timvideos/HDMI2USB-TOFE-VGA/README.md

# VGA TOFE Expansion Board

This repository contains a TOFE board for VGA capture based on 
[Rohit's vmodvga board](https://github.com/timvideos/HDMI2USB-vmodvga).

For [more information on the TOFE interface, see the HDMI2USB website](http://hdmi2usb.tv/tofe).
For the [KiCad website](http://kicad.org/) for more information on using it.

## Parts

The RCA Jack is a little hard to find, but it can be found at the following
locations (it is also totally optional);

 * [Element14](http://au.element14.com/pro-signal/mr-100h/socket-phono-pcb/dp/1267381) - Order Code: 1267381

## License

The contents of this repository excluding "third_party" folder is released
under your choice of the following two licences:

 * the "Creative Commons Attribution-ShareAlike 4.0 International License" (CC
   BY-SA 4.0) full text of this license is included in the LICENSE file and a
   copy can also be found at http://creativecommons.org/licenses/by-sa/4.0/

 * the "TAPR Open Hardware License" full text of this license is included in
   the LICENSE file and a copy can also be found at http://www.tapr.org/OHL

Both these licenses are "share and share alike" licenses and require **any**
derivative work to also be released. Please read the license fully to make sure
you comply with all your obligations.  

## Authors

This board has been a joint effort from many people, some of the major
contributors are;

 * Phyllis McKeever <mccircuit@yahoo.com>
 * Tim 'mithro' Ansell <mithro@mithis.com>
 * Kenny Duffus <kenny@duffus.org>
 * Rohit Kumar Singh <rohit@gmx.it>
 * Jahanzeb Ahmad <jahanzeb1982@gmail.com>

----

Original documentation from vmodvga board.

## Documentation

 * [Project blog](https://dreamsxtrinsic.blogspot.com/) for weekly and daily updates
 * [vMod-VGA Code Block Diagram](https://docs.google.com/drawings/d/1-_QcqhuEnqGTb0JCZim7DaP1v0BfKb7fcv-28n1iaC0/edit?usp=sharing)
 * [Code structure explained in this document](https://docs.google.com/document/d/11dfCeLtNUrjcst97REtgqLIln-_pKwHgGT3xKjOamxs/edit?usp=sharing)
 * [vMod-VGA VHDCI Pin Usage](https://docs.google.com/spreadsheets/d/1f-rBfR98f_ZZNIB7GFV79CGSHQNpj47uOU0JDwOJnV8/edit?usp=sharing)
 * [AD9984A Register Settings](https://docs.google.com/spreadsheets/d/1GH8NDtB8ceGhJEVZQujcXdxDPSw_wLqhg_3s436kkSs/edit?usp=sharing) for easier register settings
 * [Code Test points](https://docs.google.com/spreadsheets/d/12sMpliuKs6eSY12Fc8JHHKd0Y-Cz1OmEMRZJ5Vne3Vg/edit?usp=sharing) I compiled during whole project during
 * [Autodetection guidelines](https://docs.google.com/document/d/1ZhDz50rve5UmnmyKynxySLHqfFuOwBPM7pYFoHo9uvs/edit?usp=sharing)
 * [I2C Tools & Debugging](https://docs.google.com/document/d/1rNem5J1_V4QUOei_MHRzZVJfjsTon8fnE3eTlhzsrj8/edit?usp=sharing)
 * [PCB v02 Requirements Doc](https://docs.google.com/document/d/1EVi7m_RxV2RLTFDjguj92tawxPkJdG1kjHW0T4Z_cDw/edit?usp=sharing)
