timvideos/HDMI2USB-TOFE-VGA/eeprom/README.md

Tools for generating the EEPROM contents will be in this folder.

FIXME: Actually put something here.

We can probably reuse the work done by these two groups;

 * [Raspberry Pi Hat specification](https://github.com/raspberrypi/hats/tree/master/eepromutils)
 * [Beagleboard Cape specification](http://elinux.org/Beagleboard:Cape_Expansion_Headers#Cape_EEPROM_Contents)
