timvideos/HDMI2USB-TOFE-VGA/examples/hdmi-output-implementation/README.md

#vMod-VGA Development Test Codes

###Folder Structure

* hdl       : All HDL codes
  - hdmi    : HDMI (DVI) codes
  - misc    : Miscellaneous codes such Pattern generatir and Rising edge detector
  - uart    : UART Debugging code by Ajit
  - vga     : VGA Capture codes
* ipcore_dir: For IP Cores
* ise       : For all ise project files
* ucf       : User constraints
* i2c       : I2C Test codes for BeagleboneBlack
