timvideos/HDMI2USB-TOFE-VGA/examples/hdmi-output-implementation/ipcore_dir/UART_clk_flist.txt

# Output products list for <UART_clk>
UART_clk.asy
UART_clk.gise
UART_clk.sym
UART_clk.ucf
UART_clk.vhd
UART_clk.vho
UART_clk.xco
UART_clk.xdc
UART_clk.xise
UART_clk\clk_wiz_v3_6_readme.txt
UART_clk\doc\clk_wiz_v3_6_readme.txt
UART_clk\doc\clk_wiz_v3_6_vinfo.html
UART_clk\doc\pg065_clk_wiz.pdf
UART_clk\example_design\UART_clk_exdes.ucf
UART_clk\example_design\UART_clk_exdes.vhd
UART_clk\example_design\UART_clk_exdes.xdc
UART_clk\implement\implement.bat
UART_clk\implement\implement.sh
UART_clk\implement\planAhead_ise.bat
UART_clk\implement\planAhead_ise.sh
UART_clk\implement\planAhead_ise.tcl
UART_clk\implement\planAhead_rdn.bat
UART_clk\implement\planAhead_rdn.sh
UART_clk\implement\planAhead_rdn.tcl
UART_clk\implement\xst.prj
UART_clk\implement\xst.scr
UART_clk\simulation\UART_clk_tb.vhd
UART_clk\simulation\functional\simcmds.tcl
UART_clk\simulation\functional\simulate_isim.bat
UART_clk\simulation\functional\simulate_isim.sh
UART_clk\simulation\functional\simulate_mti.bat
UART_clk\simulation\functional\simulate_mti.do
UART_clk\simulation\functional\simulate_mti.sh
UART_clk\simulation\functional\simulate_ncsim.sh
UART_clk\simulation\functional\simulate_vcs.sh
UART_clk\simulation\functional\wave.do
UART_clk\simulation\functional\wave.sv
UART_clk\simulation\timing\UART_clk_tb.vhd
UART_clk\simulation\timing\sdf_cmd_file
UART_clk\simulation\timing\simcmds.tcl
UART_clk\simulation\timing\simulate_isim.sh
UART_clk\simulation\timing\simulate_mti.bat
UART_clk\simulation\timing\simulate_mti.do
UART_clk\simulation\timing\simulate_mti.sh
UART_clk\simulation\timing\simulate_ncsim.sh
UART_clk\simulation\timing\simulate_vcs.sh
UART_clk\simulation\timing\ucli_commands.key
UART_clk\simulation\timing\vcs_session.tcl
UART_clk\simulation\timing\wave.do
UART_clk_flist.txt
UART_clk_xmdf.tcl
