timvideos/HDMI2USB-TOFE-VGA/img/tofe-full-height.png

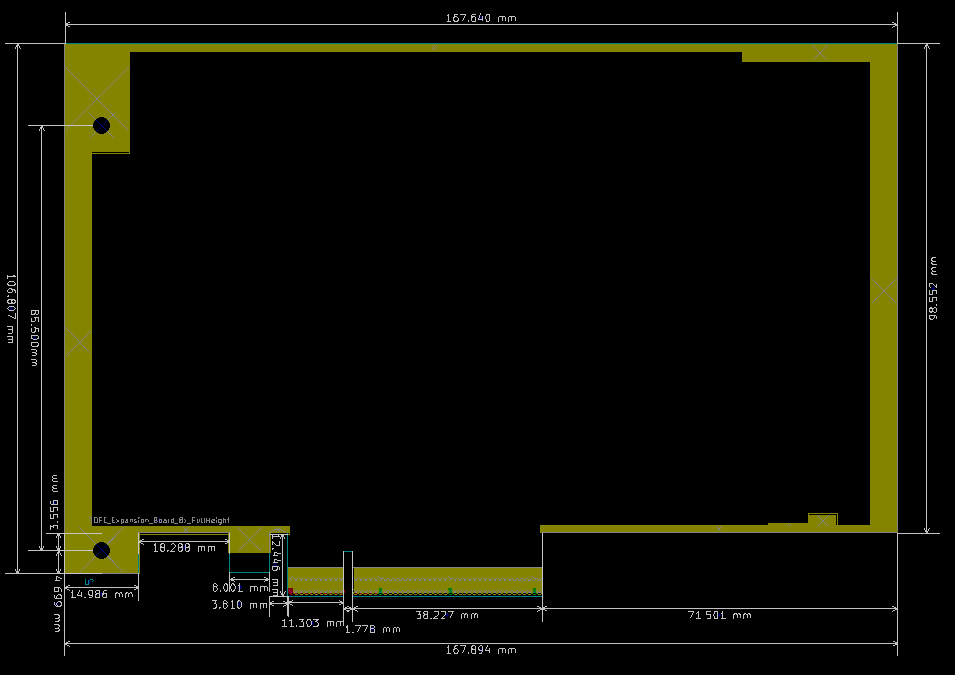
img/tofe-full-height.png
