timvideos/HDMI2USB-TOFE-VGA/img/tofe-half-height.png

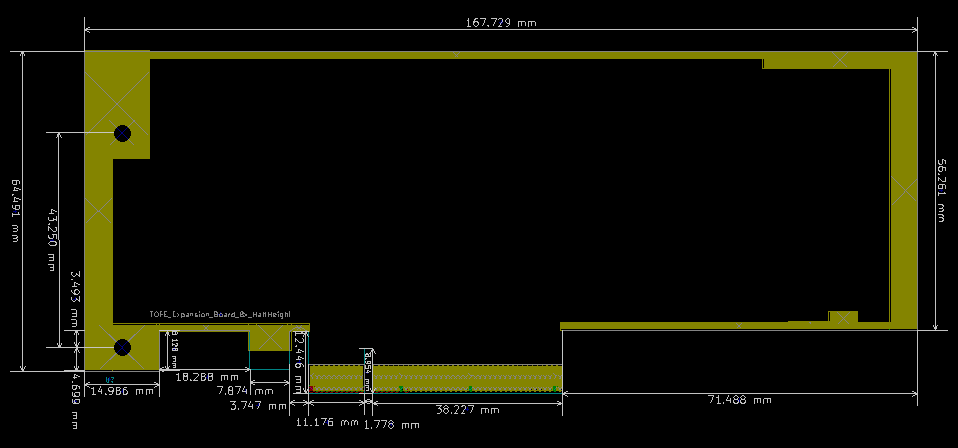
img/tofe-half-height.png
