timvideos/HDMI2USB-TOFE-VGA/(list of files, cad)

Other CAD files:
examples/hdmi-output-implementation/hdl/i2c/picoblaze/ad9984a_init.psm
examples/hdmi-output-implementation/hdl/i2c/picoblaze/ad9984a_init_bak.psm
examples/hdmi-output-implementation/hdl/i2c/picoblaze/ad9984a_init_pcf9574a_test.psm
examples/hdmi-output-implementation/hdl/i2c/picoblaze/i2c_routines.psm
examples/hdmi-output-implementation/hdl/i2c/picoblaze/soft_delays_100mhz.psm
