timvideos/HDMI2USB-TOFE-VGA/board/TOFE-VGA.pdf

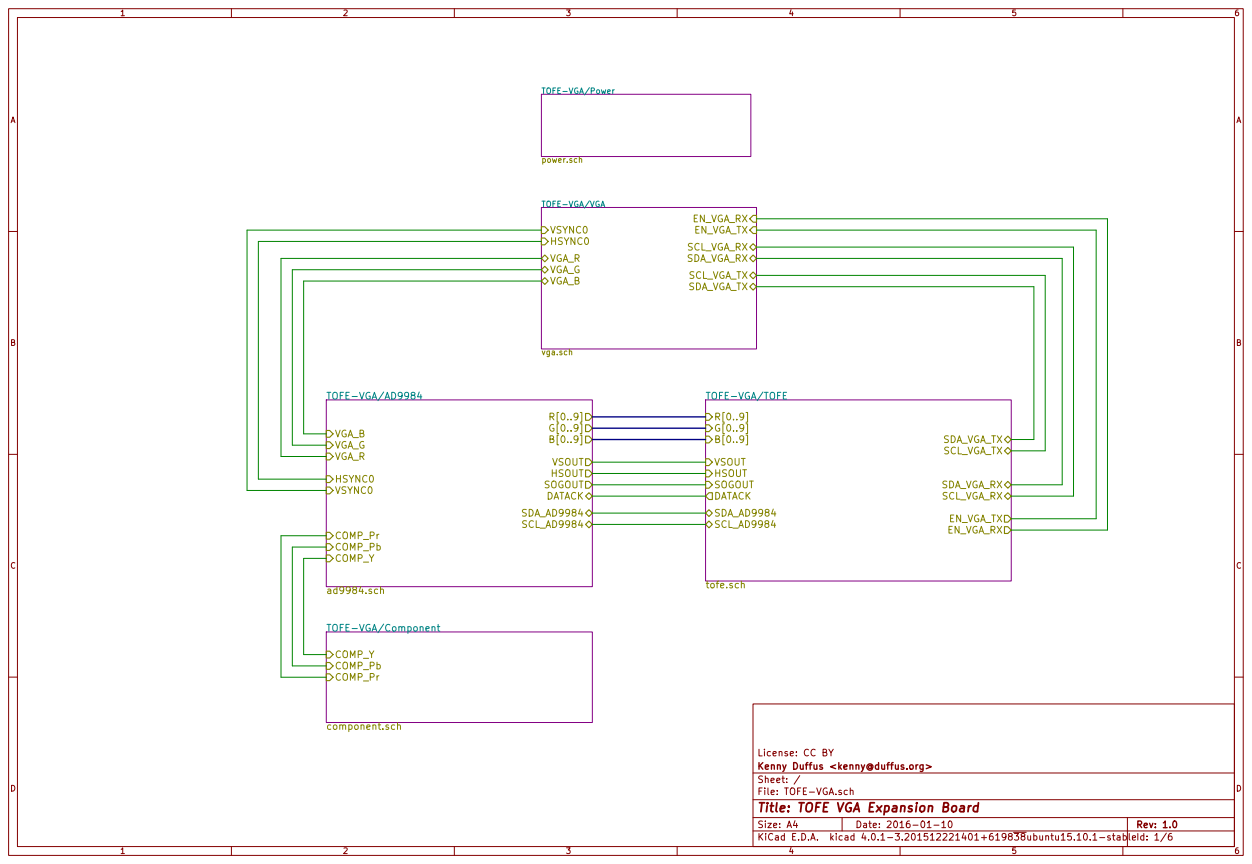
[picture p3: page 1]

TOFE-VGA/Power power.sch

License: CC BY
File: TOFE-VGA.sch Sheet: / Kenny Duffus <kenny@duffus.org>

Id: 1/6 Title: TOFE VGA Expansion Board

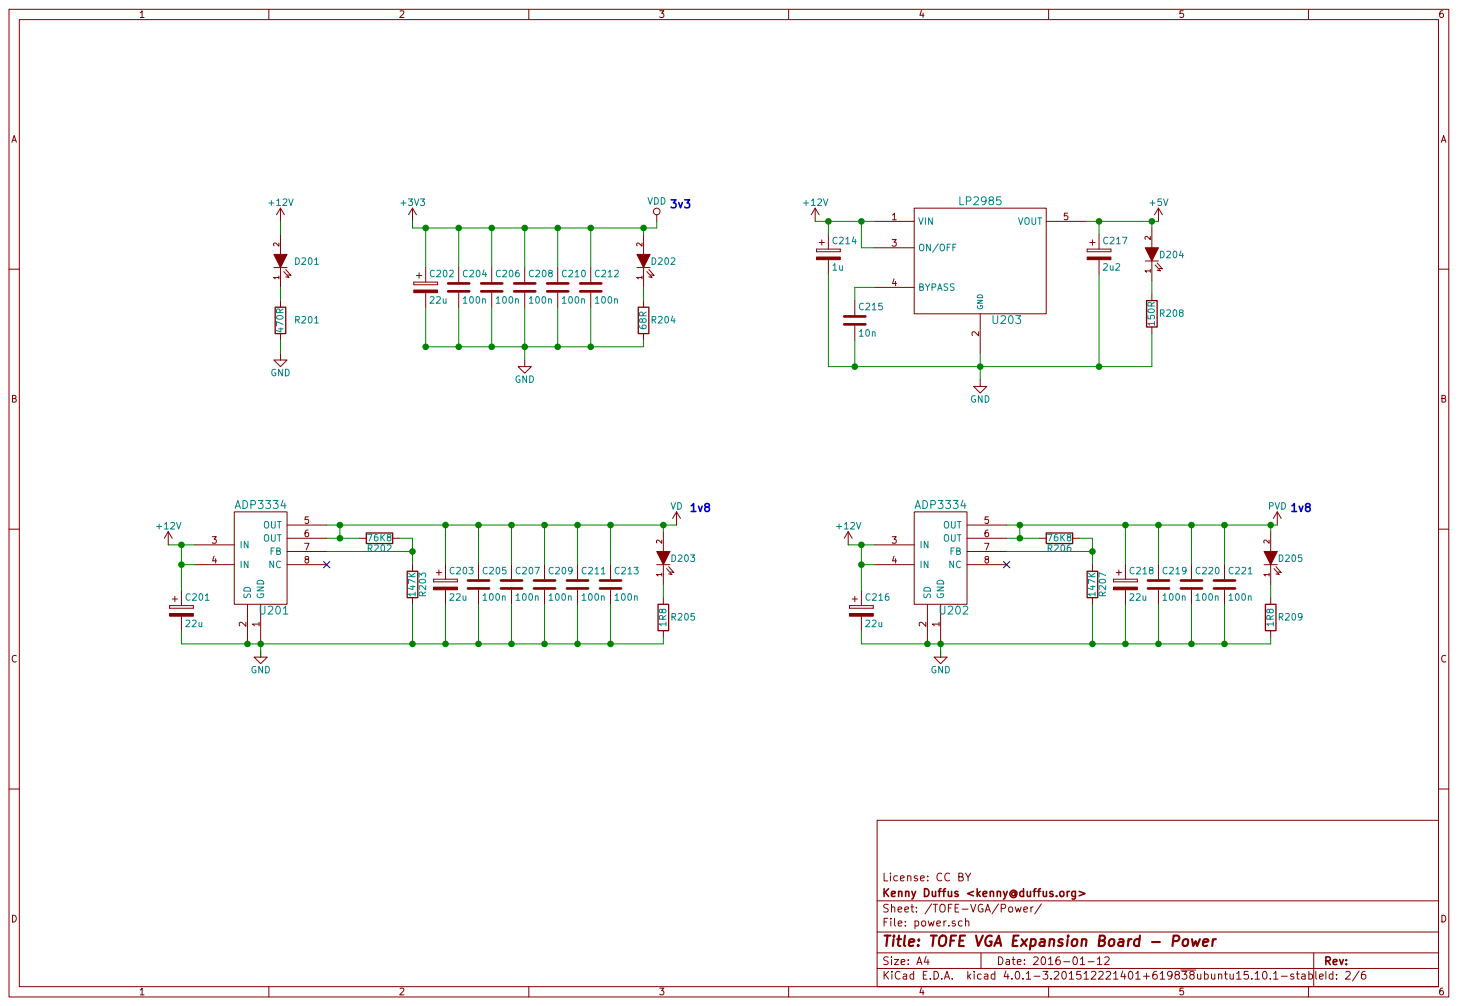
[picture p4: page 2]

2 ON/OFF 3 BYPASS 4 VOUT 5 U203

License: CC BY
File: power.sch Sheet: /TOFE-VGA/Power/ Kenny Duffus <kenny@duffus.org>

Id: 2/6 Title: TOFE VGA Expansion Board - Power

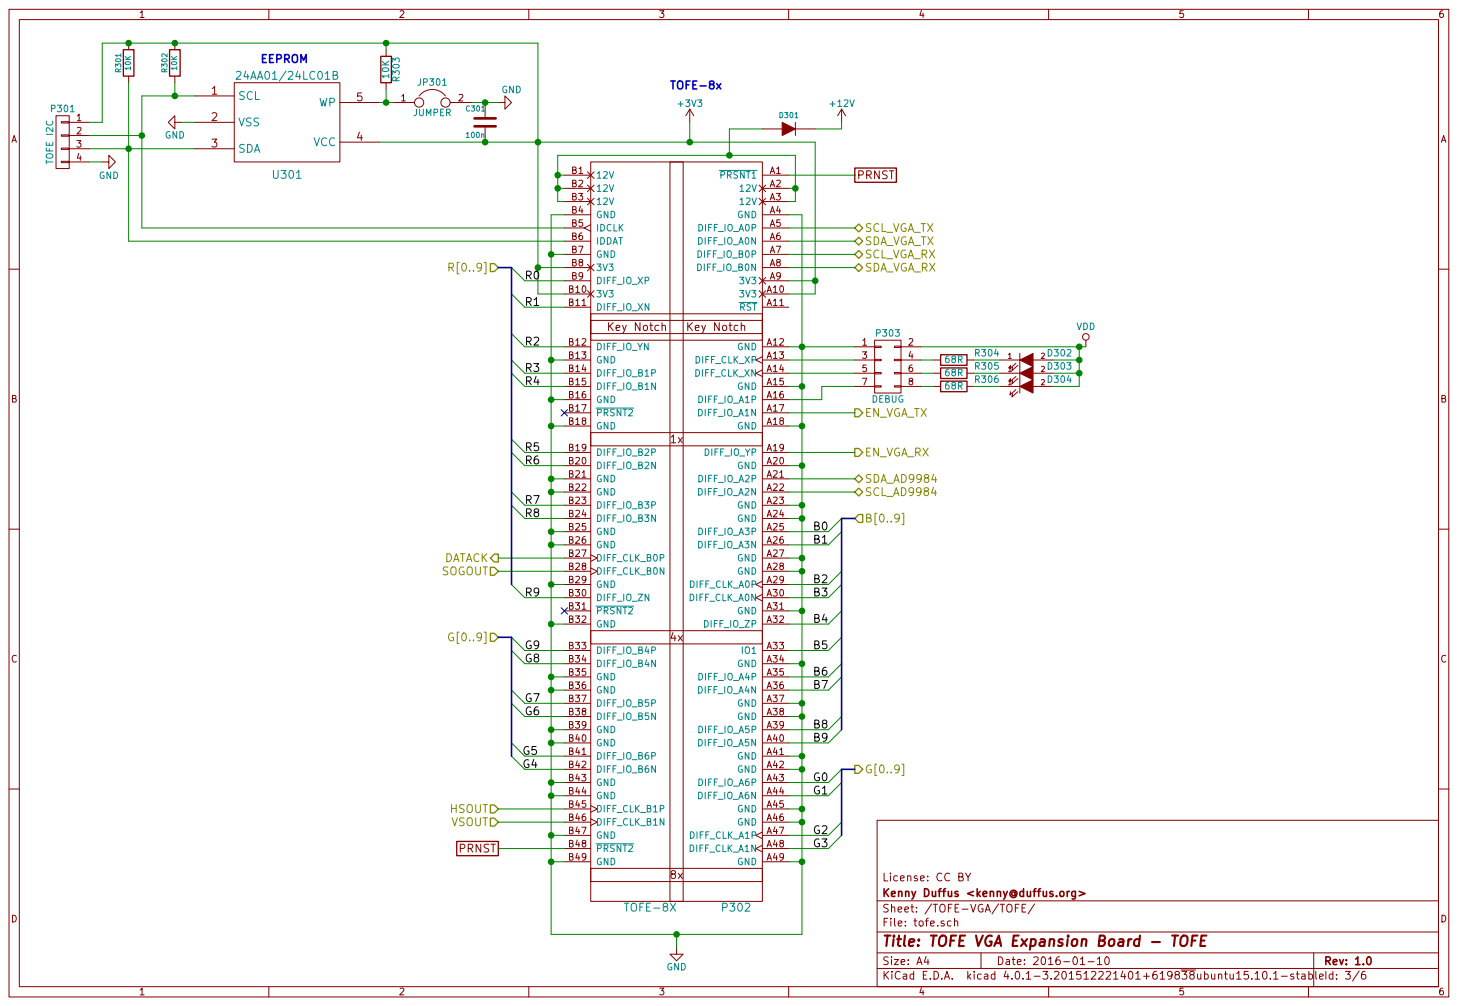
[picture p5: page 3]

License: CC BY
File: tofe.sch Sheet: /TOFE-VGA/TOFE/ Kenny Duffus <kenny@duffus.org>

Id: 3/6 Title: TOFE VGA Expansion Board - TOFE

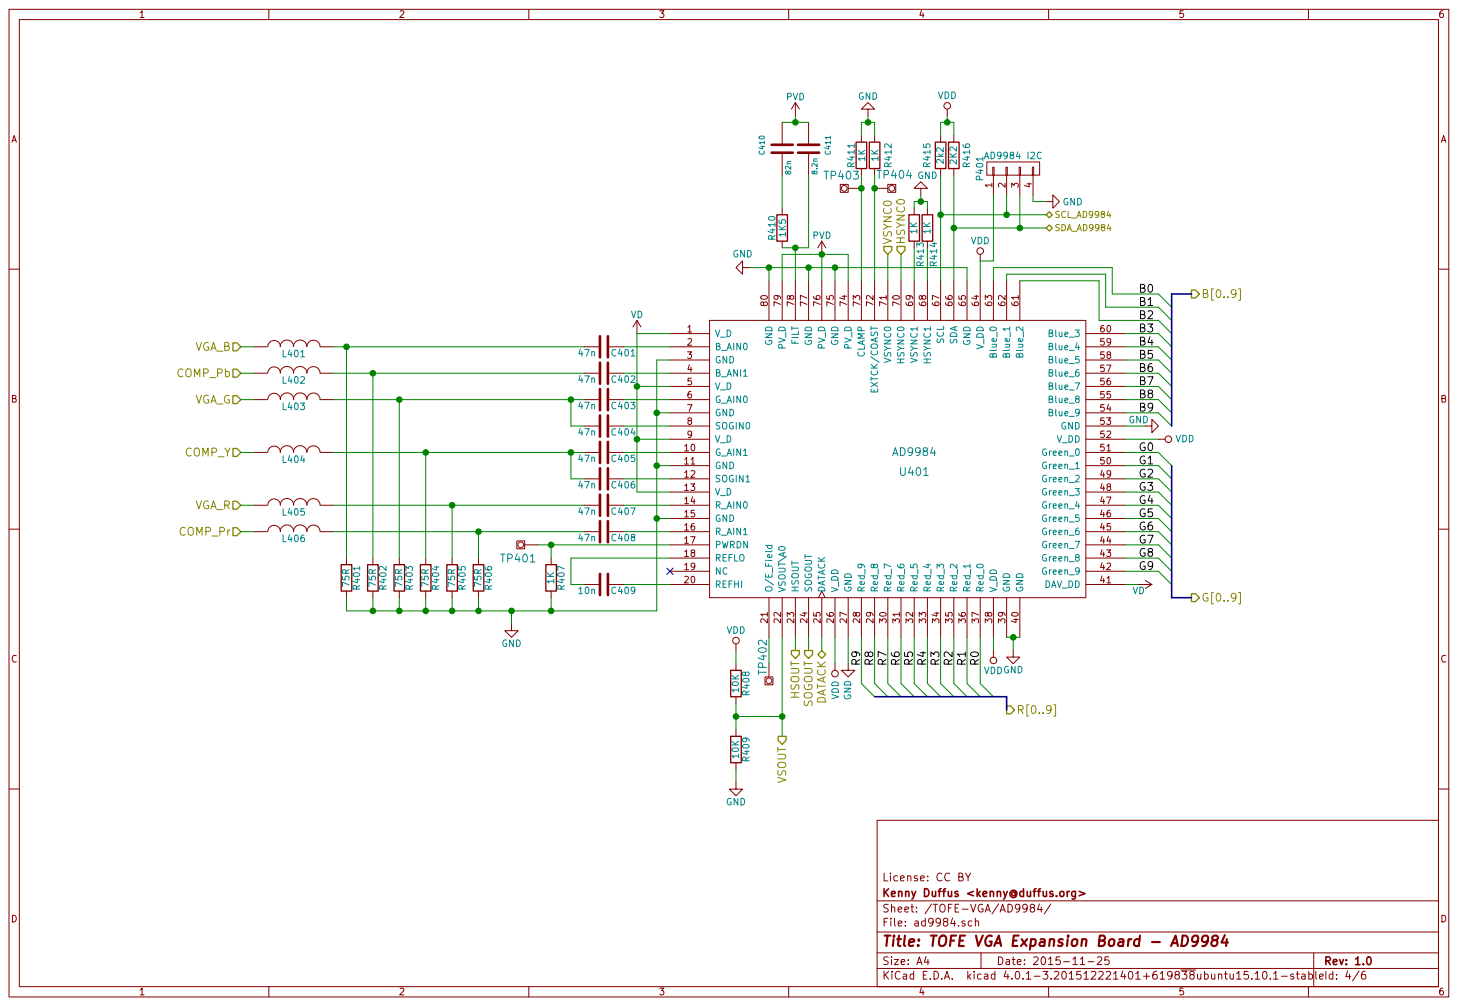
[picture p6: page 4]

License: CC BY
File: ad9984.sch Sheet: /TOFE-VGA/AD9984/ Kenny Duffus <kenny@duffus.org>

Id: 4/6 Title: TOFE VGA Expansion Board - AD9984

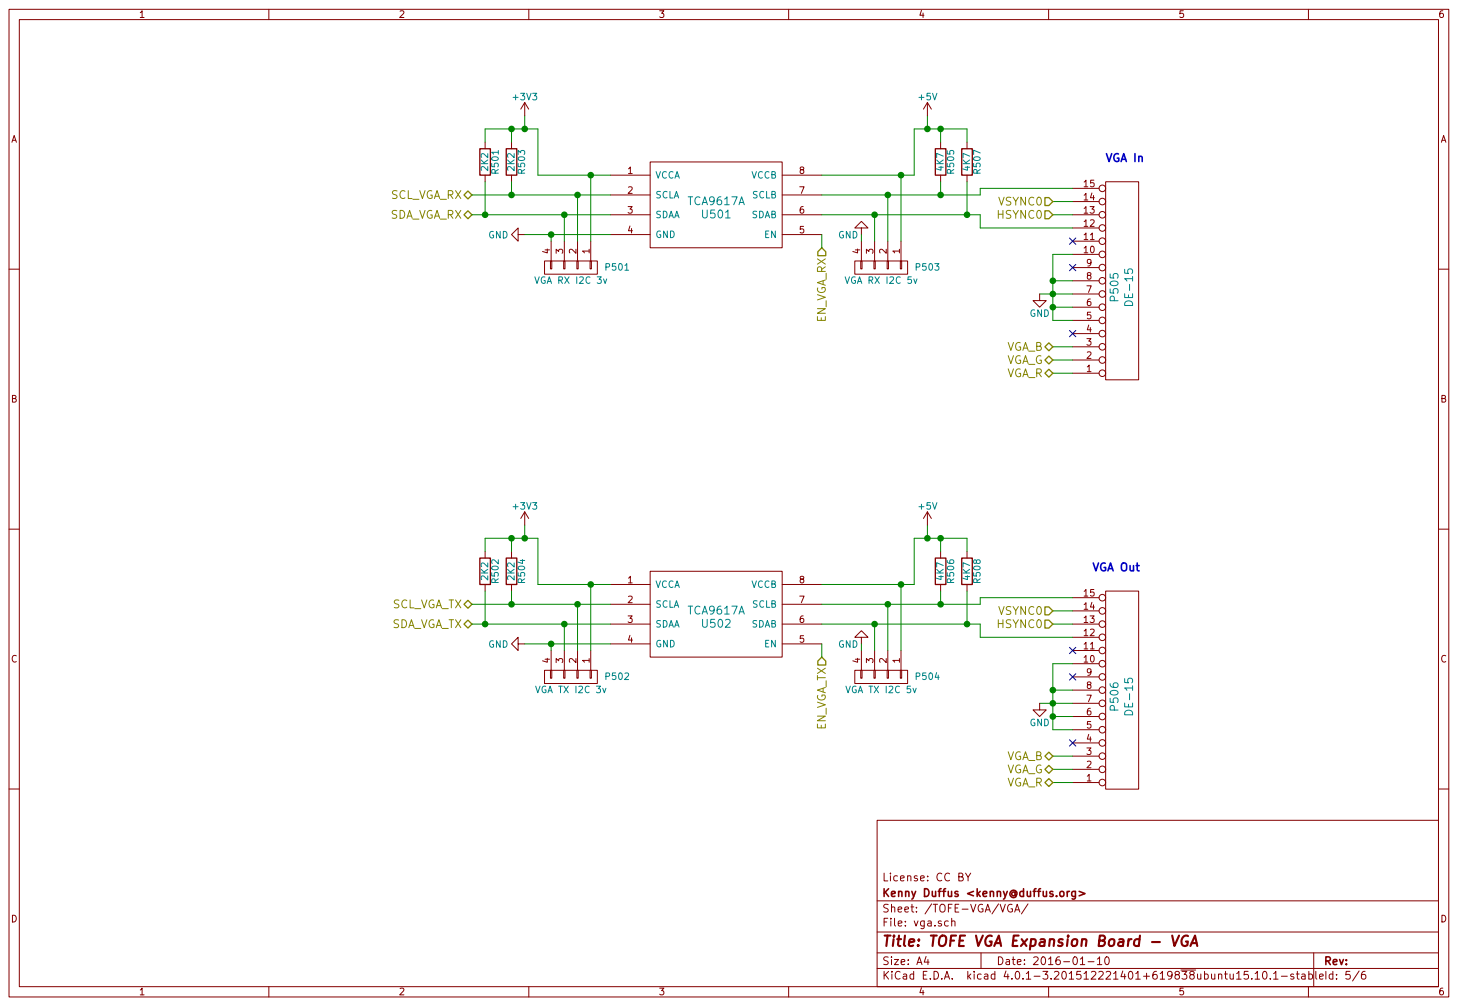
[picture p7: page 5]

File: vga.sch Sheet: /TOFE-VGA/VGA/ Kenny Duffus <kenny@duffus.org>

Id: 5/6 Title: TOFE VGA Expansion Board - VGA

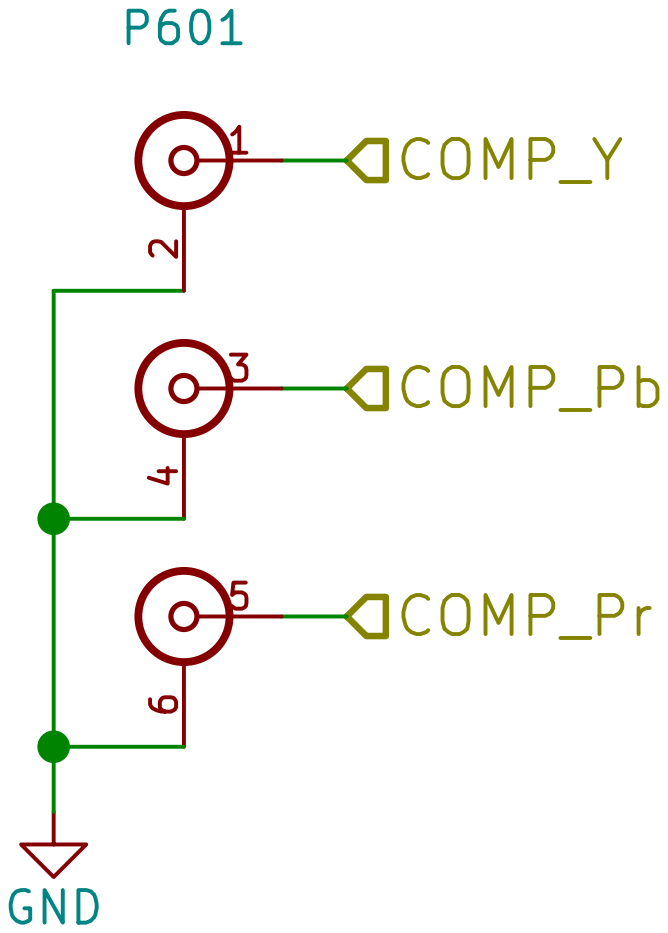
[picture p8: page 6]

Kenny Duffus <kenny@duffus.org>
Sheet: /TOFE-VGA/Component/
File: component.sch
Id: 6/6 Title: TOFE VGA - Component
