timvideos/HDMI2USB-TOFE-VGA/docs/R-HI-008068-2_plug.pdf

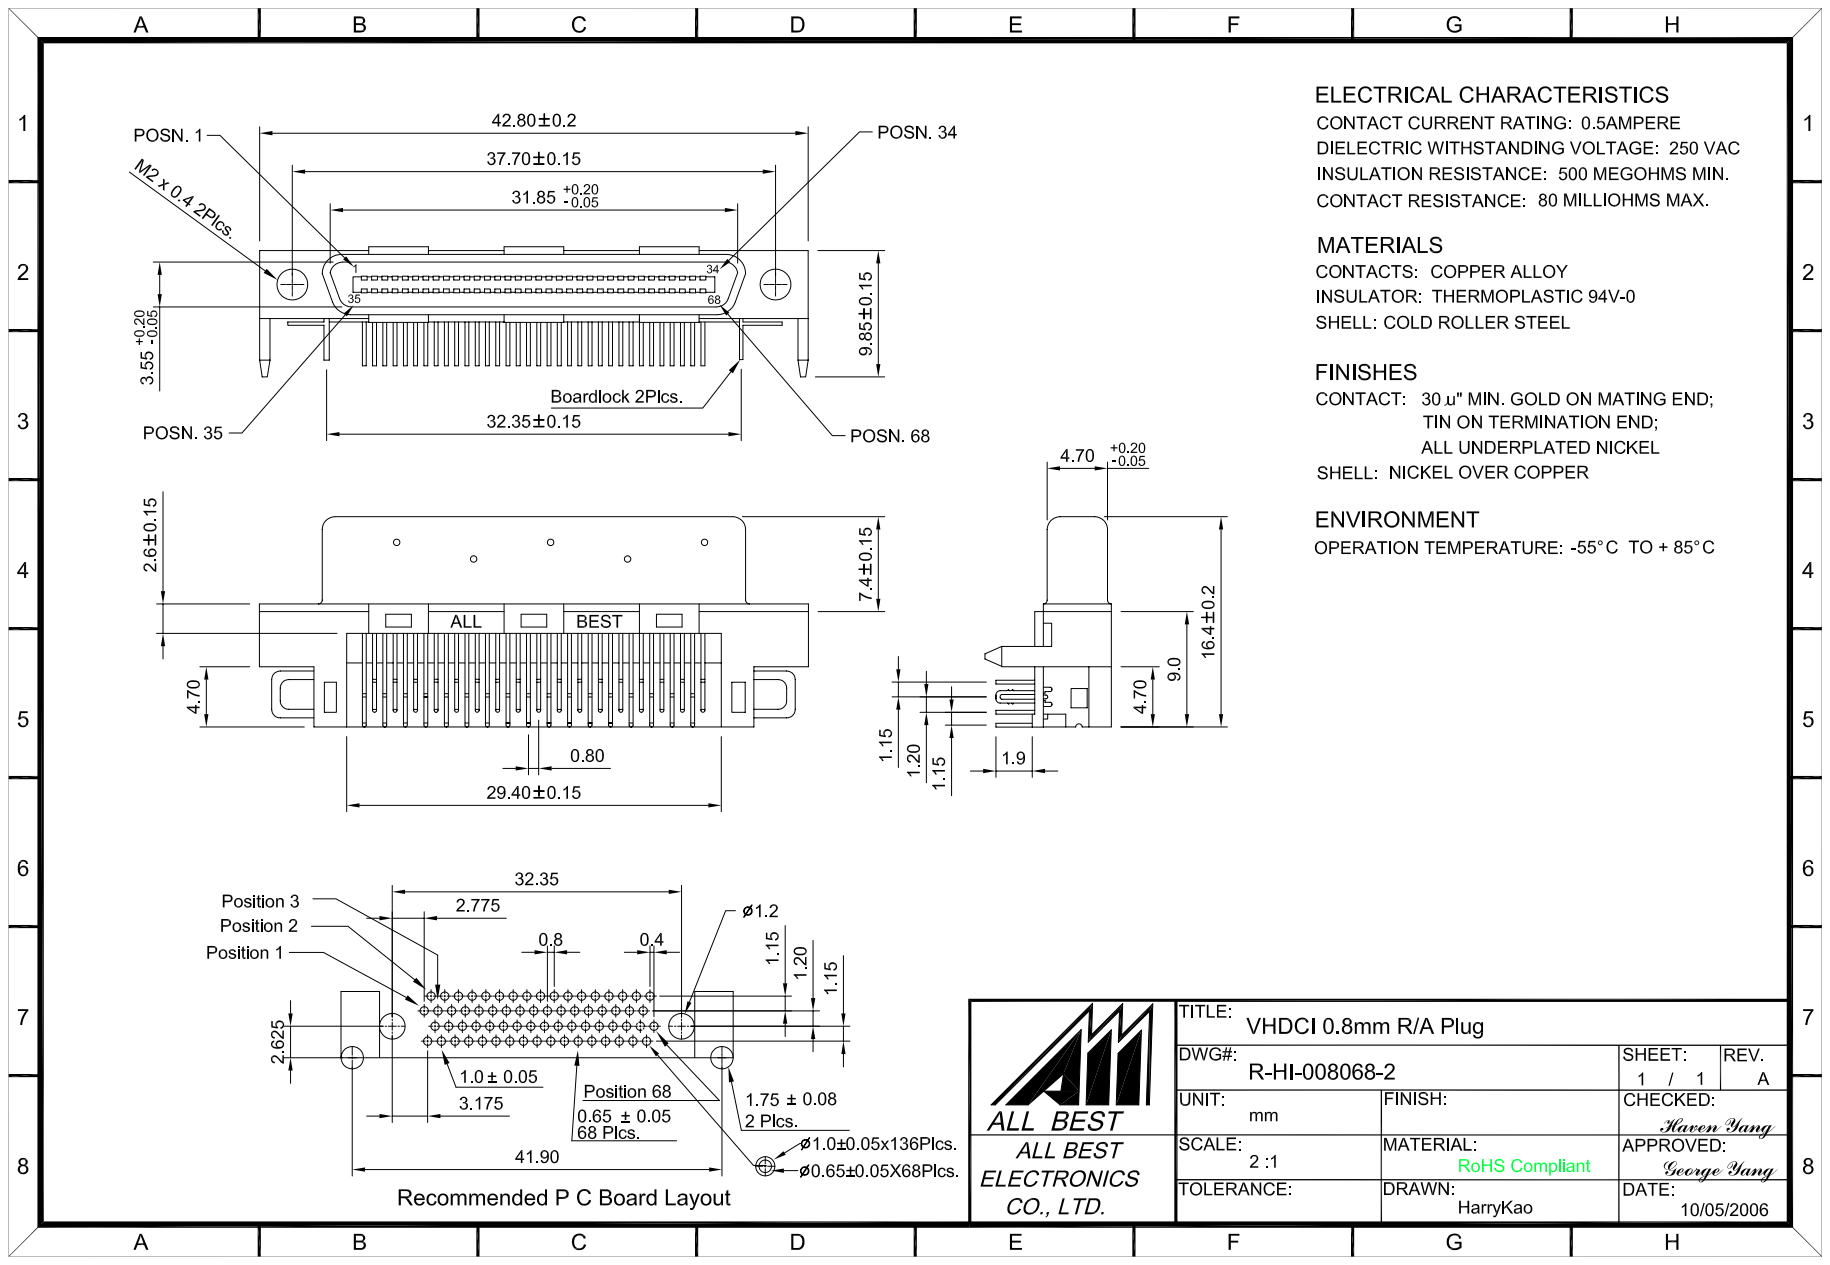
[picture p9: page 1]
