timvideos/HDMI2USB-TOFE-VGA/board/TOFE-VGA.kicad_pcb

## KiCad design board/TOFE-VGA.kicad_pcb (2016-10-03)

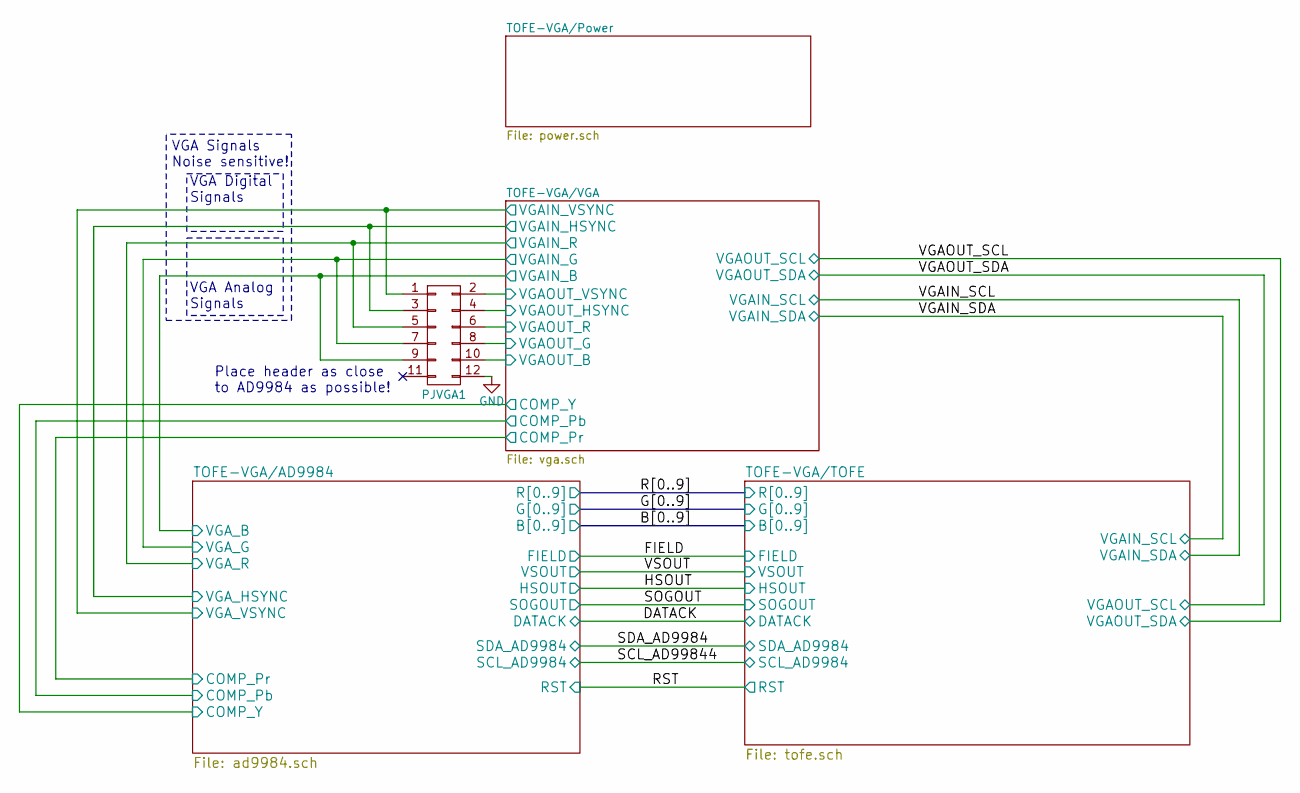
[picture p10: schematic TOFE-VGA.sch, TOFE VGA Expansion Board]

Parts:
PJVGA1: CONN_02X06; Pin_Header_Straight_2x06

Connections:
/TOFE-VGA/VGA/VGAIN_B: PJVGA1.9; also elsewhere on the board
/TOFE-VGA/VGA/VGAIN_G: PJVGA1.7; also elsewhere on the board
/TOFE-VGA/VGA/VGAIN_HSYNC: PJVGA1.3; also elsewhere on the board
/TOFE-VGA/VGA/VGAIN_R: PJVGA1.5; also elsewhere on the board
/TOFE-VGA/VGA/VGAIN_VSYNC: PJVGA1.1; also elsewhere on the board
/TOFE-VGA/VGA/VGAOUT_B: PJVGA1.10; also elsewhere on the board
/TOFE-VGA/VGA/VGAOUT_G: PJVGA1.8; also elsewhere on the board
/TOFE-VGA/VGA/VGAOUT_HSYNC: PJVGA1.4; also elsewhere on the board
/TOFE-VGA/VGA/VGAOUT_R: PJVGA1.6; also elsewhere on the board
/TOFE-VGA/VGA/VGAOUT_VSYNC: PJVGA1.2; also elsewhere on the board
GND: PJVGA1.12; also elsewhere on the board

Notes on the sheet:
VGA Signals Noise sensitive!
VGA Analog Signals
Place header as close to AD9984 as possible!
VGA Digital Signals

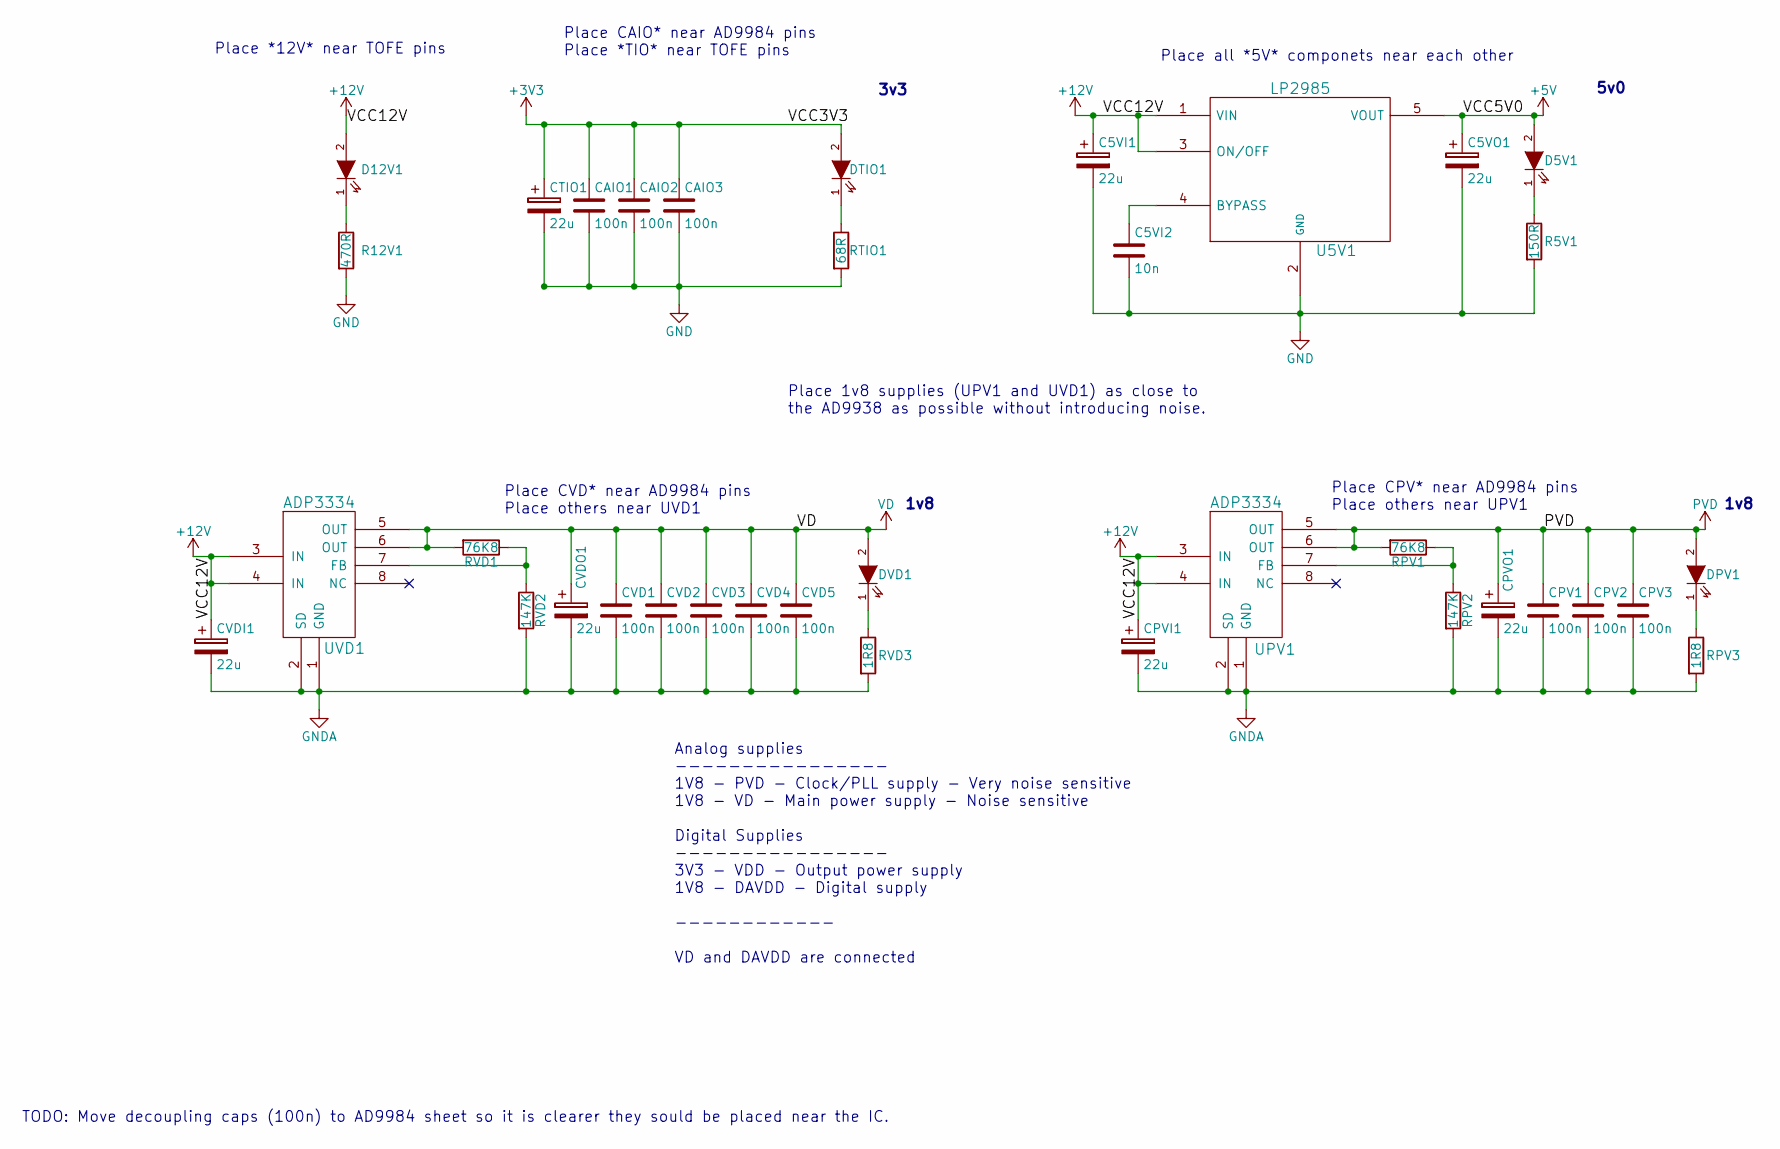
[picture p11: schematic power.sch, TOFE VGA Expansion Board - Power]

Parts:
C5VI1, C5VO1: 22u; c_elec_4x5.8
C5VI2: 10n; C_0805_HandSoldering
CAIO1, CAIO2, CAIO3: 100n; C_0805_HandSoldering
CPV1, CPV2, CPV3: 100n; C_0805_HandSoldering
CPVI1: 22u; c_elec_4x5.8
CPVO1: 22u; c_elec_4x5.8
CTIO1: 22u; c_elec_4x5.8
CVD1, CVD2, CVD3, CVD4, CVD5: 100n; C_0805_HandSoldering
CVDI1: 22u; c_elec_4x5.8
CVDO1: 22u; c_elec_4x5.8
D5V1, D12V1: LED; LED_0805
DPV1: LED; LED_0805
DTIO1: LED; LED_0805
DVD1: LED; LED_0805
R5V1: 150R; R_0603_HandSoldering
R12V1: 470R; R_0603_HandSoldering
RPV1: 76K8; R_0603_HandSoldering
RPV2: 147K; R_0603_HandSoldering
RPV3: 1R8; R_0603_HandSoldering
RTIO1: 68R; R_0603_HandSoldering
RVD1: 76K8; R_0603_HandSoldering
RVD2: 147K; R_0603_HandSoldering
RVD3: 1R8; R_0603_HandSoldering
U5V1: LP2985; SOT-23-5
UPV1: ADP3334; MSOP-8_3x3mm_Pitch0.65mm
UVD1: ADP3334; MSOP-8_3x3mm_Pitch0.65mm

Connections:
+3V3: CAIO1.1, CAIO2.1, CAIO3.1, CTIO1.1, DTIO1.2 (A); also elsewhere on the board
+5V: C5VO1.1, D5V1.2 (A), U5V1.5 (VOUT); also elsewhere on the board
+12V: C5VI1.1, CPVI1.1, CVDI1.1, D12V1.2 (A), U5V1.1 (VIN), U5V1.3 (ON/OFF), UPV1.3 (IN), UPV1.4 (IN), UVD1.3 (IN), UVD1.4 (IN); also elsewhere on the board
GND: C5VI1.2, C5VI2.2, C5VO1.2, CAIO1.2, CAIO2.2, CAIO3.2, CTIO1.2, R5V1.2, R12V1.2, RTIO1.2, U5V1.2 (GND); also elsewhere on the board
GNDA: CPV1.2, CPV2.2, CPV3.2, CPVI1.2, CPVO1.2, CVD1.2, CVD2.2, CVD3.2, CVD4.2, CVD5.2, CVDI1.2, CVDO1.2, RPV2.2, RPV3.2, RVD2.2, RVD3.2, UPV1.1 (GND), UPV1.2 (SD), UVD1.1 (GND), UVD1.2 (SD); also elsewhere on the board
unnamed: C5VI2.1, U5V1.4 (BYPASS)
unnamed: D5V1.1 (K), R5V1.1
unnamed: D12V1.1 (K), R12V1.1
unnamed: DPV1.1 (K), RPV3.1
unnamed: DTIO1.1 (K), RTIO1.1
unnamed: DVD1.1 (K), RVD3.1
unnamed: RPV1.1, RPV2.1, UPV1.7 (FB)
unnamed: RVD1.1, RVD2.1, UVD1.7 (FB)
PVD: CPV1.1, CPV2.1, CPV3.1, CPVO1.1, DPV1.2 (A), RPV1.2, UPV1.5 (OUT), UPV1.6 (OUT); also elsewhere on the board
VD: CVD1.1, CVD2.1, CVD3.1, CVD4.1, CVD5.1, CVDO1.1, DVD1.2 (A), RVD1.2, UVD1.5 (OUT), UVD1.6 (OUT); also elsewhere on the board

Notes on the sheet:
3v3
1v8
5v0
Analog supplies ---------------- 1V8 - PVD - Clock/PLL supply - Very noise sensitive 1V8 - VD - Main power supply - Noise sensitive Digital Supplies ---------------- 3V3 - VDD - Output power supply 1V8 - DAVDD - Digital supply ------------ VD and DAVDD are connected
Place CPV* near AD9984 pins Place others near UPV1
Place CVD* near AD9984 pins Place others near UVD1
Place CAIO* near AD9984 pins Place *TIO* near TOFE pins
Place all *5V* componets near each other
Place *12V* near TOFE pins
TODO: Move decoupling caps (100n) to AD9984 sheet so it is clearer they sould be placed near the IC.
Place 1v8 supplies (UPV1 and UVD1) as close to the AD9938 as possible without introducing noise.

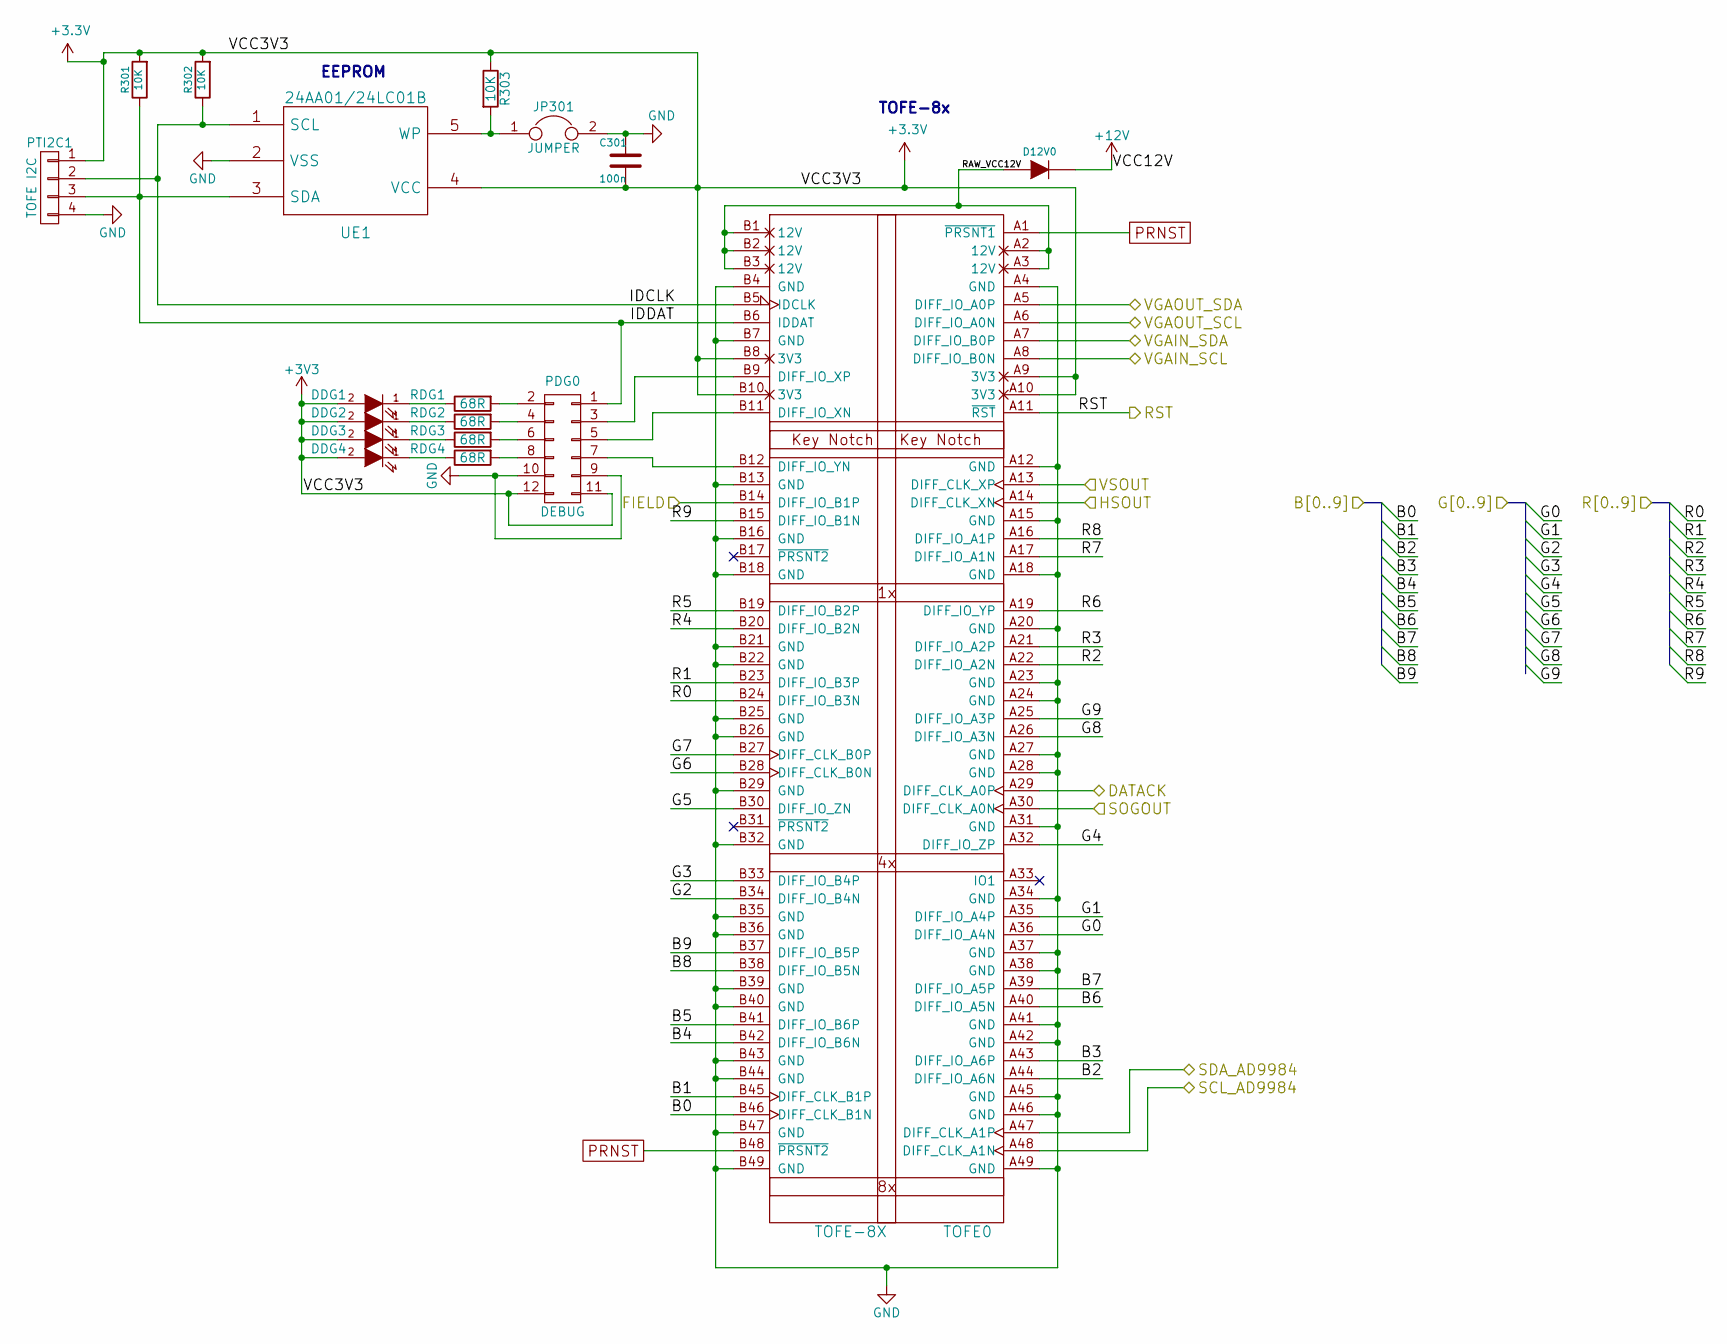
[picture p12: schematic tofe.sch, TOFE VGA Expansion Board - TOFE]

Parts:
C301: 100n; C_0805_HandSoldering
D12V0: DIODE; SMB_Handsoldering
DDG1, DDG2, DDG3, DDG4: LED; LED_0805
JP301: JUMPER; HARWIN-M20-87-2x1
PDG0: DEBUG; Pin_Header_Straight_2x06
PTI2C1: TOFE I2C; HARWIN-M20-87-4x1
R301, R302, R303: 10K; R_0603_HandSoldering
RDG1, RDG2, RDG3, RDG4: 68R; R_0603_HandSoldering
TOFE0: TOFE-8X; TOFE_8X_HalfHeight
UE1: 24AA01/24LC01B; SOT-23-5

Connections:
+3V3: C301.2, DDG1.2 (A), DDG2.2 (A), DDG3.2 (A), DDG4.2 (A), PDG0.11, PDG0.12, PTI2C1.1, R301.2, R302.2, R303.1, TOFE0.A9 (3V3), TOFE0.A10 (3V3), TOFE0.B8 (3V3), TOFE0.B10 (3V3), UE1.4 (VCC); also elsewhere on the board
+12V: D12V0.2 (K); also elsewhere on the board
/DATACK: TOFE0.A29 (DIFF_CLK_A0P); also elsewhere on the board
/FIELD: TOFE0.B14 (DIFF_IO_B1P); also elsewhere on the board
/HSOUT: TOFE0.A14 (DIFF_CLK_XN); also elsewhere on the board
/RST: TOFE0.A11 (~RST); also elsewhere on the board
/SCL_AD99844: TOFE0.A48 (DIFF_CLK_A1N); also elsewhere on the board
/SDA_AD9984: TOFE0.A47 (DIFF_CLK_A1P); also elsewhere on the board
/SOGOUT: TOFE0.A30 (DIFF_CLK_A0N); also elsewhere on the board
/TOFE-VGA/AD9984/B0: TOFE0.B46 (DIFF_CLK_B1N); also elsewhere on the board
/TOFE-VGA/AD9984/B1: TOFE0.B45 (DIFF_CLK_B1P); also elsewhere on the board
/TOFE-VGA/AD9984/B2: TOFE0.A44 (DIFF_IO_A6N); also elsewhere on the board
/TOFE-VGA/AD9984/B3: TOFE0.A43 (DIFF_IO_A6P); also elsewhere on the board
/TOFE-VGA/AD9984/B4: TOFE0.B42 (DIFF_IO_B6N); also elsewhere on the board
/TOFE-VGA/AD9984/B5: TOFE0.B41 (DIFF_IO_B6P); also elsewhere on the board
/TOFE-VGA/AD9984/B6: TOFE0.A40 (DIFF_IO_A5N); also elsewhere on the board
/TOFE-VGA/AD9984/B7: TOFE0.A39 (DIFF_IO_A5P); also elsewhere on the board
/TOFE-VGA/AD9984/B8: TOFE0.B38 (DIFF_IO_B5N); also elsewhere on the board
/TOFE-VGA/AD9984/B9: TOFE0.B37 (DIFF_IO_B5P); also elsewhere on the board
/TOFE-VGA/AD9984/G0: TOFE0.A36 (DIFF_IO_A4N); also elsewhere on the board
/TOFE-VGA/AD9984/G1: TOFE0.A35 (DIFF_IO_A4P); also elsewhere on the board
/TOFE-VGA/AD9984/G2: TOFE0.B34 (DIFF_IO_B4N); also elsewhere on the board
/TOFE-VGA/AD9984/G3: TOFE0.B33 (DIFF_IO_B4P); also elsewhere on the board
/TOFE-VGA/AD9984/G4: TOFE0.A32 (DIFF_IO_ZP); also elsewhere on the board
/TOFE-VGA/AD9984/G5: TOFE0.B30 (DIFF_IO_ZN); also elsewhere on the board
/TOFE-VGA/AD9984/G6: TOFE0.B28 (DIFF_CLK_B0N); also elsewhere on the board
/TOFE-VGA/AD9984/G7: TOFE0.B27 (DIFF_CLK_B0P); also elsewhere on the board
/TOFE-VGA/AD9984/G8: TOFE0.A26 (DIFF_IO_A3N); also elsewhere on the board
/TOFE-VGA/AD9984/G9: TOFE0.A25 (DIFF_IO_A3P); also elsewhere on the board
/TOFE-VGA/AD9984/R0: TOFE0.B24 (DIFF_IO_B3N); also elsewhere on the board
/TOFE-VGA/AD9984/R1: TOFE0.B23 (DIFF_IO_B3P); also elsewhere on the board
/TOFE-VGA/AD9984/R2: TOFE0.A22 (DIFF_IO_A2N); also elsewhere on the board
/TOFE-VGA/AD9984/R3: TOFE0.A21 (DIFF_IO_A2P); also elsewhere on the board
/TOFE-VGA/AD9984/R4: TOFE0.B20 (DIFF_IO_B2N); also elsewhere on the board
/TOFE-VGA/AD9984/R5: TOFE0.B19 (DIFF_IO_B2P); also elsewhere on the board
/TOFE-VGA/AD9984/R6: TOFE0.A19 (DIFF_IO_YP); also elsewhere on the board
/TOFE-VGA/AD9984/R7: TOFE0.A17 (DIFF_IO_A1N); also elsewhere on the board
/TOFE-VGA/AD9984/R8: TOFE0.A16 (DIFF_IO_A1P); also elsewhere on the board
/TOFE-VGA/AD9984/R9: TOFE0.B15 (DIFF_IO_B1N); also elsewhere on the board
/TOFE-VGA/TOFE/IDCLK: PTI2C1.2, R302.1, TOFE0.B5 (IDCLK), UE1.1 (SCL); also elsewhere on the board
/TOFE-VGA/TOFE/IDDAT: PDG0.1, PTI2C1.3, R301.1, TOFE0.B6 (IDDAT), UE1.3 (SDA); also elsewhere on the board
/TOFE-VGA/TOFE/RAW_VCC12V: D12V0.1 (A), TOFE0.A2 (12V), TOFE0.A3 (12V), TOFE0.B1 (12V), TOFE0.B2 (12V), TOFE0.B3 (12V); also elsewhere on the board
/VGAIN_SCL: TOFE0.A7 (DIFF_IO_B0P); also elsewhere on the board
/VGAIN_SDA: TOFE0.A8 (DIFF_IO_B0N); also elsewhere on the board
/VGAOUT_SCL: TOFE0.A5 (DIFF_IO_A0P); also elsewhere on the board
/VGAOUT_SDA: TOFE0.A6 (DIFF_IO_A0N); also elsewhere on the board
/VSOUT: TOFE0.A13 (DIFF_CLK_XP); also elsewhere on the board
GND: C301.1, JP301.2, PDG0.9, PDG0.10, PTI2C1.4, TOFE0.A4 (GND), TOFE0.A12 (GND), TOFE0.A15 (GND), TOFE0.A18 (GND), TOFE0.A20 (GND), TOFE0.A23 (GND), TOFE0.A24 (GND), TOFE0.A27 (GND), TOFE0.A28 (GND), TOFE0.A31 (GND), TOFE0.A34 (GND), TOFE0.A37 (GND), TOFE0.A38 (GND), TOFE0.A41 (GND), TOFE0.A42 (GND), TOFE0.A45 (GND), TOFE0.A46 (GND), TOFE0.A49 (GND), TOFE0.B4 (GND), TOFE0.B7 (GND), TOFE0.B13 (GND), TOFE0.B16 (GND), TOFE0.B18 (GND), TOFE0.B21 (GND), TOFE0.B22 (GND), TOFE0.B25 (GND), TOFE0.B26 (GND), TOFE0.B29 (GND), TOFE0.B32 (GND), TOFE0.B35 (GND), TOFE0.B36 (GND), TOFE0.B39 (GND), TOFE0.B40 (GND), TOFE0.B43 (GND), TOFE0.B44 (GND), TOFE0.B47 (GND), TOFE0.B49 (GND), UE1.2 (VSS); also elsewhere on the board
unnamed: DDG1.1 (K), RDG1.1
unnamed: DDG2.1 (K), RDG2.1
unnamed: DDG3.1 (K), RDG3.1
unnamed: DDG4.1 (K), RDG4.1
unnamed: JP301.1, R303.2, UE1.5 (WP)
unnamed: PDG0.2, RDG1.2
unnamed: PDG0.3, TOFE0.B9 (DIFF_IO_XP)
unnamed: PDG0.4, RDG2.2
unnamed: PDG0.5, TOFE0.B11 (DIFF_IO_XN)
unnamed: PDG0.6, RDG3.2
unnamed 124: PDG0.7, TOFE0.B12 (DIFF_IO_YN); also elsewhere on the board
unnamed: PDG0.8, RDG4.2
unnamed 139: TOFE0.A33 (IO1); also elsewhere on the board
unnamed 140: TOFE0.B17 (~PRSNT2); also elsewhere on the board
unnamed 141: TOFE0.B31 (~PRSNT2); also elsewhere on the board
PRNST: TOFE0.A1 (~PRSNT1), TOFE0.B48 (~PRSNT2); also elsewhere on the board

Notes on the sheet:
TOFE-8x
EEPROM

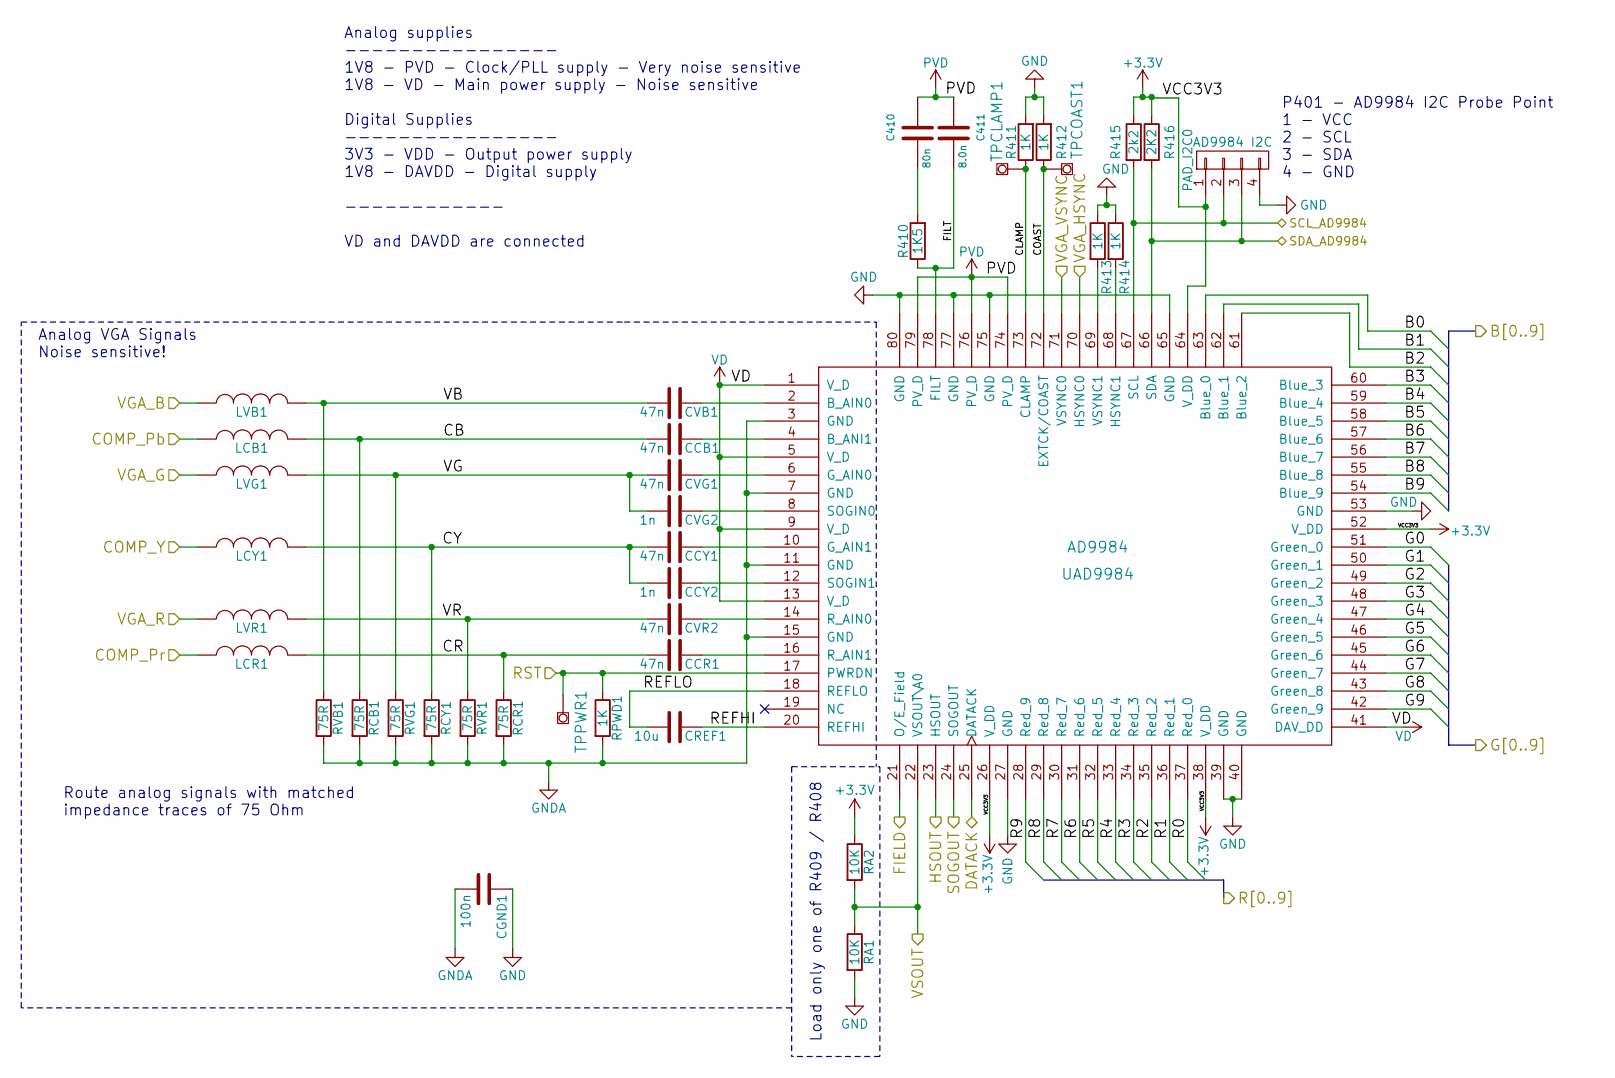
[picture p13: schematic ad9984.sch, TOFE VGA Expansion Board - AD9984]

Parts:
C410: 80n; C_0805_HandSoldering
C411: 8.0n; C_0805_HandSoldering
CCB1: 47n; C_0805_HandSoldering
CCR1: 47n; C_0805_HandSoldering
CCY1: 47n; C_0805_HandSoldering
CCY2: 1n; C_0805_HandSoldering
CGND1: 100n; C_0805_HandSoldering
CREF1: 10u; C_0805_HandSoldering
CVB1: 47n; C_0805_HandSoldering
CVG1: 47n; C_0805_HandSoldering
CVG2: 1n; C_0805_HandSoldering
CVR2: 47n; C_0805_HandSoldering
LCB1: FERRITE; R_0805_HandSoldering
LCR1: FERRITE; R_0805_HandSoldering
LCY1: FERRITE; R_0805_HandSoldering
LVB1: FERRITE; R_0805_HandSoldering
LVG1: FERRITE; R_0805_HandSoldering
LVR1: FERRITE; R_0805_HandSoldering
PAD_I2C0: AD9984 I2C; HARWIN-M20-87-4x1
R410: 1K5; R_0603_HandSoldering
R411, R412, R413, R414: 1K; R_0603_HandSoldering
R415: 2k2; R_0603_HandSoldering
R416: 2K2; R_0603_HandSoldering
RA1, RA2: 10K; R_0603_HandSoldering
RCB1: 75R; R_0603_HandSoldering
RCR1: 75R; R_0603_HandSoldering
RCY1: 75R; R_0603_HandSoldering
RPWD1: 1K; R_0603_HandSoldering
RVB1: 75R; R_0603_HandSoldering
RVG1: 75R; R_0603_HandSoldering
RVR1: 75R; R_0603_HandSoldering
TPCLAMP1: TESTPOINT; 2MM-TESTPOINT
TPCOAST1: TESTPOINT; 2MM-TESTPOINT
TPPWR1: TESTPOINT; 2MM-TESTPOINT
UAD9984: AD9984; analog-devices2-LQFP80

Connections:
+3V3: PAD_I2C0.1, R415.1, R416.1, RA2.1, UAD9984.26 (V_DD), UAD9984.38 (V_DD), UAD9984.52 (V_DD), UAD9984.64 (V_DD); also elsewhere on the board
/DATACK: UAD9984.25 (DATACK); also elsewhere on the board
/FIELD: UAD9984.21 (O/E_Field); also elsewhere on the board
/HSOUT: UAD9984.23 (HSOUT); also elsewhere on the board
/RST: RPWD1.1, TPPWR1.1, UAD9984.17 (PWRDN); also elsewhere on the board
/SCL_AD99844: PAD_I2C0.2, R415.2, UAD9984.67 (SCL); also elsewhere on the board
/SDA_AD9984: PAD_I2C0.3, R416.2, UAD9984.66 (SDA); also elsewhere on the board
/SOGOUT: UAD9984.24 (SOGOUT); also elsewhere on the board
/TOFE-VGA/AD9984/B0: UAD9984.63 (Blue_0); also elsewhere on the board
/TOFE-VGA/AD9984/B1: UAD9984.62 (Blue_1); also elsewhere on the board
/TOFE-VGA/AD9984/B2: UAD9984.61 (Blue_2); also elsewhere on the board
/TOFE-VGA/AD9984/B3: UAD9984.60 (Blue_3); also elsewhere on the board
/TOFE-VGA/AD9984/B4: UAD9984.59 (Blue_4); also elsewhere on the board
/TOFE-VGA/AD9984/B5: UAD9984.58 (Blue_5); also elsewhere on the board
/TOFE-VGA/AD9984/B6: UAD9984.57 (Blue_6); also elsewhere on the board
/TOFE-VGA/AD9984/B7: UAD9984.56 (Blue_7); also elsewhere on the board
/TOFE-VGA/AD9984/B8: UAD9984.55 (Blue_8); also elsewhere on the board
/TOFE-VGA/AD9984/B9: UAD9984.54 (Blue_9); also elsewhere on the board
/TOFE-VGA/AD9984/CB: CCB1.2, LCB1.2, RCB1.1
/TOFE-VGA/AD9984/CLAMP: R411.1, TPCLAMP1.1, UAD9984.73 (CLAMP)
/TOFE-VGA/AD9984/COAST: R412.1, TPCOAST1.1, UAD9984.72 (EXTCK/COAST)
/TOFE-VGA/AD9984/COMP_Pb: LCB1.1; also elsewhere on the board
/TOFE-VGA/AD9984/COMP_Pr: LCR1.1; also elsewhere on the board
/TOFE-VGA/AD9984/COMP_Y: LCY1.1; also elsewhere on the board
/TOFE-VGA/AD9984/CR: CCR1.2, LCR1.2, RCR1.1
/TOFE-VGA/AD9984/CY: CCY1.2, CCY2.2, LCY1.2, RCY1.1
/TOFE-VGA/AD9984/FILT: C411.2, R410.1, UAD9984.78 (FILT)
/TOFE-VGA/AD9984/G0: UAD9984.51 (Green_0); also elsewhere on the board
/TOFE-VGA/AD9984/G1: UAD9984.50 (Green_1); also elsewhere on the board
/TOFE-VGA/AD9984/G2: UAD9984.49 (Green_2); also elsewhere on the board
/TOFE-VGA/AD9984/G3: UAD9984.48 (Green_3); also elsewhere on the board
/TOFE-VGA/AD9984/G4: UAD9984.47 (Green_4); also elsewhere on the board
/TOFE-VGA/AD9984/G5: UAD9984.46 (Green_5); also elsewhere on the board
/TOFE-VGA/AD9984/G6: UAD9984.45 (Green_6); also elsewhere on the board
/TOFE-VGA/AD9984/G7: UAD9984.44 (Green_7); also elsewhere on the board
/TOFE-VGA/AD9984/G8: UAD9984.43 (Green_8); also elsewhere on the board
/TOFE-VGA/AD9984/G9: UAD9984.42 (Green_9); also elsewhere on the board
/TOFE-VGA/AD9984/R0: UAD9984.37 (Red_0); also elsewhere on the board
/TOFE-VGA/AD9984/R1: UAD9984.36 (Red_1); also elsewhere on the board
/TOFE-VGA/AD9984/R2: UAD9984.35 (Red_2); also elsewhere on the board
/TOFE-VGA/AD9984/R3: UAD9984.34 (Red_3); also elsewhere on the board
/TOFE-VGA/AD9984/R4: UAD9984.33 (Red_4); also elsewhere on the board
/TOFE-VGA/AD9984/R5: UAD9984.32 (Red_5); also elsewhere on the board
/TOFE-VGA/AD9984/R6: UAD9984.31 (Red_6); also elsewhere on the board
/TOFE-VGA/AD9984/R7: UAD9984.30 (Red_7); also elsewhere on the board
/TOFE-VGA/AD9984/R8: UAD9984.29 (Red_8); also elsewhere on the board
/TOFE-VGA/AD9984/R9: UAD9984.28 (Red_9); also elsewhere on the board
/TOFE-VGA/AD9984/REFHI: CREF1.1, UAD9984.20 (REFHI)
/TOFE-VGA/AD9984/REFLO: CREF1.2, UAD9984.18 (REFLO)
/TOFE-VGA/AD9984/VB: CVB1.2, LVB1.2, RVB1.1
/TOFE-VGA/AD9984/VG: CVG1.2, CVG2.2, LVG1.2, RVG1.1
/TOFE-VGA/AD9984/VR: CVR2.2, LVR1.2, RVR1.1
/TOFE-VGA/VGA/VGAIN_B: LVB1.1; also elsewhere on the board
/TOFE-VGA/VGA/VGAIN_G: LVG1.1; also elsewhere on the board
/TOFE-VGA/VGA/VGAIN_HSYNC: UAD9984.70 (HSYNC0); also elsewhere on the board
/TOFE-VGA/VGA/VGAIN_R: LVR1.1; also elsewhere on the board
/TOFE-VGA/VGA/VGAIN_VSYNC: UAD9984.71 (VSYNC0); also elsewhere on the board
/VSOUT: RA1.1, RA2.2, UAD9984.22 (VSOUT\A0); also elsewhere on the board
GND: CGND1.1, PAD_I2C0.4, R411.2, R412.2, R413.1, R414.1, RA1.2, UAD9984.27 (GND), UAD9984.39 (GND), UAD9984.40 (GND), UAD9984.53 (GND), UAD9984.65 (GND), UAD9984.75 (GND), UAD9984.77 (GND), UAD9984.80 (GND); also elsewhere on the board
GNDA: CGND1.2, RCB1.2, RCR1.2, RCY1.2, RPWD1.2, RVB1.2, RVG1.2, RVR1.2, UAD9984.3 (GND), UAD9984.7 (GND), UAD9984.11 (GND), UAD9984.15 (GND); also elsewhere on the board
unnamed: C410.2, R410.2
unnamed: CCB1.1, UAD9984.4 (B_ANI1)
unnamed: CCR1.1, UAD9984.16 (R_AIN1)
unnamed: CCY1.1, UAD9984.10 (G_AIN1)
unnamed: CCY2.1, UAD9984.12 (SOGIN1)
unnamed: CVB1.1, UAD9984.2 (B_AIN0)
unnamed: CVG1.1, UAD9984.6 (G_AIN0)
unnamed: CVG2.1, UAD9984.8 (SOGIN0)
unnamed: CVR2.1, UAD9984.14 (R_AIN0)
unnamed: R413.2, UAD9984.69 (VSYNC1)
unnamed: R414.2, UAD9984.68 (HSYNC1)
PVD: C410.1, C411.1, UAD9984.74 (PV_D), UAD9984.76 (PV_D), UAD9984.79 (PV_D); also elsewhere on the board
VD: UAD9984.1 (V_D), UAD9984.5 (V_D), UAD9984.9 (V_D), UAD9984.13 (V_D), UAD9984.41 (DAV_DD); also elsewhere on the board

Notes on the sheet:
Analog supplies ---------------- 1V8 - PVD - Clock/PLL supply - Very noise sensitive 1V8 - VD - Main power supply - Noise sensitive Digital Supplies ---------------- 3V3 - VDD - Output power supply 1V8 - DAVDD - Digital supply ------------ VD and DAVDD are connected
Analog VGA Signals Noise sensitive!
P401 - AD9984 I2C Probe Point 1 - VCC 2 - SCL 3 - SDA 4 - GND
Load only one of R409 / R408
Route analog signals with matched impedance traces of 75 Ohm

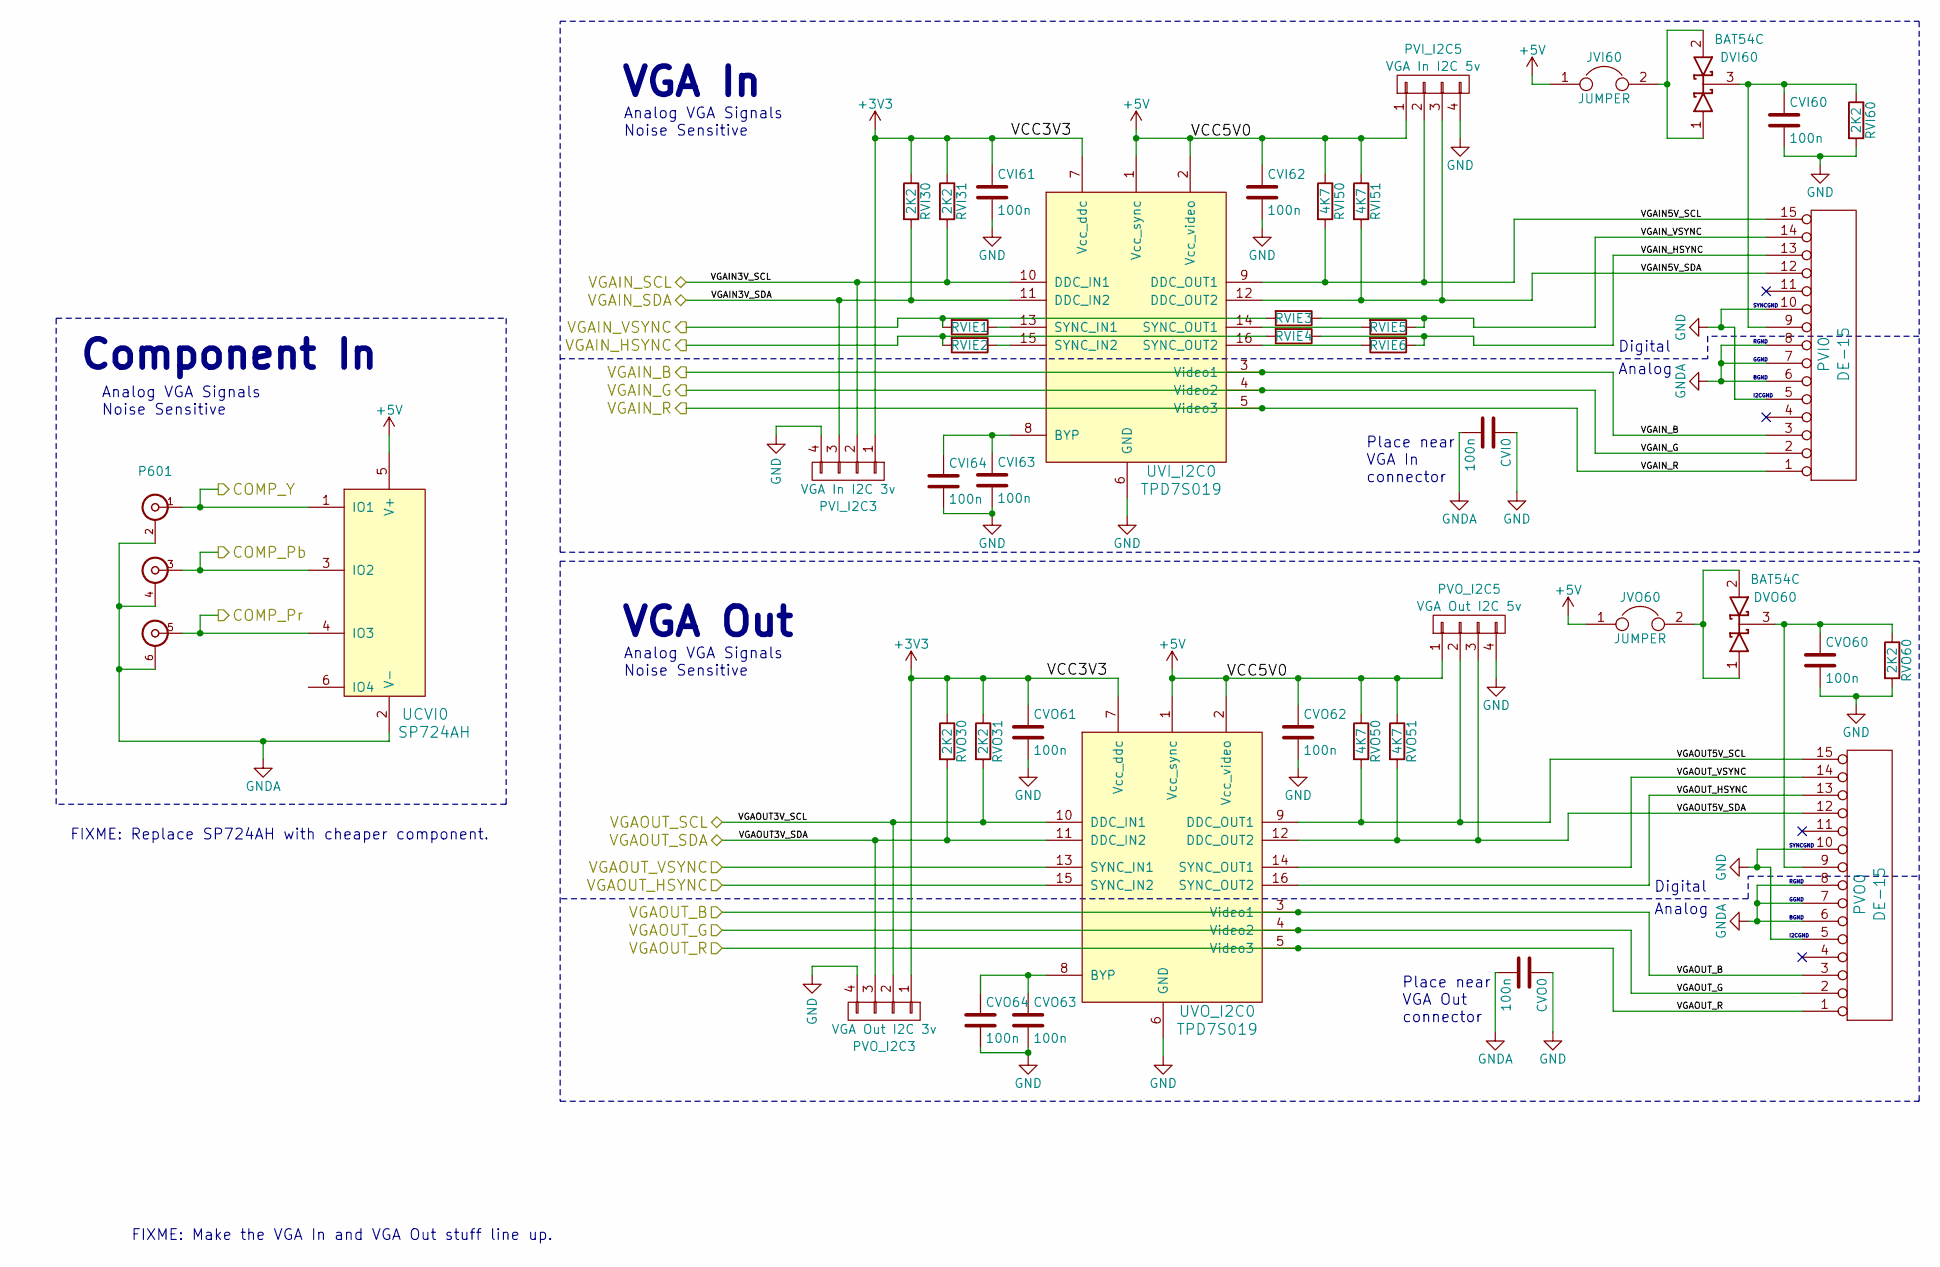
[picture p14: schematic vga.sch, TOFE VGA Expansion Board - VGA]

Parts:
CVI0, CVI60, CVI61, CVI62, CVI63, CVI64: 100n; C_0805_HandSoldering
CVO0, CVO60, CVO61, CVO62, CVO63, CVO64: 100n; C_0805_HandSoldering
DVI60: BAT54C; SOT-23
DVO60: BAT54C; SOT-23
JVI60: JUMPER; HARWIN-M20-87-2x1
JVO60: JUMPER; HARWIN-M20-87-2x1
P601: 3-RCA; MR-100H
PVI0: DE-15; TE-1-1734530-1
PVI_I2C3: VGA In I2C 3v; HARWIN-M20-87-4x1
PVI_I2C5: VGA In I2C 5v; HARWIN-M20-87-4x1
PVO0: DE-15; TE-1-1734530-1
PVO_I2C3: VGA Out I2C 3v; HARWIN-M20-87-4x1
PVO_I2C5: VGA Out I2C 5v; HARWIN-M20-87-4x1
RVI30, RVI31, RVI60: 2K2; R_0603_HandSoldering
RVI50, RVI51: 4K7; R_0603_HandSoldering
RVIE1, RVIE2, RVIE3, RVIE4, RVIE5, RVIE6: 0; R_0603_HandSoldering
RVO30, RVO31, RVO60: 2K2; R_0603_HandSoldering
RVO50, RVO51: 4K7; R_0603_HandSoldering
UCVI0: SP724AH; SOT-23-6
UVI_I2C0: TPD7S019; SSOP-16_3.9x4.9mm_Pitch0.635mm
UVO_I2C0: TPD7S019; SSOP-16_3.9x4.9mm_Pitch0.635mm

Connections:
+3V3: CVI61.1, CVO61.1, PVI_I2C3.1, PVO_I2C3.1, RVI30.1, RVI31.1, RVO30.1, RVO31.1, UVI_I2C0.7 (Vcc_ddc), UVO_I2C0.7 (Vcc_ddc); also elsewhere on the board
+5V: CVI62.1, CVO62.1, JVI60.1, JVO60.1, PVI_I2C5.1, PVO_I2C5.1, RVI50.1, RVI51.1, RVO50.1, RVO51.1, UCVI0.5 (V+), UVI_I2C0.1 (Vcc_sync), UVI_I2C0.2 (Vcc_video), UVO_I2C0.1 (Vcc_sync), UVO_I2C0.2 (Vcc_video); also elsewhere on the board
/TOFE-VGA/AD9984/COMP_Pb: P601.3 (In), UCVI0.3 (IO2); also elsewhere on the board
/TOFE-VGA/AD9984/COMP_Pr: P601.5 (In), UCVI0.4 (IO3); also elsewhere on the board
/TOFE-VGA/AD9984/COMP_Y: P601.1 (In), UCVI0.1 (IO1); also elsewhere on the board
/TOFE-VGA/VGA/VGAIN5V_SCL: PVI0.15, PVI_I2C5.2, RVI50.2, UVI_I2C0.9 (DDC_OUT1)
/TOFE-VGA/VGA/VGAIN5V_SDA: PVI0.12, PVI_I2C5.3, RVI51.2, UVI_I2C0.12 (DDC_OUT2)
/TOFE-VGA/VGA/VGAIN_B: PVI0.3, UVI_I2C0.3 (Video1); also elsewhere on the board
/TOFE-VGA/VGA/VGAIN_G: PVI0.2, UVI_I2C0.4 (Video2); also elsewhere on the board
/TOFE-VGA/VGA/VGAIN_HSYNC: PVI0.13, RVIE2.2, RVIE4.1, RVIE4.2, RVIE6.1; also elsewhere on the board
/TOFE-VGA/VGA/VGAIN_R: PVI0.1, UVI_I2C0.5 (Video3); also elsewhere on the board
/TOFE-VGA/VGA/VGAIN_VSYNC: PVI0.14, RVIE1.2, RVIE3.1, RVIE3.2, RVIE5.1; also elsewhere on the board
/TOFE-VGA/VGA/VGAOUT5V_SCL: PVO0.15, PVO_I2C5.2, RVO50.2, UVO_I2C0.9 (DDC_OUT1)
/TOFE-VGA/VGA/VGAOUT5V_SDA: PVO0.12, PVO_I2C5.3, RVO51.2, UVO_I2C0.12 (DDC_OUT2)
/TOFE-VGA/VGA/VGAOUT_B: PVO0.3, UVO_I2C0.3 (Video1); also elsewhere on the board
/TOFE-VGA/VGA/VGAOUT_G: PVO0.2, UVO_I2C0.4 (Video2); also elsewhere on the board
/TOFE-VGA/VGA/VGAOUT_HSYNC: PVO0.13, UVO_I2C0.15 (SYNC_IN2), UVO_I2C0.16 (SYNC_OUT2); also elsewhere on the board
/TOFE-VGA/VGA/VGAOUT_R: PVO0.1, UVO_I2C0.5 (Video3); also elsewhere on the board
/TOFE-VGA/VGA/VGAOUT_VSYNC: PVO0.14, UVO_I2C0.13 (SYNC_IN1), UVO_I2C0.14 (SYNC_OUT1); also elsewhere on the board
/VGAIN_SCL: PVI_I2C3.2, RVI31.2, UVI_I2C0.10 (DDC_IN1); also elsewhere on the board
/VGAIN_SDA: PVI_I2C3.3, RVI30.2, UVI_I2C0.11 (DDC_IN2); also elsewhere on the board
/VGAOUT_SCL: PVO_I2C3.2, RVO31.2, UVO_I2C0.10 (DDC_IN1); also elsewhere on the board
/VGAOUT_SDA: PVO_I2C3.3, RVO30.2, UVO_I2C0.11 (DDC_IN2); also elsewhere on the board
GND: CVI0.1, CVI60.2, CVI61.2, CVI62.2, CVI63.2, CVI64.2, CVO0.1, CVO60.2, CVO61.2, CVO62.2, CVO63.2, CVO64.2, PVI0.5, PVI0.10, PVI_I2C3.4, PVI_I2C5.4, PVO0.5, PVO0.10, PVO_I2C3.4, PVO_I2C5.4, RVI60.2, RVO60.2, UVI_I2C0.6 (GND), UVO_I2C0.6 (GND); also elsewhere on the board
GNDA: CVI0.2, CVO0.2, P601.2 (Ext), P601.4 (Ext), P601.6 (Ext), PVI0.6, PVI0.7, PVI0.8, PVO0.6, PVO0.7, PVO0.8, UCVI0.2 (V-); also elsewhere on the board
unnamed: CVI60.1, DVI60.3 (K), PVI0.9, RVI60.1
unnamed: CVI63.1, CVI64.1, UVI_I2C0.8 (BYP)
unnamed: CVO60.1, DVO60.3 (K), PVO0.9, RVO60.1
unnamed: CVO63.1, CVO64.1, UVO_I2C0.8 (BYP)
unnamed: DVI60.1 (A), DVI60.2 (A), JVI60.2
unnamed: DVO60.1 (A), DVO60.2 (A), JVO60.2
unnamed: RVIE1.1, UVI_I2C0.13 (SYNC_IN1)
unnamed: RVIE2.1, UVI_I2C0.15 (SYNC_IN2)
unnamed: RVIE5.2, UVI_I2C0.14 (SYNC_OUT1)
unnamed: RVIE6.2, UVI_I2C0.16 (SYNC_OUT2)

Notes on the sheet:
VGA Out
Analog VGA Signals Noise Sensitive
Place near VGA Out connector
Component In
VGA In
Place near VGA In connector
FIXME: Make the VGA In and VGA Out stuff line up.
FIXME: Replace SP724AH with cheaper component.
Digital
Analog
RGND
GGND
BGND
SYNCGND
I2CGND
