timvideos/HDMI2USB-TOFE-VGA/board/TOFE-VGA.kicad_pcb

## KiCad design board/TOFE-VGA.kicad_pcb (continued)

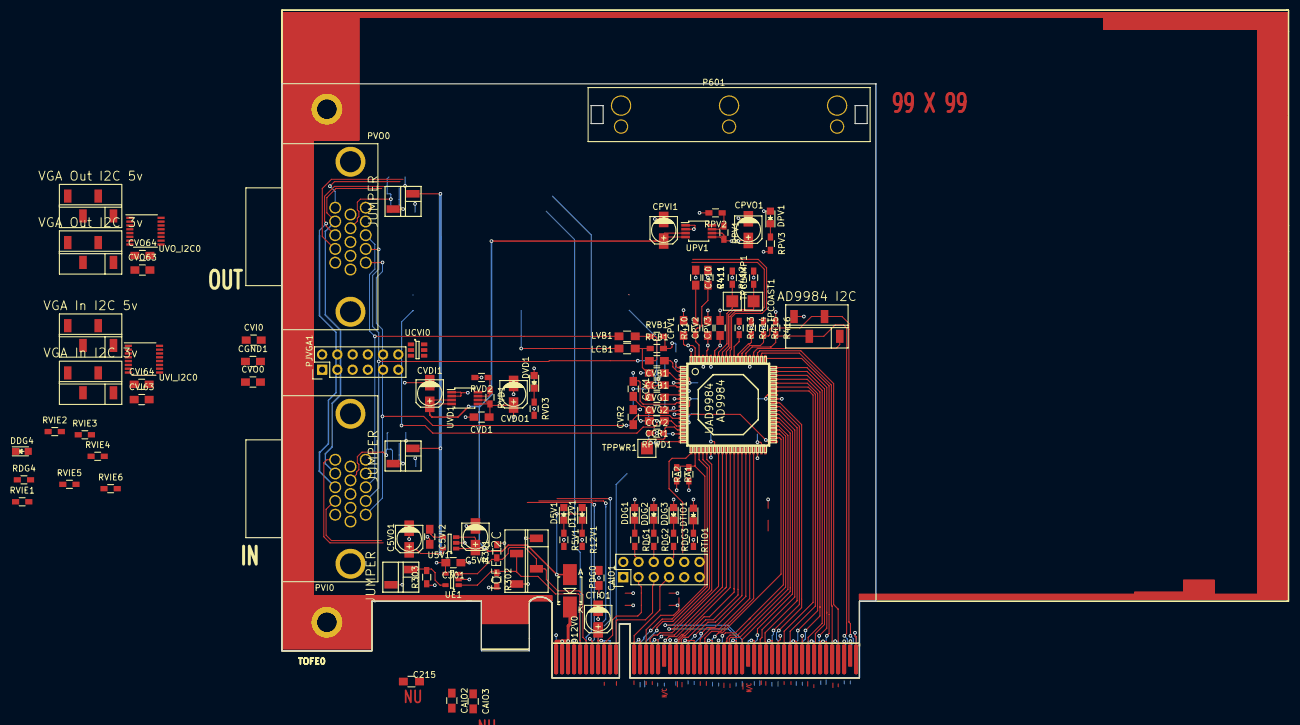
[picture p15: board TOFE-VGA.kicad_pcb from above]

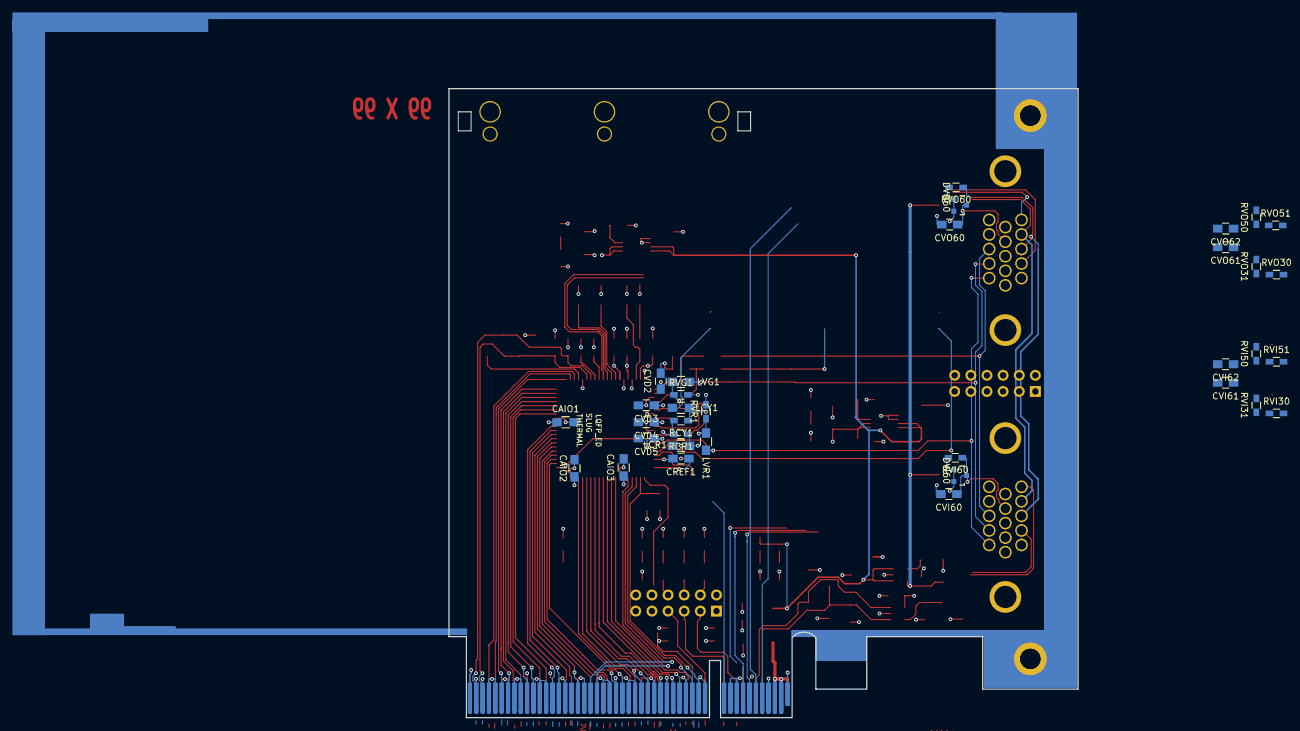
[picture p16: board TOFE-VGA.kicad_pcb from below]

Board: 4 copper layers, 141 parts (34 on the bottom side), 125 nets.

Other parts of the board:
C215: C5VI2; R_0805_HandSoldering
CAIO1#2, CAIO2#2, CAIO3#2: 100n; C_0805_HandSoldering
TOFE0#2: TOFE-8X; TOFE_8X_HalfHeight

Their connections:
+3V3: CAIO1#2.1, CAIO2#2.1, CAIO3#2.1, TOFE0#2.A9, TOFE0#2.A10, TOFE0#2.B8, TOFE0#2.B10; also elsewhere on the board
/TOFE-VGA/AD9984/B0: TOFE0#2.B46; also elsewhere on the board
/TOFE-VGA/AD9984/B1: TOFE0#2.B45; also elsewhere on the board
/TOFE-VGA/AD9984/B2: TOFE0#2.A44; also elsewhere on the board
/TOFE-VGA/AD9984/B3: TOFE0#2.A43; also elsewhere on the board
/TOFE-VGA/AD9984/B4: TOFE0#2.B42; also elsewhere on the board
/TOFE-VGA/AD9984/B5: TOFE0#2.B41; also elsewhere on the board
/TOFE-VGA/AD9984/B6: TOFE0#2.A40; also elsewhere on the board
/TOFE-VGA/AD9984/B7: TOFE0#2.A39; also elsewhere on the board
/TOFE-VGA/AD9984/B8: TOFE0#2.B38; also elsewhere on the board
/TOFE-VGA/AD9984/B9: TOFE0#2.B37; also elsewhere on the board
/TOFE-VGA/AD9984/G0: TOFE0#2.A36; also elsewhere on the board
/TOFE-VGA/AD9984/G1: TOFE0#2.A35; also elsewhere on the board
/TOFE-VGA/AD9984/G2: TOFE0#2.B34; also elsewhere on the board
/TOFE-VGA/AD9984/G3: TOFE0#2.B33; also elsewhere on the board
/TOFE-VGA/AD9984/G4: TOFE0#2.A32; also elsewhere on the board
/TOFE-VGA/AD9984/G5: TOFE0#2.B30; also elsewhere on the board
/TOFE-VGA/AD9984/G6: TOFE0#2.B28; also elsewhere on the board
/TOFE-VGA/AD9984/G7: TOFE0#2.B27; also elsewhere on the board
/TOFE-VGA/AD9984/G8: TOFE0#2.A26; also elsewhere on the board
/TOFE-VGA/AD9984/G9: TOFE0#2.A25; also elsewhere on the board
/TOFE-VGA/AD9984/R0: TOFE0#2.B24; also elsewhere on the board
/TOFE-VGA/AD9984/R1: TOFE0#2.B23; also elsewhere on the board
/TOFE-VGA/AD9984/R2: TOFE0#2.A22; also elsewhere on the board
/TOFE-VGA/AD9984/R3: TOFE0#2.A21; also elsewhere on the board
/TOFE-VGA/AD9984/R4: TOFE0#2.B20; also elsewhere on the board
/TOFE-VGA/AD9984/R5: TOFE0#2.B19; also elsewhere on the board
/TOFE-VGA/AD9984/R6: TOFE0#2.A19; also elsewhere on the board
/TOFE-VGA/AD9984/R7: TOFE0#2.A17; also elsewhere on the board
/TOFE-VGA/AD9984/R8: TOFE0#2.A16; also elsewhere on the board
/TOFE-VGA/AD9984/R9: TOFE0#2.B15; also elsewhere on the board
/TOFE-VGA/TOFE/IDCLK: TOFE0#2.B5; also elsewhere on the board
/TOFE-VGA/TOFE/IDDAT: TOFE0#2.B6; also elsewhere on the board
/TOFE-VGA/TOFE/RAW_VCC12V: TOFE0#2.A2, TOFE0#2.A3, TOFE0#2.B1, TOFE0#2.B2, TOFE0#2.B3; also elsewhere on the board
GND: C215.2, CAIO1#2.2, CAIO2#2.2, CAIO3#2.2, TOFE0#2.A4, TOFE0#2.A12, TOFE0#2.A15, TOFE0#2.A18, TOFE0#2.A20, TOFE0#2.A23, TOFE0#2.A24, TOFE0#2.A27, TOFE0#2.A28, TOFE0#2.A31, TOFE0#2.A34, TOFE0#2.A37, TOFE0#2.A38, TOFE0#2.A41, TOFE0#2.A42, TOFE0#2.A45, TOFE0#2.A46, TOFE0#2.A49, TOFE0#2.B4, TOFE0#2.B7, TOFE0#2.B13, TOFE0#2.B16, TOFE0#2.B18, TOFE0#2.B21, TOFE0#2.B22, TOFE0#2.B25, TOFE0#2.B26, TOFE0#2.B29, TOFE0#2.B32, TOFE0#2.B35, TOFE0#2.B36, TOFE0#2.B39, TOFE0#2.B40, TOFE0#2.B43, TOFE0#2.B44, TOFE0#2.B47, TOFE0#2.B49; also elsewhere on the board
unnamed 124: TOFE0#2.B12; also elsewhere on the board
unnamed 139: TOFE0#2.A33; also elsewhere on the board
unnamed 140: TOFE0#2.B17; also elsewhere on the board
unnamed 141: TOFE0#2.B31; also elsewhere on the board
PRNST: TOFE0#2.A1, TOFE0#2.B48; also elsewhere on the board
