timvideos/HDMI2USB-TOFE-VGA/GSoC_Designs/vgaExp.kicad_pcb

## KiCad design GSoC_Designs/vgaExp.kicad_pcb (2014-06-02)

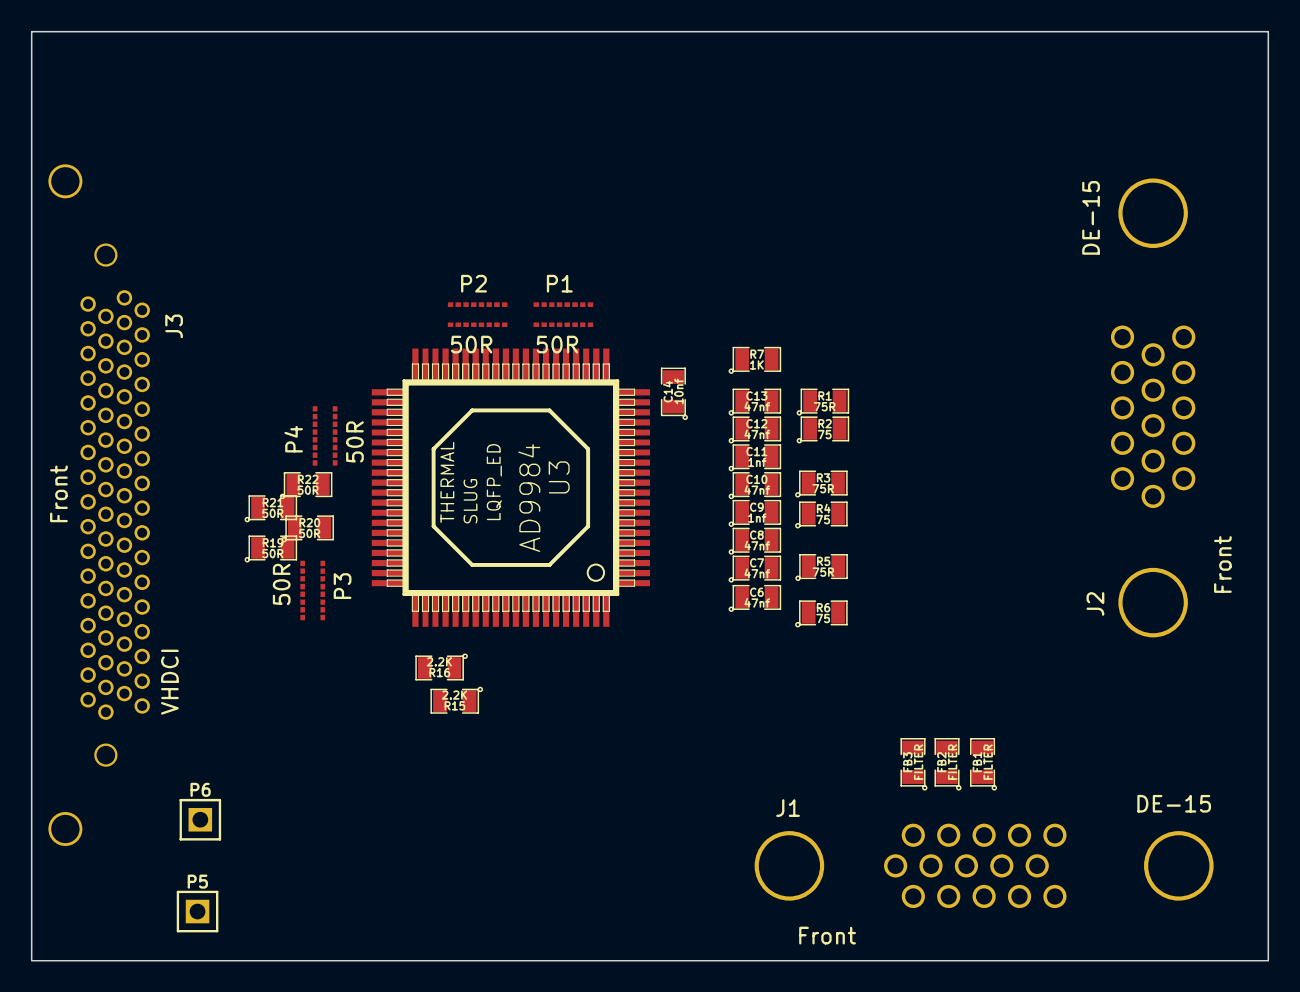
[picture p17: board vgaExp.kicad_pcb from above]

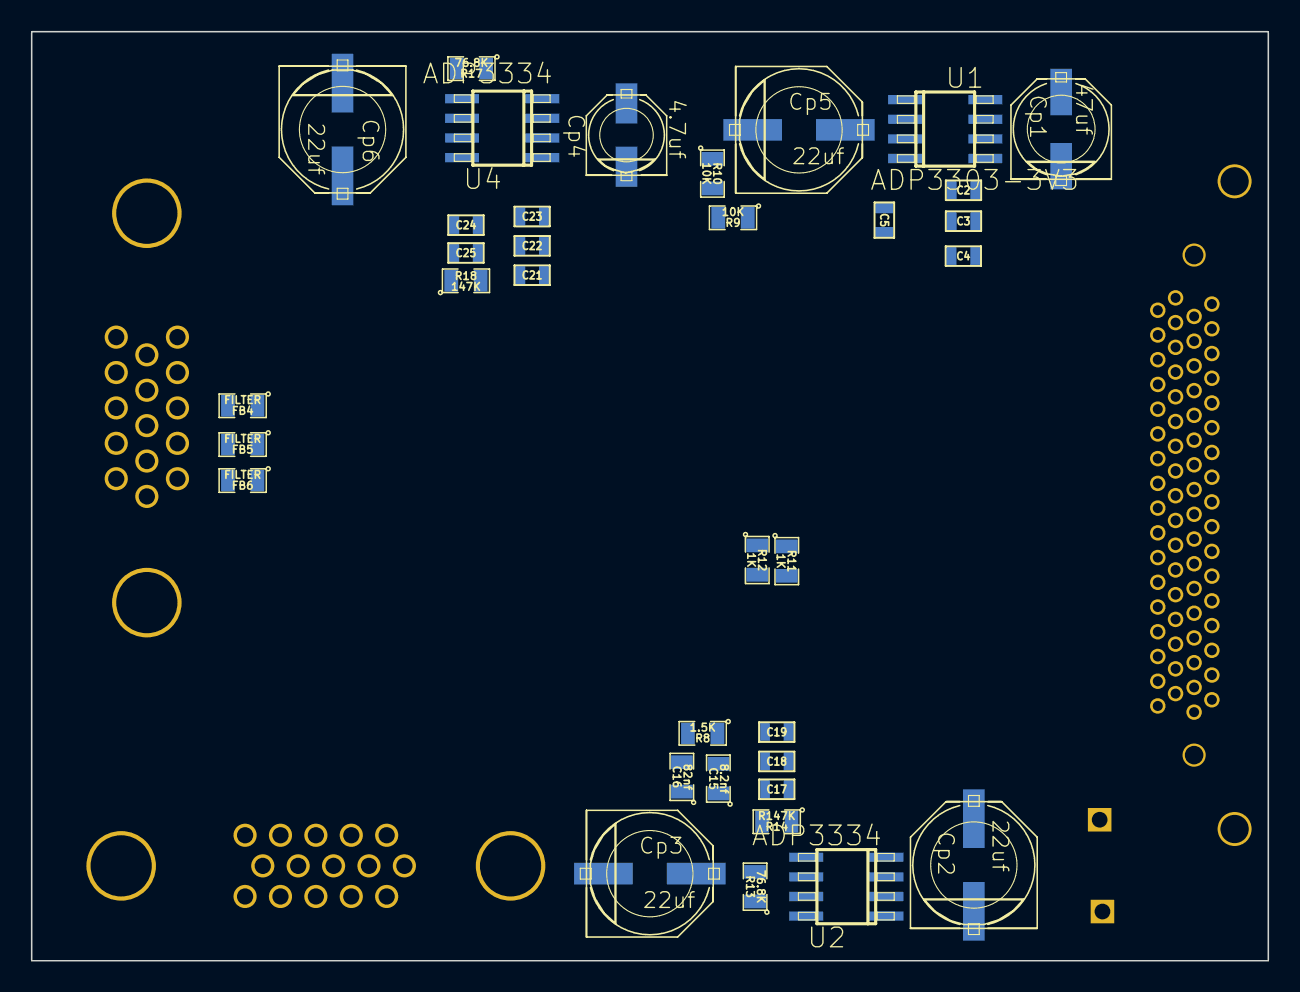
[picture p18: board vgaExp.kicad_pcb from below]

Board: 2 copper layers, 80.0 x 60.1 mm, 70 parts (35 on the bottom side), 115 nets, no tracks yet.

Parts:
C2, C3, C4, C5, C17, C18, C19, C21, C22, C23, C24, C25: 0.1uf; SM0603
C6, C7, C8, C10, C12, C13: 47nf; SM0805
C9, C11: 1nf; SM0805
C14: 10nf; SM0805
C15: 8.2nf; SM0805
C16: 82nf; SM0805
Cp1: 47uf; -PANASONIC_D
Cp2, Cp3, Cp5, Cp6: 22uf; -PANASONIC_E
Cp4: 4.7uf; -PANASONIC_C
FB1, FB2, FB3, FB4, FB5, FB6: FILTER; SM0805
J1, J2: DE-15
J3: VHDCI
P1, P2, P3, P4: 50R; R50x8
P5, P6: CONN_1; PIN_ARRAY_1
R1, R3, R5: 75R; SM0805
R2, R4, R6: 75; SM0805
R7, R11, R12: 1K; SM0805
R8: 1.5K; SM0805
R9, R10: 10K; SM0805
R13, R17: 76.8K; SM0805
R14: R147K; SM0805
R15, R16: 2.2K; SM0805
R18: 147K; SM0805
R19, R20, R21, R22: 50R; SM0805
U1: ADP3303-3V3; -SOIC8
U2, U4: ADP3334; -SOIC8
U3: AD9984; AD9984A_MediumPads

Connections:
/B0: J3.32, P3.8
/B1: J3.31, P3.7
/B2: J3.63, P3.6
/B3: J3.62, P3.5
/B4: J3.29, P3.4
/B5: J3.28, P3.3
/B6: J3.59, P3.2
/B7: J3.60, P3.1
/B8: J3.26, R19.2
/B9: J3.25, R20.2
/CLAMP: J3.65, R12.2, U3.73
/COST: J3.66, R11.2, U3.72
/DATACK: J3.49, P1.13
/G0: J3.57, R21.2
/G1: J3.56, R22.2
/G2: J3.23, P4.16
/G3: J3.22, P4.15
/G4: J3.54, P4.14
/G5: J3.47, P4.13
/G6: J3.46, P4.12
/G7: J3.43, P4.11
/G8: J3.41, P4.10
/G9: J3.40, P4.9
/GND: J1.4, J1.5, J1.6, J1.7, J1.8, J1.9, J2.4, J2.5, J2.6, J2.7, J2.8, J2.9, J3.2, J3.5, J3.8, J3.11, J3.14, J3.21, J3.24, J3.27, J3.30, J3.33, R11.1, R12.1, U3.3, U3.7, U3.11, U3.15, U3.75, U3.77, U3.80
/HSOUT: J3.3, P1.11
/OE_Field: J3.35, P1.9
/OVDD: R15.2, R16.2
/PVD: C15.1, C16.1, U3.74, U3.76, U3.79
/PWRDWN: J3.37, R7.2, U3.17
/PowerSupply/GND: C2.2, C3.2, C4.2, C5.2, C17.2, C18.2, C19.2, C21.2, C22.2, C23.2, C24.2, C25.2, R14.1, R18.1, U1.4, U2.1, U2.2, U4.1, U4.2
/PowerSupply/OVDD: C2.1, C3.1, C4.1, C5.1, U1.1, U1.2
/PowerSupply/PVD: C17.1, C18.1, C19.1, R13.1, U2.5, U2.6
/PowerSupply/VCC: U1.5, U1.7, U1.8, U2.3, U2.4, U4.3, U4.4
/PowerSupply/VD: C21.1, C22.1, C23.1, C24.1, C25.1, R17.1, U4.5, U4.6
/R0: J3.20, P2.15
/R1: J3.15, P2.14
/R2: J3.13, P2.13
/R3: J3.12, P2.12
/R4: J3.44, P2.11
/R5: J3.10, P2.10
/R6: J3.9, P2.9
/R7: J3.7, P1.16
/R8: J3.6, P1.15
/R9: J3.38, P1.14
/SOGOUT: J3.4, P1.12
/VCC: J3.17, J3.18, J3.51, J3.52
/VD: U3.1, U3.5, U3.9, U3.13, U3.41
/VSOUT: J3.1, P1.10, R9.2, R10.2
unnamed: C16.2, R8.2
unnamed: P3.10, U3.62
unnamed: P3.11, U3.61
unnamed: P3.9, U3.63
unnamed: R15.1, U3.67
unnamed: R16.1, U3.66
unnamed: P1.8, U3.21
unnamed: P1.5, U3.24
unnamed: P1.6, U3.23
unnamed: P1.7, U3.22
unnamed: P2.3, U3.36
unnamed: P2.2, U3.37
unnamed: P2.4, U3.35
unnamed: P2.5, U3.34
unnamed: P2.6, U3.33
unnamed: P2.7, U3.32
unnamed: P2.8, U3.31
unnamed: P1.1, U3.30
unnamed: P1.2, U3.29
unnamed: P1.3, U3.28
unnamed: P1.4, U3.25
unnamed: FB4.1, J2.3
unnamed: C13.1, FB1.2, R1.2
unnamed: C7.1, FB3.2, R5.2
unnamed: C10.1, C11.1, FB2.2, R3.2
unnamed: C14.2, U3.20
unnamed: C14.1, U3.18
unnamed: C6.1, FB6.2, R6.1
unnamed: C8.1, C9.1, FB5.2, R4.1
unnamed: C12.1, FB4.2, R2.1
unnamed: J3.36, J3.39, J3.42, J3.45, J3.48, J3.55, J3.58, J3.61, J3.64, J3.67
unnamed: FB5.1, J2.2
unnamed: FB1.1, J1.3
unnamed: FB2.1, J1.2
unnamed: FB3.1, J1.1
unnamed: FB6.1, J2.1
unnamed: C6.2, U3.2
unnamed: U3.39, U3.40
unnamed: R2.2, R4.2, R6.2
unnamed: R1.1, R3.1, R5.1
unnamed: C7.2, U3.4
unnamed: C8.2, U3.6
unnamed: C9.2, U3.8
unnamed: C10.2, U3.10
unnamed: C11.2, U3.12
unnamed: C12.2, U3.14
unnamed: C13.2, U3.16
unnamed: P4.8, U3.42
unnamed: P4.7, U3.43
unnamed: P4.6, U3.44
unnamed: R20.1, U3.54
unnamed: R22.1, U3.50
unnamed: P3.12, U3.60
unnamed: R21.1, U3.51
unnamed: P3.13, U3.59
unnamed: P4.2, U3.48
unnamed: P3.14, U3.58
unnamed: P4.1, U3.49
unnamed: P4.4, U3.46
unnamed: P4.5, U3.45
unnamed: R19.1, U3.55
unnamed: P3.16, U3.56
unnamed: P4.3, U3.47
unnamed: P3.15, U3.57
unnamed: C15.2, R8.1, U3.78
unnamed: R17.2, R18.2, U4.7
unnamed: R13.2, R14.2, U2.7
