timvideos/HDMI2USB-TOFE-VGA/examples/hdmi-output-implementation/hdl/i2c/picoblaze/ad9984a_init.vhd

--
-------------------------------------------------------------------------------------------
-- Copyright © 2010-2013, Xilinx, Inc.
-- This file contains confidential and proprietary information of Xilinx, Inc. and is
-- protected under U.S. and international copyright and other intellectual property laws.
-------------------------------------------------------------------------------------------
--
-- Disclaimer:
-- This disclaimer is not a license and does not grant any rights to the materials
-- distributed herewith. Except as otherwise provided in a valid license issued to
-- you by Xilinx, and to the maximum extent permitted by applicable law: (1) THESE
-- MATERIALS ARE MADE AVAILABLE "AS IS" AND WITH ALL FAULTS, AND XILINX HEREBY
-- DISCLAIMS ALL WARRANTIES AND CONDITIONS, EXPRESS, IMPLIED, OR STATUTORY,
-- INCLUDING BUT NOT LIMITED TO WARRANTIES OF MERCHANTABILITY, NON-INFRINGEMENT,
-- OR FITNESS FOR ANY PARTICULAR PURPOSE; and (2) Xilinx shall not be liable
-- (whether in contract or tort, including negligence, or under any other theory
-- of liability) for any loss or damage of any kind or nature related to, arising
-- under or in connection with these materials, including for any direct, or any
-- indirect, special, incidental, or consequential loss or damage (including loss
-- of data, profits, goodwill, or any type of loss or damage suffered as a result
-- of any action brought by a third party) even if such damage or loss was
-- reasonably foreseeable or Xilinx had been advised of the possibility of the same.
--
-- CRITICAL APPLICATIONS
-- Xilinx products are not designed or intended to be fail-safe, or for use in any
-- application requiring fail-safe performance, such as life-support or safety
-- devices or systems, Class III medical devices, nuclear facilities, applications
-- related to the deployment of airbags, or any other applications that could lead
-- to death, personal injury, or severe property or environmental damage
-- (individually and collectively, "Critical Applications"). Customer assumes the
-- sole risk and liability of any use of Xilinx products in Critical Applications,
-- subject only to applicable laws and regulations governing limitations on product
-- liability.
--
-- THIS COPYRIGHT NOTICE AND DISCLAIMER MUST BE RETAINED AS PART OF THIS FILE AT ALL TIMES.
--
-------------------------------------------------------------------------------------------
--
--
-- Definition of a program memory for KCPSM6 including generic parameters for the 
-- convenient selection of device family, program memory size and the ability to include 
-- the JTAG Loader hardware for rapid software development.
--
-- This file is primarily for use during code development and it is recommended that the 
-- appropriate simplified program memory definition be used in a final production design. 
--
--    Generic                  Values             Comments
--    Parameter                Supported
--  
--    C_FAMILY                 "S6"               Spartan-6 device
--                             "V6"               Virtex-6 device
--                             "7S"               7-Series device 
--                                                  (Artix-7, Kintex-7, Virtex-7 or Zynq)
--
--    C_RAM_SIZE_KWORDS        1, 2 or 4          Size of program memory in K-instructions
--
--    C_JTAG_LOADER_ENABLE     0 or 1             Set to '1' to include JTAG Loader
--
-- Notes
--
-- If your design contains MULTIPLE KCPSM6 instances then only one should have the 
-- JTAG Loader enabled at a time (i.e. make sure that C_JTAG_LOADER_ENABLE is only set to 
-- '1' on one instance of the program memory). Advanced users may be interested to know 
-- that it is possible to connect JTAG Loader to multiple memories and then to use the 
-- JTAG Loader utility to specify which memory contents are to be modified. However, 
-- this scheme does require some effort to set up and the additional connectivity of the 
-- multiple BRAMs can impact the placement, routing and performance of the complete 
-- design. Please contact the author at Xilinx for more detailed information. 
--
-- Regardless of the size of program memory specified by C_RAM_SIZE_KWORDS, the complete 
-- 12-bit address bus is connected to KCPSM6. This enables the generic to be modified 
-- without requiring changes to the fundamental hardware definition. However, when the 
-- program memory is 1K then only the lower 10-bits of the address are actually used and 
-- the valid address range is 000 to 3FF hex. Likewise, for a 2K program only the lower 
-- 11-bits of the address are actually used and the valid address range is 000 to 7FF hex.
--
-- Programs are stored in Block Memory (BRAM) and the number of BRAM used depends on the 
-- size of the program and the device family. 
--
-- In a Spartan-6 device a BRAM is capable of holding 1K instructions. Hence a 2K program 
-- will require 2 BRAMs to be used and a 4K program will require 4 BRAMs to be used. It 
-- should be noted that a 4K program is not such a natural fit in a Spartan-6 device and 
-- the implementation also requires a small amount of logic resulting in slightly lower 
-- performance. A Spartan-6 BRAM can also be split into two 9k-bit memories suggesting 
-- that a program containing up to 512 instructions could be implemented. However, there 
-- is a silicon errata which makes this unsuitable and therefore it is not supported by 
-- this file.
--
-- In a Virtex-6 or any 7-Series device a BRAM is capable of holding 2K instructions so 
-- obviously a 2K program requires only a single BRAM. Each BRAM can also be divided into 
-- 2 smaller memories supporting programs of 1K in half of a 36k-bit BRAM (generally 
-- reported as being an 18k-bit BRAM). For a program of 4K instructions, 2 BRAMs are used.
--
--
-- Program defined by 'E:\HDMI_FIFO_Testv03\hdl\i2c\picoblaze\ad9984a_init.psm'.
--
-- Generated by KCPSM6 Assembler: 05 Aug 2014 - 18:50:23. 
--
-- Assembler used ROM_form template: ROM_form_JTAGLoader_14March13.vhd
--
-- Standard IEEE libraries
--
--
package jtag_loader_pkg is
 function addr_width_calc (size_in_k: integer) return integer;
end jtag_loader_pkg;
--
package body jtag_loader_pkg is
  function addr_width_calc (size_in_k: integer) return integer is
   begin
    if (size_in_k = 1) then return 10;
      elsif (size_in_k = 2) then return 11;
      elsif (size_in_k = 4) then return 12;
      else report "Invalid BlockRAM size. Please set to 1, 2 or 4 K words." severity FAILURE;
    end if;
    return 0;
  end function addr_width_calc;
end package body;
--
library IEEE;
use IEEE.STD_LOGIC_1164.ALL;
use IEEE.STD_LOGIC_UNSIGNED.ALL;
use work.jtag_loader_pkg.ALL;
--
-- The Unisim Library is used to define Xilinx primitives. It is also used during
-- simulation. The source can be viewed at %XILINX%\vhdl\src\unisims\unisim_VCOMP.vhd
--  
library unisim;
use unisim.vcomponents.all;
--
--
entity ad9984a_init is
  generic(             C_FAMILY : string := "S6"; 
              C_RAM_SIZE_KWORDS : integer := 1;
           C_JTAG_LOADER_ENABLE : integer := 0);
  Port (      address : in std_logic_vector(11 downto 0);
          instruction : out std_logic_vector(17 downto 0);
               enable : in std_logic;
                  rdl : out std_logic;                    
                  clk : in std_logic);
  end ad9984a_init;
--
architecture low_level_definition of ad9984a_init is
--
signal       address_a : std_logic_vector(15 downto 0);
signal        pipe_a11 : std_logic;
signal       data_in_a : std_logic_vector(35 downto 0);
signal      data_out_a : std_logic_vector(35 downto 0);
signal    data_out_a_l : std_logic_vector(35 downto 0);
signal    data_out_a_h : std_logic_vector(35 downto 0);
signal   data_out_a_ll : std_logic_vector(35 downto 0);
signal   data_out_a_lh : std_logic_vector(35 downto 0);
signal   data_out_a_hl : std_logic_vector(35 downto 0);
signal   data_out_a_hh : std_logic_vector(35 downto 0);
signal       address_b : std_logic_vector(15 downto 0);
signal       data_in_b : std_logic_vector(35 downto 0);
signal     data_in_b_l : std_logic_vector(35 downto 0);
signal    data_in_b_ll : std_logic_vector(35 downto 0);
signal    data_in_b_hl : std_logic_vector(35 downto 0);
signal      data_out_b : std_logic_vector(35 downto 0);
signal    data_out_b_l : std_logic_vector(35 downto 0);
signal   data_out_b_ll : std_logic_vector(35 downto 0);
signal   data_out_b_hl : std_logic_vector(35 downto 0);
signal     data_in_b_h : std_logic_vector(35 downto 0);
signal    data_in_b_lh : std_logic_vector(35 downto 0);
signal    data_in_b_hh : std_logic_vector(35 downto 0);
signal    data_out_b_h : std_logic_vector(35 downto 0);
signal   data_out_b_lh : std_logic_vector(35 downto 0);
signal   data_out_b_hh : std_logic_vector(35 downto 0);
signal        enable_b : std_logic;
signal           clk_b : std_logic;
signal            we_b : std_logic_vector(7 downto 0);
signal          we_b_l : std_logic_vector(3 downto 0);
signal          we_b_h : std_logic_vector(3 downto 0);
-- 
signal       jtag_addr : std_logic_vector(11 downto 0);
signal         jtag_we : std_logic;
signal       jtag_we_l : std_logic;
signal       jtag_we_h : std_logic;
signal        jtag_clk : std_logic;
signal        jtag_din : std_logic_vector(17 downto 0);
signal       jtag_dout : std_logic_vector(17 downto 0);
signal     jtag_dout_1 : std_logic_vector(17 downto 0);
signal         jtag_en : std_logic_vector(0 downto 0);
-- 
signal picoblaze_reset : std_logic_vector(0 downto 0);
signal         rdl_bus : std_logic_vector(0 downto 0);
--
constant BRAM_ADDRESS_WIDTH  : integer := addr_width_calc(C_RAM_SIZE_KWORDS);
--
--
component jtag_loader_6
generic(                C_JTAG_LOADER_ENABLE : integer := 1;
                                    C_FAMILY : string  := "V6";
                             C_NUM_PICOBLAZE : integer := 1;
                       C_BRAM_MAX_ADDR_WIDTH : integer := 10;
          C_PICOBLAZE_INSTRUCTION_DATA_WIDTH : integer := 18;
                                C_JTAG_CHAIN : integer := 2;
                              C_ADDR_WIDTH_0 : integer := 10;
                              C_ADDR_WIDTH_1 : integer := 10;
                              C_ADDR_WIDTH_2 : integer := 10;
                              C_ADDR_WIDTH_3 : integer := 10;
                              C_ADDR_WIDTH_4 : integer := 10;
                              C_ADDR_WIDTH_5 : integer := 10;
                              C_ADDR_WIDTH_6 : integer := 10;
                              C_ADDR_WIDTH_7 : integer := 10);
port(              picoblaze_reset : out std_logic_vector(C_NUM_PICOBLAZE-1 downto 0);
                           jtag_en : out std_logic_vector(C_NUM_PICOBLAZE-1 downto 0);
                          jtag_din : out STD_LOGIC_VECTOR(C_PICOBLAZE_INSTRUCTION_DATA_WIDTH-1 downto 0);
                         jtag_addr : out STD_LOGIC_VECTOR(C_BRAM_MAX_ADDR_WIDTH-1 downto 0);
                          jtag_clk : out std_logic;
                           jtag_we : out std_logic;
                       jtag_dout_0 : in STD_LOGIC_VECTOR(C_PICOBLAZE_INSTRUCTION_DATA_WIDTH-1 downto 0);
                       jtag_dout_1 : in STD_LOGIC_VECTOR(C_PICOBLAZE_INSTRUCTION_DATA_WIDTH-1 downto 0);
                       jtag_dout_2 : in STD_LOGIC_VECTOR(C_PICOBLAZE_INSTRUCTION_DATA_WIDTH-1 downto 0);
                       jtag_dout_3 : in STD_LOGIC_VECTOR(C_PICOBLAZE_INSTRUCTION_DATA_WIDTH-1 downto 0);
                       jtag_dout_4 : in STD_LOGIC_VECTOR(C_PICOBLAZE_INSTRUCTION_DATA_WIDTH-1 downto 0);
                       jtag_dout_5 : in STD_LOGIC_VECTOR(C_PICOBLAZE_INSTRUCTION_DATA_WIDTH-1 downto 0);
                       jtag_dout_6 : in STD_LOGIC_VECTOR(C_PICOBLAZE_INSTRUCTION_DATA_WIDTH-1 downto 0);
                       jtag_dout_7 : in STD_LOGIC_VECTOR(C_PICOBLAZE_INSTRUCTION_DATA_WIDTH-1 downto 0));
end component;
--
begin
  --
  --  
  ram_1k_generate : if (C_RAM_SIZE_KWORDS = 1) generate
 
    s6: if (C_FAMILY = "S6") generate 
      --
      address_a(13 downto 0) <= address(9 downto 0) & "0000";
      instruction <= data_out_a(33 downto 32) & data_out_a(15 downto 0);
      data_in_a <= "0000000000000000000000000000000000" & address(11 downto 10);
      jtag_dout <= data_out_b(33 downto 32) & data_out_b(15 downto 0);
      --
      no_loader : if (C_JTAG_LOADER_ENABLE = 0) generate
        data_in_b <= "00" & data_out_b(33 downto 32) & "0000000000000000" & data_out_b(15 downto 0);
        address_b(13 downto 0) <= "00000000000000";
        we_b(3 downto 0) <= "0000";
        enable_b <= '0';
        rdl <= '0';
        clk_b <= '0';
      end generate no_loader;
      --
      loader : if (C_JTAG_LOADER_ENABLE = 1) generate
        data_in_b <= "00" & jtag_din(17 downto 16) & "0000000000000000" & jtag_din(15 downto 0);
        address_b(13 downto 0) <= jtag_addr(9 downto 0) & "0000";
        we_b(3 downto 0) <= jtag_we & jtag_we & jtag_we & jtag_we;
        enable_b <= jtag_en(0);
        rdl <= rdl_bus(0);
        clk_b <= jtag_clk;
      end generate loader;
      --
      kcpsm6_rom: RAMB16BWER
      generic map ( DATA_WIDTH_A => 18,
                    DOA_REG => 0,
                    EN_RSTRAM_A => FALSE,
                    INIT_A => X"000000000",
                    RST_PRIORITY_A => "CE",
                    SRVAL_A => X"000000000",
                    WRITE_MODE_A => "WRITE_FIRST",
                    DATA_WIDTH_B => 18,
                    DOB_REG => 0,
                    EN_RSTRAM_B => FALSE,
                    INIT_B => X"000000000",
                    RST_PRIORITY_B => "CE",
                    SRVAL_B => X"000000000",
                    WRITE_MODE_B => "WRITE_FIRST",
                    RSTTYPE => "SYNC",
                    INIT_FILE => "NONE",
                    SIM_COLLISION_CHECK => "ALL",
                    SIM_DEVICE => "SPARTAN6",
                    INIT_00 => X"1605006A17071620006A1794161F006A17B4161E20050006184C009E00900090",
                    INIT_01 => X"1700160A006A17401609006A17001608006A17401607006A17001606006A1740",
                    INIT_02 => X"006A17FF160F006A17FF160E006A17FF160D006A17FF160C006A17FF160B006A",
                    INIT_03 => X"1628006A17E0162E006A17E8162D006A170E163C006A171B161B006A17FF1610",
                    INIT_04 => X"17801604006A17A01603006A17001602006A17541601006A17021629006A17BF",
                    INIT_05 => X"006A17061615006A171C1614006A178C161A006A17011619006A17881613006A",
                    INIT_06 => X"056000C600AF4506058000A25000006A177D161D006A17061617006A17031616",
                    INIT_07 => X"0090006A175516001839006A17AA16001838500000A900C600AF057000C600AF",
                    INIT_08 => X"2098101011271200500000900090006A17AA16001839006A1755160018380090",
                    INIT_09 => X"5F021F0150006098B200B10090010000209810801196129820981040110D1203",
                    INIT_0A => X"1180500000D600E400CD00E300D3500000C900E400D300E300CD00D65000DF08",
                    INIT_0B => X"00E300D3500060BA910100D9110820B09000410E00BF00D620B500D360B4C510",
                    INIT_0C => X"9002DF085F01500000E3DF083FFE5000D50100D920BF00D6500000C900E400CD",
                    INIT_0D => X"4500D002900200E600CD00E300D65000DF085F025000DF083FFD500020CFD001",
                    INIT_0E => X"000000000000500060EA90011018500000E900E900E900E900E9500000C900E6",
                    INIT_0F => X"0000000000000000000000000000000000000000000000000000000000000000",
                    INIT_10 => X"0000000000000000000000000000000000000000000000000000000000000000",
                    INIT_11 => X"0000000000000000000000000000000000000000000000000000000000000000",
                    INIT_12 => X"0000000000000000000000000000000000000000000000000000000000000000",
                    INIT_13 => X"0000000000000000000000000000000000000000000000000000000000000000",
                    INIT_14 => X"0000000000000000000000000000000000000000000000000000000000000000",
                    INIT_15 => X"0000000000000000000000000000000000000000000000000000000000000000",
                    INIT_16 => X"0000000000000000000000000000000000000000000000000000000000000000",
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
                   INITP_02 => X"0000000000000000000000000000000000000000000000000000000000000000",
                   INITP_03 => X"0000000000000000000000000000000000000000000000000000000000000000",
                   INITP_04 => X"0000000000000000000000000000000000000000000000000000000000000000",
                   INITP_05 => X"0000000000000000000000000000000000000000000000000000000000000000",
                   INITP_06 => X"0000000000000000000000000000000000000000000000000000000000000000",
                   INITP_07 => X"0000000000000000000000000000000000000000000000000000000000000000")
      port map(  ADDRA => address_a(13 downto 0),
                   ENA => enable,
                  CLKA => clk,
                   DOA => data_out_a(31 downto 0),
                  DOPA => data_out_a(35 downto 32), 
                   DIA => data_in_a(31 downto 0),
                  DIPA => data_in_a(35 downto 32), 
                   WEA => "0000",
                REGCEA => '0',
                  RSTA => '0',
                 ADDRB => address_b(13 downto 0),
                   ENB => enable_b,
                  CLKB => clk_b,
                   DOB => data_out_b(31 downto 0),
                  DOPB => data_out_b(35 downto 32), 
                   DIB => data_in_b(31 downto 0),
                  DIPB => data_in_b(35 downto 32), 
                   WEB => we_b(3 downto 0),
                REGCEB => '0',
                  RSTB => '0');
    --               
    end generate s6;
    --
    --
    v6 : if (C_FAMILY = "V6") generate
      --
      address_a(13 downto 0) <= address(9 downto 0) & "1111";
      instruction <= data_out_a(17 downto 0);
      data_in_a(17 downto 0) <= "0000000000000000" & address(11 downto 10);
      jtag_dout <= data_out_b(17 downto 0);
      --
      no_loader : if (C_JTAG_LOADER_ENABLE = 0) generate
        data_in_b(17 downto 0) <= data_out_b(17 downto 0);
        address_b(13 downto 0) <= "11111111111111";
        we_b(3 downto 0) <= "0000";
        enable_b <= '0';
        rdl <= '0';
        clk_b <= '0';
      end generate no_loader;
      --
      loader : if (C_JTAG_LOADER_ENABLE = 1) generate
        data_in_b(17 downto 0) <= jtag_din(17 downto 0);
        address_b(13 downto 0) <= jtag_addr(9 downto 0) & "1111";
        we_b(3 downto 0) <= jtag_we & jtag_we & jtag_we & jtag_we;
        enable_b <= jtag_en(0);
        rdl <= rdl_bus(0);
        clk_b <= jtag_clk;
      end generate loader;
      -- 
      kcpsm6_rom: RAMB18E1
      generic map ( READ_WIDTH_A => 18,
                    WRITE_WIDTH_A => 18,
                    DOA_REG => 0,
                    INIT_A => "000000000000000000",
                    RSTREG_PRIORITY_A => "REGCE",
                    SRVAL_A => X"000000000000000000",
                    WRITE_MODE_A => "WRITE_FIRST",
                    READ_WIDTH_B => 18,
                    WRITE_WIDTH_B => 18,
                    DOB_REG => 0,
                    INIT_B => X"000000000000000000",
                    RSTREG_PRIORITY_B => "REGCE",
                    SRVAL_B => X"000000000000000000",
                    WRITE_MODE_B => "WRITE_FIRST",
                    INIT_FILE => "NONE",
                    SIM_COLLISION_CHECK => "ALL",
                    RAM_MODE => "TDP",
                    RDADDR_COLLISION_HWCONFIG => "DELAYED_WRITE",
                    SIM_DEVICE => "VIRTEX6",
                    INIT_00 => X"1605006A17071620006A1794161F006A17B4161E20050006184C009E00900090",
                    INIT_01 => X"1700160A006A17401609006A17001608006A17401607006A17001606006A1740",
                    INIT_02 => X"006A17FF160F006A17FF160E006A17FF160D006A17FF160C006A17FF160B006A",
                    INIT_03 => X"1628006A17E0162E006A17E8162D006A170E163C006A171B161B006A17FF1610",
                    INIT_04 => X"17801604006A17A01603006A17001602006A17541601006A17021629006A17BF",
                    INIT_05 => X"006A17061615006A171C1614006A178C161A006A17011619006A17881613006A",
                    INIT_06 => X"056000C600AF4506058000A25000006A177D161D006A17061617006A17031616",
                    INIT_07 => X"0090006A175516001839006A17AA16001838500000A900C600AF057000C600AF",
                    INIT_08 => X"2098101011271200500000900090006A17AA16001839006A1755160018380090",
                    INIT_09 => X"5F021F0150006098B200B10090010000209810801196129820981040110D1203",
                    INIT_0A => X"1180500000D600E400CD00E300D3500000C900E400D300E300CD00D65000DF08",
                    INIT_0B => X"00E300D3500060BA910100D9110820B09000410E00BF00D620B500D360B4C510",
                    INIT_0C => X"9002DF085F01500000E3DF083FFE5000D50100D920BF00D6500000C900E400CD",
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
                    CLKARDCLK => clk,
                        DOADO => data_out_a(15 downto 0),
                      DOPADOP => data_out_a(17 downto 16), 
                        DIADI => data_in_a(15 downto 0),
                      DIPADIP => data_in_a(17 downto 16), 
                          WEA => "00",
                  REGCEAREGCE => '0',
                RSTRAMARSTRAM => '0',
                RSTREGARSTREG => '0',
                  ADDRBWRADDR => address_b(13 downto 0),
                      ENBWREN => enable_b,
                    CLKBWRCLK => clk_b,
                        DOBDO => data_out_b(15 downto 0),
                      DOPBDOP => data_out_b(17 downto 16), 
                        DIBDI => data_in_b(15 downto 0),
                      DIPBDIP => data_in_b(17 downto 16), 
                        WEBWE => we_b(3 downto 0),
                       REGCEB => '0',
                      RSTRAMB => '0',
                      RSTREGB => '0');
      --
    end generate akv7;
    --
  end generate ram_1k_generate;
  --
  --
  --
  ram_2k_generate : if (C_RAM_SIZE_KWORDS = 2) generate
    --
    --
    s6: if (C_FAMILY = "S6") generate
      --
      address_a(13 downto 0) <= address(10 downto 0) & "000";
      instruction <= data_out_a_h(32) & data_out_a_h(7 downto 0) & data_out_a_l(32) & data_out_a_l(7 downto 0);
      data_in_a <= "00000000000000000000000000000000000" & address(11);
      jtag_dout <= data_out_b_h(32) & data_out_b_h(7 downto 0) & data_out_b_l(32) & data_out_b_l(7 downto 0);
      --
      no_loader : if (C_JTAG_LOADER_ENABLE = 0) generate
        data_in_b_l <= "000" & data_out_b_l(32) & "000000000000000000000000" & data_out_b_l(7 downto 0);
        data_in_b_h <= "000" & data_out_b_h(32) & "000000000000000000000000" & data_out_b_h(7 downto 0);
        address_b(13 downto 0) <= "00000000000000";
        we_b(3 downto 0) <= "0000";
        enable_b <= '0';
        rdl <= '0';
        clk_b <= '0';
      end generate no_loader;
      --
      loader : if (C_JTAG_LOADER_ENABLE = 1) generate
        data_in_b_h <= "000" & jtag_din(17) & "000000000000000000000000" & jtag_din(16 downto 9);
        data_in_b_l <= "000" & jtag_din(8) & "000000000000000000000000" & jtag_din(7 downto 0);
        address_b(13 downto 0) <= jtag_addr(10 downto 0) & "000";
        we_b(3 downto 0) <= jtag_we & jtag_we & jtag_we & jtag_we;
        enable_b <= jtag_en(0);
        rdl <= rdl_bus(0);
        clk_b <= jtag_clk;
      end generate loader;
      --
      kcpsm6_rom_l: RAMB16BWER
      generic map ( DATA_WIDTH_A => 9,
                    DOA_REG => 0,
                    EN_RSTRAM_A => FALSE,
                    INIT_A => X"000000000",
                    RST_PRIORITY_A => "CE",
                    SRVAL_A => X"000000000",
                    WRITE_MODE_A => "WRITE_FIRST",
                    DATA_WIDTH_B => 9,
                    DOB_REG => 0,
                    EN_RSTRAM_B => FALSE,
                    INIT_B => X"000000000",
                    RST_PRIORITY_B => "CE",
                    SRVAL_B => X"000000000",
                    WRITE_MODE_B => "WRITE_FIRST",
                    RSTTYPE => "SYNC",
                    INIT_FILE => "NONE",
                    SIM_COLLISION_CHECK => "ALL",
                    SIM_DEVICE => "SPARTAN6",
                    INIT_00 => X"000A6A40096A00086A40076A00066A40056A07206A941F6AB41E05064C9E9090",
                    INIT_01 => X"286AE02E6AE82D6A0E3C6A1B1B6AFF106AFF0F6AFF0E6AFF0D6AFF0C6AFF0B6A",
                    INIT_02 => X"6A06156A1C146A8C1A6A01196A88136A80046AA0036A00026A54016A02296ABF",
                    INIT_03 => X"906A5500396AAA003800A9C6AF70C6AF60C6AF0680A2006A7D1D6A06176A0316",
                    INIT_04 => X"02010098000001009880969898400D03981027000090906AAA00396A55003890",
                    INIT_05 => X"E3D300BA01D908B0000EBFD6B5D3B4108000D6E4CDE3D300C9E4D3E3CDD60008",
                    INIT_06 => X"000202E6CDE3D60008020008FD00CF0102080100E308FE0001D9BFD600C9E4CD",
                    INIT_07 => X"0000000000000000000000000000000000000000EA011800E9E9E9E9E900C9E6",
                    INIT_08 => X"0000000000000000000000000000000000000000000000000000000000000000",
                    INIT_09 => X"0000000000000000000000000000000000000000000000000000000000000000",
                    INIT_0A => X"0000000000000000000000000000000000000000000000000000000000000000",
                    INIT_0B => X"0000000000000000000000000000000000000000000000000000000000000000",
                    INIT_0C => X"0000000000000000000000000000000000000000000000000000000000000000",
                    INIT_0D => X"0000000000000000000000000000000000000000000000000000000000000000",
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
                   INITP_07 => X"0000000000000000000000000000000000000000000000000000000000000000",
                   INITP_08 => X"0000000000000000000000000000000000000000000000000000000000000000",
                   INITP_09 => X"0000000000000000000000000000000000000000000000000000000000000000",
                   INITP_0A => X"0000000000000000000000000000000000000000000000000000000000000000",
                   INITP_0B => X"0000000000000000000000000000000000000000000000000000000000000000",
                   INITP_0C => X"0000000000000000000000000000000000000000000000000000000000000000",
                   INITP_0D => X"0000000000000000000000000000000000000000000000000000000000000000",
                   INITP_0E => X"0000000000000000000000000000000000000000000000000000000000000000",
                   INITP_0F => X"0000000000000000000000000000000000000000000000000000000000000000")
      port map(   ADDRARDADDR => address_a,
                      ENARDEN => enable,
                    CLKARDCLK => clk,
                        DOADO => data_out_a(31 downto 0),
                      DOPADOP => data_out_a(35 downto 32), 
                        DIADI => data_in_a(31 downto 0),
                      DIPADIP => data_in_a(35 downto 32), 
                          WEA => "0000",
                  REGCEAREGCE => '0',
                RSTRAMARSTRAM => '0',
                RSTREGARSTREG => '0',
                  ADDRBWRADDR => address_b,
                      ENBWREN => enable_b,
                    CLKBWRCLK => clk_b,
                        DOBDO => data_out_b(31 downto 0),
                      DOPBDOP => data_out_b(35 downto 32), 
                        DIBDI => data_in_b(31 downto 0),
                      DIPBDIP => data_in_b(35 downto 32), 
                        WEBWE => we_b,
                       REGCEB => '0',
                      RSTRAMB => '0',
                      RSTREGB => '0',
                   CASCADEINA => '0',
                   CASCADEINB => '0',
                INJECTDBITERR => '0',
                INJECTSBITERR => '0');
      --
    end generate v6;
    --
    --
    akv7 : if (C_FAMILY = "7S") generate
      --
      address_a <= '1' & address(10 downto 0) & "1111";
      instruction <= data_out_a(33 downto 32) & data_out_a(15 downto 0);
      data_in_a <= "00000000000000000000000000000000000" & address(11);
      jtag_dout <= data_out_b(33 downto 32) & data_out_b(15 downto 0);
      --
      no_loader : if (C_JTAG_LOADER_ENABLE = 0) generate
        data_in_b <= "00" & data_out_b(33 downto 32) & "0000000000000000" & data_out_b(15 downto 0);
        address_b <= "1111111111111111";
        we_b <= "00000000";
        enable_b <= '0';
        rdl <= '0';
        clk_b <= '0';
      end generate no_loader;
      --
      loader : if (C_JTAG_LOADER_ENABLE = 1) generate
        data_in_b <= "00" & jtag_din(17 downto 16) & "0000000000000000" & jtag_din(15 downto 0);
        address_b <= '1' & jtag_addr(10 downto 0) & "1111";
        we_b <= jtag_we & jtag_we & jtag_we & jtag_we & jtag_we & jtag_we & jtag_we & jtag_we;
        enable_b <= jtag_en(0);
        rdl <= rdl_bus(0);
        clk_b <= jtag_clk;
      end generate loader;
      --
      kcpsm6_rom: RAMB36E1
      generic map ( READ_WIDTH_A => 18,
                    WRITE_WIDTH_A => 18,
                    DOA_REG => 0,
                    INIT_A => X"000000000",
                    RSTREG_PRIORITY_A => "REGCE",
                    SRVAL_A => X"000000000",
                    WRITE_MODE_A => "WRITE_FIRST",
                    READ_WIDTH_B => 18,
                    WRITE_WIDTH_B => 18,
                    DOB_REG => 0,
                    INIT_B => X"000000000",
                    RSTREG_PRIORITY_B => "REGCE",
                    SRVAL_B => X"000000000",
                    WRITE_MODE_B => "WRITE_FIRST",
                    INIT_FILE => "NONE",
                    SIM_COLLISION_CHECK => "ALL",
                    RAM_MODE => "TDP",
                    RDADDR_COLLISION_HWCONFIG => "DELAYED_WRITE",
                    EN_ECC_READ => FALSE,
                    EN_ECC_WRITE => FALSE,
                    RAM_EXTENSION_A => "NONE",
                    RAM_EXTENSION_B => "NONE",
                    SIM_DEVICE => "7SERIES",
                    INIT_00 => X"1605006A17071620006A1794161F006A17B4161E20050006184C009E00900090",
                    INIT_01 => X"1700160A006A17401609006A17001608006A17401607006A17001606006A1740",
                    INIT_02 => X"006A17FF160F006A17FF160E006A17FF160D006A17FF160C006A17FF160B006A",
                    INIT_03 => X"1628006A17E0162E006A17E8162D006A170E163C006A171B161B006A17FF1610",
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
                   INITP_09 => X"0000000000000000000000000000000000000000000000000000000000000000",
                   INITP_0A => X"0000000000000000000000000000000000000000000000000000000000000000",
                   INITP_0B => X"0000000000000000000000000000000000000000000000000000000000000000",
                   INITP_0C => X"0000000000000000000000000000000000000000000000000000000000000000",
                   INITP_0D => X"0000000000000000000000000000000000000000000000000000000000000000",
                   INITP_0E => X"0000000000000000000000000000000000000000000000000000000000000000",
                   INITP_0F => X"0000000000000000000000000000000000000000000000000000000000000000")
      port map(   ADDRARDADDR => address_a,
                      ENARDEN => enable,
                    CLKARDCLK => clk,
                        DOADO => data_out_a(31 downto 0),
                      DOPADOP => data_out_a(35 downto 32), 
                        DIADI => data_in_a(31 downto 0),
                      DIPADIP => data_in_a(35 downto 32), 
                          WEA => "0000",
                  REGCEAREGCE => '0',
                RSTRAMARSTRAM => '0',
                RSTREGARSTREG => '0',
                  ADDRBWRADDR => address_b,
                      ENBWREN => enable_b,
                    CLKBWRCLK => clk_b,
                        DOBDO => data_out_b(31 downto 0),
                      DOPBDOP => data_out_b(35 downto 32), 
                        DIBDI => data_in_b(31 downto 0),
                      DIPBDIP => data_in_b(35 downto 32), 
                        WEBWE => we_b,
                       REGCEB => '0',
                      RSTRAMB => '0',
                      RSTREGB => '0',
                   CASCADEINA => '0',
                   CASCADEINB => '0',
                INJECTDBITERR => '0',
                INJECTSBITERR => '0');
      --
    end generate akv7;
    --
  end generate ram_2k_generate;
  --
  --	
  ram_4k_generate : if (C_RAM_SIZE_KWORDS = 4) generate
    s6: if (C_FAMILY = "S6") generate
      --
      address_a(13 downto 0) <= address(10 downto 0) & "000";
      data_in_a <= "000000000000000000000000000000000000";
      --
      s6_a11_flop: FD
      port map (  D => address(11),
                  Q => pipe_a11,
                  C => clk);
      --
      s6_4k_mux0_lut: LUT6_2
      generic map (INIT => X"FF00F0F0CCCCAAAA")
      port map( I0 => data_out_a_ll(0),
                I1 => data_out_a_hl(0),
                I2 => data_out_a_ll(1),
                I3 => data_out_a_hl(1),
                I4 => pipe_a11,
                I5 => '1',
                O5 => instruction(0),
                O6 => instruction(1));
      --
      s6_4k_mux2_lut: LUT6_2
      generic map (INIT => X"FF00F0F0CCCCAAAA")
      port map( I0 => data_out_a_ll(2),
                I1 => data_out_a_hl(2),
                I2 => data_out_a_ll(3),
                I3 => data_out_a_hl(3),
                I4 => pipe_a11,
                I5 => '1',
                O5 => instruction(2),
                O6 => instruction(3));
      --
      s6_4k_mux4_lut: LUT6_2
      generic map (INIT => X"FF00F0F0CCCCAAAA")
      port map( I0 => data_out_a_ll(4),
                I1 => data_out_a_hl(4),
                I2 => data_out_a_ll(5),
                I3 => data_out_a_hl(5),
                I4 => pipe_a11,
                I5 => '1',
                O5 => instruction(4),
                O6 => instruction(5));
      --
      s6_4k_mux6_lut: LUT6_2
      generic map (INIT => X"FF00F0F0CCCCAAAA")
      port map( I0 => data_out_a_ll(6),
                I1 => data_out_a_hl(6),
                I2 => data_out_a_ll(7),
                I3 => data_out_a_hl(7),
                I4 => pipe_a11,
                I5 => '1',
                O5 => instruction(6),
                O6 => instruction(7));
      --
      s6_4k_mux8_lut: LUT6_2
      generic map (INIT => X"FF00F0F0CCCCAAAA")
      port map( I0 => data_out_a_ll(32),
                I1 => data_out_a_hl(32),
                I2 => data_out_a_lh(0),
                I3 => data_out_a_hh(0),
                I4 => pipe_a11,
                I5 => '1',
                O5 => instruction(8),
                O6 => instruction(9));
      --
      s6_4k_mux10_lut: LUT6_2
      generic map (INIT => X"FF00F0F0CCCCAAAA")
      port map( I0 => data_out_a_lh(1),
                I1 => data_out_a_hh(1),
                I2 => data_out_a_lh(2),
                I3 => data_out_a_hh(2),
                I4 => pipe_a11,
                I5 => '1',
                O5 => instruction(10),
                O6 => instruction(11));
      --
      s6_4k_mux12_lut: LUT6_2
      generic map (INIT => X"FF00F0F0CCCCAAAA")
      port map( I0 => data_out_a_lh(3),
                I1 => data_out_a_hh(3),
                I2 => data_out_a_lh(4),
                I3 => data_out_a_hh(4),
                I4 => pipe_a11,
                I5 => '1',
                O5 => instruction(12),
                O6 => instruction(13));
      --
      s6_4k_mux14_lut: LUT6_2
      generic map (INIT => X"FF00F0F0CCCCAAAA")
      port map( I0 => data_out_a_lh(5),
                I1 => data_out_a_hh(5),
                I2 => data_out_a_lh(6),
                I3 => data_out_a_hh(6),
                I4 => pipe_a11,
                I5 => '1',
                O5 => instruction(14),
                O6 => instruction(15));
      --
      s6_4k_mux16_lut: LUT6_2
      generic map (INIT => X"FF00F0F0CCCCAAAA")
      port map( I0 => data_out_a_lh(7),
                I1 => data_out_a_hh(7),
                I2 => data_out_a_lh(32),
                I3 => data_out_a_hh(32),
                I4 => pipe_a11,
                I5 => '1',
                O5 => instruction(16),
                O6 => instruction(17));
      --
      no_loader : if (C_JTAG_LOADER_ENABLE = 0) generate
        data_in_b_ll <= "000" & data_out_b_ll(32) & "000000000000000000000000" & data_out_b_ll(7 downto 0);
        data_in_b_lh <= "000" & data_out_b_lh(32) & "000000000000000000000000" & data_out_b_lh(7 downto 0);
        data_in_b_hl <= "000" & data_out_b_hl(32) & "000000000000000000000000" & data_out_b_hl(7 downto 0);
        data_in_b_hh <= "000" & data_out_b_hh(32) & "000000000000000000000000" & data_out_b_hh(7 downto 0);
        address_b(13 downto 0) <= "00000000000000";
        we_b_l(3 downto 0) <= "0000";
        we_b_h(3 downto 0) <= "0000";
        enable_b <= '0';
        rdl <= '0';
        clk_b <= '0';
        jtag_dout <= data_out_b_lh(32) & data_out_b_lh(7 downto 0) & data_out_b_ll(32) & data_out_b_ll(7 downto 0);
      end generate no_loader;
      --
      loader : if (C_JTAG_LOADER_ENABLE = 1) generate
        data_in_b_lh <= "000" & jtag_din(17) & "000000000000000000000000" & jtag_din(16 downto 9);
        data_in_b_ll <= "000" & jtag_din(8) & "000000000000000000000000" & jtag_din(7 downto 0);
        data_in_b_hh <= "000" & jtag_din(17) & "000000000000000000000000" & jtag_din(16 downto 9);
        data_in_b_hl <= "000" & jtag_din(8) & "000000000000000000000000" & jtag_din(7 downto 0);
        address_b(13 downto 0) <= jtag_addr(10 downto 0) & "000";
        --
        s6_4k_jtag_we_lut: LUT6_2
        generic map (INIT => X"8000000020000000")
        port map( I0 => jtag_we,
                  I1 => jtag_addr(11),
                  I2 => '1',
                  I3 => '1',
                  I4 => '1',
                  I5 => '1',
                  O5 => jtag_we_l,
                  O6 => jtag_we_h);
        --
        we_b_l(3 downto 0) <= jtag_we_l & jtag_we_l & jtag_we_l & jtag_we_l;
        we_b_h(3 downto 0) <= jtag_we_h & jtag_we_h & jtag_we_h & jtag_we_h;
        --
        enable_b <= jtag_en(0);
        rdl <= rdl_bus(0);
        clk_b <= jtag_clk;
        --
        s6_4k_jtag_mux0_lut: LUT6_2
        generic map (INIT => X"FF00F0F0CCCCAAAA")
        port map( I0 => data_out_b_ll(0),
                  I1 => data_out_b_hl(0),
                  I2 => data_out_b_ll(1),
                  I3 => data_out_b_hl(1),
                  I4 => jtag_addr(11),
                  I5 => '1',
                  O5 => jtag_dout(0),
                  O6 => jtag_dout(1));
        --
        s6_4k_jtag_mux2_lut: LUT6_2
        generic map (INIT => X"FF00F0F0CCCCAAAA")
        port map( I0 => data_out_b_ll(2),
                  I1 => data_out_b_hl(2),
                  I2 => data_out_b_ll(3),
                  I3 => data_out_b_hl(3),
                  I4 => jtag_addr(11),
                  I5 => '1',
                  O5 => jtag_dout(2),
                  O6 => jtag_dout(3));
        --
        s6_4k_jtag_mux4_lut: LUT6_2
        generic map (INIT => X"FF00F0F0CCCCAAAA")
        port map( I0 => data_out_b_ll(4),
                  I1 => data_out_b_hl(4),
                  I2 => data_out_b_ll(5),
                  I3 => data_out_b_hl(5),
                  I4 => jtag_addr(11),
                  I5 => '1',
                  O5 => jtag_dout(4),
                  O6 => jtag_dout(5));
        --
        s6_4k_jtag_mux6_lut: LUT6_2
        generic map (INIT => X"FF00F0F0CCCCAAAA")
        port map( I0 => data_out_b_ll(6),
                  I1 => data_out_b_hl(6),
                  I2 => data_out_b_ll(7),
                  I3 => data_out_b_hl(7),
                  I4 => jtag_addr(11),
                  I5 => '1',
                  O5 => jtag_dout(6),
                  O6 => jtag_dout(7));
        --
        s6_4k_jtag_mux8_lut: LUT6_2
        generic map (INIT => X"FF00F0F0CCCCAAAA")
        port map( I0 => data_out_b_ll(32),
                  I1 => data_out_b_hl(32),
                  I2 => data_out_b_lh(0),
                  I3 => data_out_b_hh(0),
                  I4 => jtag_addr(11),
                  I5 => '1',
                  O5 => jtag_dout(8),
                  O6 => jtag_dout(9));
        --
        s6_4k_jtag_mux10_lut: LUT6_2
        generic map (INIT => X"FF00F0F0CCCCAAAA")
        port map( I0 => data_out_b_lh(1),
                  I1 => data_out_b_hh(1),
                  I2 => data_out_b_lh(2),
                  I3 => data_out_b_hh(2),
                  I4 => jtag_addr(11),
                  I5 => '1',
                  O5 => jtag_dout(10),
                  O6 => jtag_dout(11));
        --
        s6_4k_jtag_mux12_lut: LUT6_2
        generic map (INIT => X"FF00F0F0CCCCAAAA")
        port map( I0 => data_out_b_lh(3),
                  I1 => data_out_b_hh(3),
                  I2 => data_out_b_lh(4),
                  I3 => data_out_b_hh(4),
                  I4 => jtag_addr(11),
                  I5 => '1',
                  O5 => jtag_dout(12),
                  O6 => jtag_dout(13));
        --
        s6_4k_jtag_mux14_lut: LUT6_2
        generic map (INIT => X"FF00F0F0CCCCAAAA")
        port map( I0 => data_out_b_lh(5),
                  I1 => data_out_b_hh(5),
                  I2 => data_out_b_lh(6),
                  I3 => data_out_b_hh(6),
                  I4 => jtag_addr(11),
                  I5 => '1',
                  O5 => jtag_dout(14),
                  O6 => jtag_dout(15));
        --
        s6_4k_jtag_mux16_lut: LUT6_2
        generic map (INIT => X"FF00F0F0CCCCAAAA")
        port map( I0 => data_out_b_lh(7),
                  I1 => data_out_b_hh(7),
                  I2 => data_out_b_lh(32),
                  I3 => data_out_b_hh(32),
                  I4 => jtag_addr(11),
                  I5 => '1',
                  O5 => jtag_dout(16),
                  O6 => jtag_dout(17));
      --
      end generate loader;
      --
      kcpsm6_rom_ll: RAMB16BWER
      generic map ( DATA_WIDTH_A => 9,
                    DOA_REG => 0,
                    EN_RSTRAM_A => FALSE,
                    INIT_A => X"000000000",
                    RST_PRIORITY_A => "CE",
                    SRVAL_A => X"000000000",
                    WRITE_MODE_A => "WRITE_FIRST",
                    DATA_WIDTH_B => 9,
                    DOB_REG => 0,
                    EN_RSTRAM_B => FALSE,
                    INIT_B => X"000000000",
                    RST_PRIORITY_B => "CE",
                    SRVAL_B => X"000000000",
                    WRITE_MODE_B => "WRITE_FIRST",
                    RSTTYPE => "SYNC",
                    INIT_FILE => "NONE",
                    SIM_COLLISION_CHECK => "ALL",
                    SIM_DEVICE => "SPARTAN6",
                    INIT_00 => X"000A6A40096A00086A40076A00066A40056A07206A941F6AB41E05064C9E9090",
                    INIT_01 => X"286AE02E6AE82D6A0E3C6A1B1B6AFF106AFF0F6AFF0E6AFF0D6AFF0C6AFF0B6A",
                    INIT_02 => X"6A06156A1C146A8C1A6A01196A88136A80046AA0036A00026A54016A02296ABF",
                    INIT_03 => X"906A5500396AAA003800A9C6AF70C6AF60C6AF0680A2006A7D1D6A06176A0316",
                    INIT_04 => X"02010098000001009880969898400D03981027000090906AAA00396A55003890",
                    INIT_05 => X"E3D300BA01D908B0000EBFD6B5D3B4108000D6E4CDE3D300C9E4D3E3CDD60008",
                    INIT_06 => X"000202E6CDE3D60008020008FD00CF0102080100E308FE0001D9BFD600C9E4CD",
                    INIT_07 => X"0000000000000000000000000000000000000000EA011800E9E9E9E9E900C9E6",
                    INIT_08 => X"0000000000000000000000000000000000000000000000000000000000000000",
                    INIT_09 => X"0000000000000000000000000000000000000000000000000000000000000000",
                    INIT_0A => X"0000000000000000000000000000000000000000000000000000000000000000",
                    INIT_0B => X"0000000000000000000000000000000000000000000000000000000000000000",
                    INIT_0C => X"0000000000000000000000000000000000000000000000000000000000000000",
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
                    INIT_1B => X"0000000000000000000000000000000000000000000000000000000000000000",
                    INIT_1C => X"0000000000000000000000000000000000000000000000000000000000000000",
                    INIT_1D => X"0000000000000000000000000000000000000000000000000000000000000000",
                    INIT_1E => X"0000000000000000000000000000000000000000000000000000000000000000",
                    INIT_1F => X"0000000000000000000000000000000000000000000000000000000000000000",
                    INIT_20 => X"0000000000000000000000000000000000000000000000000000000000000000",
                    INIT_21 => X"0000000000000000000000000000000000000000000000000000000000000000",
                    INIT_22 => X"0000000000000000000000000000000000000000000000000000000000000000",
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
