timvideos/HDMI2USB-TOFE-VGA/examples/hdmi-output-implementation/ise/PB_FMCVIDEO_LPBK.v

// Copyright (c) 2008 by Xilinx, Inc. All rights reserved.
// This text/file contains proprietary, confidential
// information of Xilinx, Inc., is distributed under license
// from Xilinx, Inc., and may be used, copied and/or
// disclosed only pursuant to the terms of a valid license
// agreement with Xilinx, Inc. Xilinx hereby grants you a
// license to use this text/file solely for design, simulation,
// implementation and creation of design files limited
// to Xilinx devices or technologies. Use with non-Xilinx
// devices or technologies is expressly prohibited and
// immediately terminates your license unless covered by
// a separate agreement.
//
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
// Xilinx products are not intended for use in life support
// appliances, devices, or systems. Use in such applications is
// expressly prohibited.
//
// Any modifications that are made to the Source Code are
// done at the user's sole risk and will be unsupported.
//
// This copyright and support notice must be retained as part
// of this text at all times. (c) Copyright 2008 Xilinx, Inc.
// All rights reserved.
//-------------------------------------
// PB_FMCVIDEO_LPBK
// Jason Daughenbaugh
//-------------------------------------
// History of Changes:
//	5-11-2004 JAD: created 
//  5-13-2004 JAD: added LOAD_x ports for loading picoblaze code
//-------------------------------------
// This is a module for storing a program for the KCPSM3 (aka Pico-Blaze)
// The code is assembled as "pbt3" (should be pbt3 for spartan 3)
//-------------------------------------
// Ingredients:
//  1 18kb Block Ram
//-------------------------------------
module PB_FMCVIDEO_LPBK(
	CLK, ADDRESS, INSTRUCTION,
	LOAD_CLK, LOAD_ADDRESS, LOAD_INSTRUCTION, LOAD_WE
	);

input			CLK;
input	[9:0]	ADDRESS;
output	[17:0]	INSTRUCTION;

// Load interface for reloading program
input			LOAD_CLK;
input	[9:0]	LOAD_ADDRESS;
input	[17:0]	LOAD_INSTRUCTION;
input			LOAD_WE;

RAMB16_S18_S18 rom(	
	// Port A: Read Port
	.CLKA(CLK), .ADDRA(ADDRESS),
	.DIA(16'h0000), .DIPA(2'b00), .WEA(1'b0),
	.DOA(INSTRUCTION[15:0]), .DOPA(INSTRUCTION[17:16]),
	.ENA(1'b1), .SSRA(1'b0),
	// port B: Load (write) port
	.CLKB(LOAD_CLK), .ADDRB(LOAD_ADDRESS), 
	.DIB(LOAD_INSTRUCTION[15:0]), .DIPB(LOAD_INSTRUCTION[17:16]), .WEB(LOAD_WE),
	.DOB(), .DOPB(),
	.ENB(1'b1), .SSRB(1'b0)
	);

// synthesis translate_off

defparam rom.INIT_00  = 256'h5038420250314201502B42000087120050035200A00FC000400002FF00570073;
defparam rom.INIT_01  = 256'h5050420A50504209505042085050420750504206504B420550464204503F4203;
defparam rom.INIT_02  = 256'hC004C0030000009B00DD40035050420F5050420E5050420D5050420C5050420B;
defparam rom.INIT_03  = 256'h01404003C0040001C003001A019B01404003C004001EC003001A009B01C64003;
defparam rom.INIT_04  = 256'h4003C004C003000000FD4003C004C003000000E54003C0040004C00300260170;
defparam rom.INIT_05  = 256'h06800503021C136006800502E00200400054A000C00100C0A000C00100804003;
defparam rom.INIT_06  = 256'h0503021C16300502E00200400054A000021C06450507021C064A0506021C1460;
defparam rom.INIT_07  = 256'h06000501021C06800508E00200A4021C06060506E00200E40051A000021C1640;
defparam rom.INIT_08  = 256'h021C06250520E002009A00540069A400A380A00002AC0032021C06000500021C;
defparam rom.INIT_09  = 256'h06070507E00200E40051A000C0020000021C064C0503E002004200540069C301;
defparam rom.INIT_0A  = 256'h0533021C06000549021C06080523021C0643051D021C06090521E00200EC021C;
defparam rom.INIT_0B  = 256'h0D1402AC000A021C06C0054902AC0032021C06600536021C06160534021C0608;
defparam rom.INIT_0C  = 256'h0C14021C06700535021C06080533021C060C0533021C06180548021C06100548;
defparam rom.INIT_0D  = 256'hA480C380A305A00054C0CD0154D4CC0154DCA80402540249E003004DE0010001;
defparam rom.INIT_0E  = 256'hE0020098021C06020502E00200E800540069C331C430A000C00200000069C418;
defparam rom.INIT_0F  = 256'h00540069C305A000C0020003021C06000500E00200E800540114E00200B80114;
defparam rom.INIT_10  = 256'h06000500E00200E800540114E00200B80114E0020098021C06040504E00200E8;
defparam rom.INIT_11  = 256'h0600070005B60229061407000570022906000728057F0054A000C0020004021C;
defparam rom.INIT_12  = 256'h050C02AC0014022906000700050C02290600070005B102290600070005B30229;
defparam rom.INIT_13  = 256'hA00002290600070005B502290601070005B5022906000700050C022906010700;
defparam rom.INIT_14  = 256'h06080503021C06000502021C06100501021C06000500E002005400540069C301;
defparam rom.INIT_15  = 256'h021C067C050A021C061E0509021C06000508021C06020507021C06100504021C;
defparam rom.INIT_16  = 256'hA000021C06020507021C06820507021C0600050D021C0621050C021C06F0050B;
defparam rom.INIT_17  = 256'h021C06550504021C06040500021C060C0503E002004200540069C301C420A4CF;
defparam rom.INIT_18  = 256'h050E021C06A0053F021C066A053E021C06A2053D021C06120531021C06410517;
defparam rom.INIT_19  = 256'h00540069C301C420A4CFA000C0020002021C0600050E021C06810555021C0680;
defparam rom.INIT_1A  = 256'h06A2053D021C06120531021C06550504021C06060500021C060C0503E0020042;
defparam rom.INIT_1B  = 256'h021C06810555021C0680050E021C06040558021C06A0053F021C066A053E021C;
defparam rom.INIT_1C  = 256'h0002C00D001AC00C0000C0090029C008000001E9A000C0020002021C0600050E;
defparam rom.INIT_1D  = 256'h021C0680021C0628021C0600021C06320501C00F00E0C00E0001C00B0080C00A;
defparam rom.INIT_1E  = 256'h06B0051EE002009A00540069A480A000021C061A021C06040519021C06600513;
defparam rom.INIT_1F  = 256'h021C0640021C0600021C0640021C0600021C06400505021C0605021C0694021C;
defparam rom.INIT_20  = 256'h063B051B021C0680021C0600021C0680021C0600021C0680021C0600021C0600;
defparam rom.INIT_21  = 256'h2901025868020284A000C0020001021C06E0021C06E8052D021C060E053C021C;
defparam rom.INIT_22  = 256'h85011850B4002901025868020284A000025D1860B4002901025885011850B400;
defparam rom.INIT_23  = 256'h40006001B4002901025868020284A000025D1860B40002581870B40029010258;
defparam rom.INIT_24  = 256'h0258C80168020284B40029010239A00002586804B0004001600102586803B000;
defparam rom.INIT_25  = 256'h4295026009014295B0002901026009014295026008FF0901426008FF0900A000;
defparam rom.INIT_26  = 256'hC0010008D800A001400102A20A0AC001000C02A20A05C0010000000108060108;
defparam rom.INIT_27  = 256'h0008490102A20A0AC001000C02A20A05C001C002A00110905661C10102A20A05;
defparam rom.INIT_28  = 256'h02A20A05C001000202A20A05C001000C02A20A05C0010003A00002A20A05C001;
defparam rom.INIT_29  = 256'h0A05C001000302A20A05C001000C02A20A05C0010002A00002A20A05C0010008;
defparam rom.INIT_2A  = 256'h02A20AFA02A20AFAA00056A2CA0156A7CB02CB0152A72B01CB060B10A00002A2;
defparam rom.INIT_2B  = 256'h000000000000000000000000000000008000A00056ACC00102A20AFA02A20AFA;
defparam rom.INIT_2C  = 256'h0000000000000000000000000000000000000000000000000000000000000000;
defparam rom.INIT_2D  = 256'h0000000000000000000000000000000000000000000000000000000000000000;
defparam rom.INIT_2E  = 256'h0000000000000000000000000000000000000000000000000000000000000000;
defparam rom.INIT_2F  = 256'h0000000000000000000000000000000000000000000000000000000000000000;
defparam rom.INIT_30  = 256'h0000000000000000000000000000000000000000000000000000000000000000;
defparam rom.INIT_31  = 256'h0000000000000000000000000000000000000000000000000000000000000000;
defparam rom.INIT_32  = 256'h0000000000000000000000000000000000000000000000000000000000000000;
defparam rom.INIT_33  = 256'h0000000000000000000000000000000000000000000000000000000000000000;
defparam rom.INIT_34  = 256'h0000000000000000000000000000000000000000000000000000000000000000;
defparam rom.INIT_35  = 256'h0000000000000000000000000000000000000000000000000000000000000000;
defparam rom.INIT_36  = 256'h0000000000000000000000000000000000000000000000000000000000000000;
defparam rom.INIT_37  = 256'h0000000000000000000000000000000000000000000000000000000000000000;
defparam rom.INIT_38  = 256'h0000000000000000000000000000000000000000000000000000000000000000;
defparam rom.INIT_39  = 256'h0000000000000000000000000000000000000000000000000000000000000000;
defparam rom.INIT_3A  = 256'h0000000000000000000000000000000000000000000000000000000000000000;
defparam rom.INIT_3B  = 256'h0000000000000000000000000000000000000000000000000000000000000000;
defparam rom.INIT_3C  = 256'h0000000000000000000000000000000000000000000000000000000000000000;
defparam rom.INIT_3D  = 256'h0000000000000000000000000000000000000000000000000000000000000000;
defparam rom.INIT_3E  = 256'h0000000000000000000000000000000000000000000000000000000000000000;
defparam rom.INIT_3F  = 256'h42B7000000000000000000000000000000000000000000000000000000000000;
defparam rom.INITP_00 = 256'h0C2308EC308EC30C0C08E8A3E8FA3E23F88FE23FA3FDDDDDDDDDDDDDDDDCD20F;
defparam rom.INITP_01 = 256'hF28C23E38C23C28C02DDCF8830C30C30330CC30C30C30C2308E8C23CC23C2CC3;
defparam rom.INITP_02 = 256'hC30C23C0B0C30C30C30C30C30C30C23CB030303033030303030303A308F8E308;
defparam rom.INITP_03 = 256'hCCCCC33308F2CC30CCCC222222223A30C30C30C30C30C308F028C30C30C30C30;
defparam rom.INITP_04 = 256'h0C8C80DC80323288F39CF0C2C39EC93249CECB2749CEC9D273A330C30CCCCCCC;
defparam rom.INITP_05 = 256'h000000000000000000000000000000000000EDCCCCB75D4B232322C8C8C8C8B2;
defparam rom.INITP_06 = 256'h0000000000000000000000000000000000000000000000000000000000000000;
defparam rom.INITP_07 = 256'hC000000000000000000000000000000000000000000000000000000000000000;

// synthesis translate_on

// synthesis attribute INIT_00  of rom is "5038420250314201502B42000087120050035200A00FC000400002FF00570073"
// synthesis attribute INIT_01  of rom is "5050420A50504209505042085050420750504206504B420550464204503F4203"
// synthesis attribute INIT_02  of rom is "C004C0030000009B00DD40035050420F5050420E5050420D5050420C5050420B"
// synthesis attribute INIT_03  of rom is "01404003C0040001C003001A019B01404003C004001EC003001A009B01C64003"
// synthesis attribute INIT_04  of rom is "4003C004C003000000FD4003C004C003000000E54003C0040004C00300260170"
// synthesis attribute INIT_05  of rom is "06800503021C136006800502E00200400054A000C00100C0A000C00100804003"
// synthesis attribute INIT_06  of rom is "0503021C16300502E00200400054A000021C06450507021C064A0506021C1460"
// synthesis attribute INIT_07  of rom is "06000501021C06800508E00200A4021C06060506E00200E40051A000021C1640"
// synthesis attribute INIT_08  of rom is "021C06250520E002009A00540069A400A380A00002AC0032021C06000500021C"
// synthesis attribute INIT_09  of rom is "06070507E00200E40051A000C0020000021C064C0503E002004200540069C301"
// synthesis attribute INIT_0A  of rom is "0533021C06000549021C06080523021C0643051D021C06090521E00200EC021C"
// synthesis attribute INIT_0B  of rom is "0D1402AC000A021C06C0054902AC0032021C06600536021C06160534021C0608"
// synthesis attribute INIT_0C  of rom is "0C14021C06700535021C06080533021C060C0533021C06180548021C06100548"
// synthesis attribute INIT_0D  of rom is "A480C380A305A00054C0CD0154D4CC0154DCA80402540249E003004DE0010001"
// synthesis attribute INIT_0E  of rom is "E0020098021C06020502E00200E800540069C331C430A000C00200000069C418"
// synthesis attribute INIT_0F  of rom is "00540069C305A000C0020003021C06000500E00200E800540114E00200B80114"
// synthesis attribute INIT_10  of rom is "06000500E00200E800540114E00200B80114E0020098021C06040504E00200E8"
// synthesis attribute INIT_11  of rom is "0600070005B60229061407000570022906000728057F0054A000C0020004021C"
// synthesis attribute INIT_12  of rom is "050C02AC0014022906000700050C02290600070005B102290600070005B30229"
// synthesis attribute INIT_13  of rom is "A00002290600070005B502290601070005B5022906000700050C022906010700"
// synthesis attribute INIT_14  of rom is "06080503021C06000502021C06100501021C06000500E002005400540069C301"
// synthesis attribute INIT_15  of rom is "021C067C050A021C061E0509021C06000508021C06020507021C06100504021C"
// synthesis attribute INIT_16  of rom is "A000021C06020507021C06820507021C0600050D021C0621050C021C06F0050B"
// synthesis attribute INIT_17  of rom is "021C06550504021C06040500021C060C0503E002004200540069C301C420A4CF"
// synthesis attribute INIT_18  of rom is "050E021C06A0053F021C066A053E021C06A2053D021C06120531021C06410517"
// synthesis attribute INIT_19  of rom is "00540069C301C420A4CFA000C0020002021C0600050E021C06810555021C0680"
// synthesis attribute INIT_1A  of rom is "06A2053D021C06120531021C06550504021C06060500021C060C0503E0020042"
// synthesis attribute INIT_1B  of rom is "021C06810555021C0680050E021C06040558021C06A0053F021C066A053E021C"
// synthesis attribute INIT_1C  of rom is "0002C00D001AC00C0000C0090029C008000001E9A000C0020002021C0600050E"
// synthesis attribute INIT_1D  of rom is "021C0680021C0628021C0600021C06320501C00F00E0C00E0001C00B0080C00A"
// synthesis attribute INIT_1E  of rom is "06B0051EE002009A00540069A480A000021C061A021C06040519021C06600513"
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
// synthesis attribute INITP_06 of rom is "0000000000000000000000000000000000000000000000000000000000000000"
// synthesis attribute INITP_07 of rom is "C000000000000000000000000000000000000000000000000000000000000000"


endmodule
