timvideos/HDMI2USB-TOFE-VGA/(commit log)

2013-07-21 components added in schema
    [vmodvga.sch]
2013-07-21 CONN_15 Added
    [vmodvga.sch]
2013-07-21 voltage regulator added
    [vmodvga.sch]
2013-07-23 Schema complete
    [vmodvga.sch]
2013-07-24 VHDCI foot print started
    [vmodvga.kicad_pcb]
2013-07-25 LST and BOM generated
    [BOM.csv, vmodvga.sch]
2013-07-25 DE-15 foot print created
2013-07-25 Footprints assigned
2013-07-25 Corrected one wrong label and footprint
    [BOM.csv, vmodvga.sch]
2013-07-26 Initial component placement
    [BOM.csv, vmodvga.kicad_pcb, vmodvga.sch]
2013-07-26 Two VGA connectors without terminal resistors
    [vmodvga.kicad_pcb]
2013-07-27 Started with PCB design
    [vmodvga.kicad_pcb, vmodvga.sch]
2013-07-27 switching to 4 layers
    [vmodvga.kicad_pcb, vmodvga.sch]
2013-07-28 Two Layer Design Complete
    [vmodvga.kicad_pcb, vmodvga.sch]
2013-07-29 Some labels moved to proper location
    [vmodvga.kicad_pcb]
2013-07-29 some updates and pdf generated
    [vmodvga.kicad_pcb]
2014-05-15 [GSoC]: Initial Schematic commit
    Initial Schematic for VGA Capture expansion board, based on original
    design by Jahanzeb
    [powerSupply.sch, vgaExp_v01.sch]
2014-05-31 Fixed the feedback circuit for ADP3334 ICs in schematic
    Fixed the feedback circuit for ADP3334 Variable o/p voltage LDO ICs
    which was resulting in incorrect output voltages on PD and VD lines.
    [powerSupply.sch, vgaExp_v01.sch]
2014-06-02 Footprint assignment and PCB components placement
    Parts assigned (along with updated VHDCI and QFP80 footprints) and
    components placed just at same place as in previous design. Also, there
    is one more project with longer pads for QFP80 footprint
    [powerSupply.sch, vgaExp_v01.kicad_pcb, vgaExp_v01.sch, vgaExp_v01_LongerPads.kicad_pcb]
2014-06-19 Added code for HDMI_Test_v04
    Fixed the messy capture. Nice improvement in capturing. Still quite a
    number of flickers. Main capture file is vgacapture.vhd
    [rising_edge_detect.vhd, serdes_n_to_1.v, synchro.v, vgacapture.vhd, vtc_demo.vhd]
2014-06-27 Added I2C Test codes and updated README
2014-06-28 Corrected delayer. Added new delayer.vhd Result: No effect Only image shifts to left
    [vgacapture.vhd]
2014-06-28 Added bunch of new I2C test files. Added delayer.vhd and its testbench
2014-07-05 Added I2C Files
2014-07-10 Added Library for I2C EEPROM. Cleaned up
    [vgaExp.kicad_pcb, vgaExp.sch]
2014-07-10 Added Symbols for I2C Buffer
    [i2c.sch, powerSupply.sch, vgaExp.sch]
2014-07-10 Fixed some ERC Errors
    [i2c.sch, vgaExp.sch]
2014-07-10 All ERC Errors fixed
    [i2c.sch, powerSupply.sch, vgaExp.sch]
2014-07-11 Added TestPoints
    [i2c.sch, powerSupply.sch, vgaExp.sch]
2014-07-17 Spli Designs into 2 parallel versions
    [i2c.sch, powerSupply.sch, vgaExp.kicad_pcb, vgaExp.sch]
2014-07-17 Revert "Spli Designs into 2 parallel versions"
    This reverts commit 42eaffe06f4d6f8e476330e2d6c2b6b5f4536701.
    [i2c.sch, powerSupply.sch, vgaExp.kicad_pcb, vgaExp.sch]
2014-07-17 Revert "Revert "Spli Designs into 2 parallel versions""
    This reverts commit b580d7db8ba6dc8373a5b573116ba9034fe4eb40.
    [i2c.sch, powerSupply.sch, vgaExp.kicad_pcb, vgaExp.sch]
2014-07-17 Added header for unused Pins
    Unused pins are OE_Field, COAST, CLAMP and PWRDWN
    [i2c.sch, powerSupply.sch, vgaExp.sch]
2014-07-21 PCB Routing
    70% tracks routed. Fine tuning remaining
    [i2c.sch, powerSupply.sch, vgaExp.kicad_pcb, vgaExp.sch, vmodvga.kicad_pcb]
2014-07-21 All tracks routed. Optimizations and dine tuning remain
    [vgaExp.kicad_pcb]
2014-07-21 All Tracks routed. Tweaks. Ready for review
    All Tracks routed. Tweaks. Ready for review. Some minor changes and
    tweaks may be done before sending for Fab
    [vgaExp.kicad_pcb]
2014-07-22 Added LICENSE
    [vgaExp.kicad_pcb]
2014-07-22 Removed Type_II thing. It was useless
    [i2c.sch, powerSupply.sch, vgaExp.kicad_pcb, vgaExp.sch]
2014-07-22 Moved designs
    [i2c.sch, powerSupply.sch, vgaExp.kicad_pcb, vgaExp.sch, vmodvga.kicad_pcb, vmodvga.sch]
2014-07-22 Changing Layout
    [i2c.sch, powerSupply.sch, vgaExp.kicad_pcb, vgaExp.sch]
2014-07-22 Layout changes and initial rough placement
    [vgaExp.kicad_pcb]
2014-07-23 routing 30% complete
    [vgaExp.kicad_pcb]
2014-07-23 Added Standoffs
2014-07-23 Added Standoffs. Fixed Issue #11
    [vgaExp.kicad_pcb]
2014-07-23 Fixed #11
    [vgaExp.kicad_pcb]
2014-07-23 Added GND Testpoint. Fixes #10
    Added GND Testpoint at board's periphery
    [vgaExp.kicad_pcb]
2014-07-24 Progress so far
    [vgaExp.kicad_pcb]
2014-07-24 Routing complete. Also Fixes #6
    [i2c.sch, powerSupply.sch, vgaExp.kicad_pcb, vgaExp.sch]
2014-07-24 Fixed #14
    [vgaExp.kicad_pcb]
2014-07-25 Fixed #20. Fixed #16
    [vgaExp.kicad_pcb]
2014-07-25 Rev: v02 without length-matching
    [vgaExp.kicad_pcb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]
2014-07-25 Rev: 02 without length-matching
    [vgaExp-B_Cu.gbl, vgaExp-B_Mask.gbs, vgaExp-B_SilkS.gbo, vgaExp-Edge_Cuts.gbr, vgaExp-F_Cu.gtl, vgaExp-F_Mask.gts, vgaExp-F_SilkS.gto]
2014-07-25 Fixed Keepout Areas
    [vgaExp.kicad_pcb]
2014-07-29 50% length matched
    R[9:0], DATACK, VSOUT, HSOUT, SOGOUT, RGB
    [vgaExp.kicad_pcb]
2014-07-29 80% length matching done
    [vgaExp.kicad_pcb]
2014-07-29 100% track length-matched
    [vgaExp.kicad_pcb]
2014-07-29 Fixes #22. Fixes #12. Fixes #9
    [vgaExp-B_Cu.gbl, vgaExp-B_Mask.gbs, vgaExp-B_SilkS.gbo, vgaExp-Edge_Cuts.gbr, vgaExp-F_Cu.gtl, vgaExp-F_Mask.gts, vgaExp-F_SilkS.gto, vgaExp.drl]
2014-07-29 Changed vias to 0.6dia, 0.3drill
    Also reduced width of power tracks from IC from 0.500mm toh 0.400mm
    [vgaExp.kicad_pcb]
2014-07-29 Changes vias to 0.6dia, 0.3drill
    Also fixed Capacitor Silkscreen and Power supply pins track width going
    into ICs
    [vgaExp-B_Cu.gbl, vgaExp-B_Mask.gbs, vgaExp-B_SilkS.gbo, vgaExp-Edge_Cuts.gbr, vgaExp-F_Cu.gtl, vgaExp-F_Mask.gts, vgaExp-F_SilkS.gto, vgaExp.drl]
2014-07-29 Top Layer Copper Pour
    [vgaExp.kicad_pcb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]
2014-07-29 Ground stiching
    [vgaExp.kicad_pcb]
2014-08-05 Added I2C picoblaze core
    [ad9984a_init.psm, ad9984a_init_bak.psm, ad9984a_init_pcf9574a_test.psm, i2c_routines.psm, soft_delays_100mhz.psm]
2014-08-21 Added Bill of Materials
    [vgaExp.csv, vgaExp.xlsx]
2014-08-21 Directory restructuring
    [ad9984a_init.psm, ad9984a_init_bak.psm, ad9984a_init_pcf9574a_test.psm, i2c_routines.psm, soft_delays_100mhz.psm]
2015-10-15 Adding information about board shape.
2015-10-15 Initial version of the template.
    [TOFE-Expansion-Board-Full-Height.kicad_pcb, TOFE-Expansion-Board-Half-Height.kicad_pcb, TOFE-Expansion-Board.sch]
2015-10-15 Update from Anoop.
    Fixes #1.
    [TOFE-Expansion-Board.sch]
2015-10-15 Updating the PCB with dimensions.
    Fixes #2.
    [TOFE-Expansion-Board-Full-Height.kicad_pcb, TOFE-Expansion-Board-Half-Height.kicad_pcb]
2015-10-15 Updating the board images with dimensions.
2015-10-15 Adding script to quickly rename the schematic.
2015-10-15 Adding 1x and 4x TOFE schematic parts.
2015-10-15 Fixing the EEPROM pin connections.
    [TOFE-Expansion-Board.sch]
2015-10-28 Creating TOFE-VGA!
    [TOFE-Expansion-Board-Full-Height.kicad_pcb, TOFE-VGA.kicad_pcb, TOFE-VGA.sch]
2015-10-28 Removing files which shouldn't be committed.
    [vgaExp.kicad_pcb]
2015-10-28 Removing files which won't be needed after merge.
    [BOM.csv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]
2015-10-28 Generate PDFs of vgaExp board for reference
2015-10-29 Upgrading schematic to KiCad 4.0.0rc1
    [TOFE-Expansion-Board.sch]
2015-10-29 Adding fp-lib-table needed for KiCad 4.0.0rc1
2015-10-29 schematic: Fixing GND alignment after last change.
    [TOFE-Expansion-Board.sch]
2015-11-08 Upgrade schematic
    [TOFE-VGA.sch, i2c.sch, powerSupply.sch, vgaExp.sch]
2015-11-13 Refactoring for TOFE
    [TOFE-VGA.sch, ad9984.sch, power.sch, tofe.sch, vga.sch]
2015-11-25 Add component inputs for AD9984 secondardy inputs
    [TOFE-VGA.sch, ad9984.sch, component.sch]
2016-01-10 Connect component hierarchical pins
    [TOFE-VGA.sch, power.sch, tofe.sch, vga.sch]
2016-01-10 Rearange connections to TOFE to put HSOUT, VSOUT and DATAK on CLK pins and not using DIFF_CLK_X pair
    [tofe.sch]
2016-01-10 Add jumper for EEPROM WP and breakout unused pins to header that can jumper to LEDs
    [tofe.sch]
2016-01-10 Added headers for the 4 I2C buses
    [vga.sch]
2016-01-10 Add LEDs to power lines and remove 3v3 regulator
    [power.sch]
2016-01-10 Added I2C to the labels for I2C
    [vga.sch]
2016-01-10 Add I2C headers
    [ad9984.sch, tofe.sch]
2016-01-10 Use the same filtering as before for the 3v3
    [power.sch]
2016-01-10 Add pullup resistor to EEPROM WP
    [tofe.sch]
2016-01-10 Connect I2C level shifter EN to TOFE
    [TOFE-VGA.sch, tofe.sch, vga.sch]
2016-01-12 Add correct value for 1v8 power LEDs
    [power.sch]
2016-01-12 Start assigning footprints
    [ad9984.sch, component.sch, power.sch, tofe.sch, vga.sch]
2016-01-13 More footprint assigning and generated Netlist
    [ad9984.sch, power.sch, tofe.sch]
2016-01-13 Found better LED for 1v8
    [power.sch]
2016-01-15 More footprint assigning
    [ad9984.sch, tofe.sch, vga.sch]
2016-01-15 More footprints
    [TOFE-VGA.sch, ad9984.sch, component.sch, power.sch, tofe.sch, vga.sch]
2016-01-16 Finish footprint assignment
    [ad9984.sch, component.sch, tofe.sch, vga.sch]
2016-01-16 Fix old footprint name
    [tofe.sch]
2016-01-20 Ignore kicad pcb backup files
2016-01-20 Started rough layout of pcb
    [TOFE-VGA.kicad_pcb]
2016-01-20 Remove component input to allow design to fit on smaller and much cheaper board
    [TOFE-VGA.kicad_pcb, TOFE-VGA.sch, ad9984.sch, power.sch, tofe.sch, vga.sch]
2016-01-20 Use smaller testpoint pad
    [ad9984.sch]
2016-01-20 Grouping components together on board
    [TOFE-VGA.kicad_pcb]
2016-04-22 Misc things not commited yet
    [TOFE-VGA.kicad_pcb]
2016-07-25 Removing vgaExp board.
    [vgaExp.csv, vgaExp.kicad_pcb, vgaExp.sch]
2016-07-26 Revert "Remove component input to allow design to fit on smaller and much cheaper board"
    This reverts commit 3f82e6bce0114ba152d89a6e304191ec714e8d54.
    [TOFE-VGA.sch, ad9984.sch, power.sch, tofe.sch, vga.sch]
2016-07-26 Adding an analog ground.
    [ad9984.sch, component.sch, vga.sch]
2016-07-26 Small fixes to power supplies.
    [ad9984.sch, power.sch, tofe.sch]
2016-07-26 Lots of small fixes.
    [TOFE-VGA.sch, ad9984.sch, component.sch, power.sch, tofe.sch, vga.sch]
2016-07-26 More fixes.
    [power.sch, tofe.sch, vga.sch]
2016-07-26 Updating netlist.
    [ad9984.sch, power.sch]
2016-07-26 Adding new parts.
    [TOFE-VGA.kicad_pcb, ad9984.sch]
2016-07-30 Initial PCB design by Phyllis.
    [TOFE-VGA.kicad_pcb]
2016-07-30 Adding a way to disconnect the output from the input.
    [TOFE-VGA.kicad_pcb, TOFE-VGA.sch, ad9984.sch, power.sch, tofe.sch, vga.sch]
2016-07-30 Couple more GND<->GNDA coupling capacitors.
    [TOFE-VGA.kicad_pcb, TOFE-VGA.sch, ad9984.sch, power.sch, tofe.sch, vga.sch]
2016-07-31 Lots of small tweaks.
    * Giving things better reference names.
    * Giving a bunch of nets names.
    [TOFE-VGA.kicad_pcb, TOFE-VGA.sch, ad9984.sch, power.sch, tofe.sch]
2016-07-31 More and hopefully better labelling.
    [TOFE-VGA.sch, ad9984.sch, power.sch, tofe.sch, vga.sch]
2016-07-31 Update to PCB.
    [TOFE-VGA.kicad_pcb]
2016-08-04 Fix direction of the component pins.
    [TOFE-VGA.sch, vga.sch]
2016-08-04 Updating net names.
    [TOFE-VGA.kicad_pcb, TOFE-VGA.sch, ad9984.sch, power.sch, tofe.sch, vga.sch]
2016-08-04 Lots of small updates.
    [TOFE-VGA.sch, ad9984.sch, power.sch, tofe.sch, vga.sch]
2016-08-04 Importing net into PCB.
    [TOFE-VGA.kicad_pcb]
2016-08-04 ERC and removing 0 from vsync/hsync.
    [TOFE-VGA.sch, ad9984.sch, tofe.sch, vga.sch]
2016-08-04 Updating the PCB.
    [TOFE-VGA.kicad_pcb]
2016-08-04 Giving things better names.
    [ad9984.sch, tofe.sch, vga.sch]
2016-08-04 Updating PCB.
    [TOFE-VGA.kicad_pcb]
2016-08-04 Moving I2C enable pins to make IO1 a NC.
    [power.sch, tofe.sch, vga.sch]
2016-08-09 Small updates from review by RattusRattus.
    [ad9984.sch, power.sch]
2016-08-10 Added ESD protection to video inputs Changed level shifter to TPSDS019 because it also contains ESD protection
    [vga.sch]
2016-08-11 Small cleanups.
    * Move TPD7S019 and SP724AH into their own library.
    * Use 2 x 100nF capacitors for TPD7S019 bypass (save a part line).
    * Adding a couple of notes.
    [TOFE-VGA.sch, ad9984.sch, power.sch, tofe.sch, vga.sch]
2016-08-11 Assigning footprints.
    [vga.sch]
2016-09-13 Change TOFE connections as per changes requested for PCB design
    Note: `DATACK` & `SOGOUT` have been swapped from the original request
    keeping in mind compatibilty for 7-series boards. Please swap them
    back again if absolutely required.
    [tofe.sch]
2016-09-14 Trying to import new netlist.
    [TOFE-VGA.kicad_pcb, vga.sch]
2016-09-19 Remove the two lines not supported by stable KiCad.
    [TOFE-VGA.kicad_pcb]
2016-10-01 Lots of small fixes to the schematic.
    [TOFE-VGA.sch, power.sch, tofe.sch, vga.sch]
2016-10-01 Fixing the footprint for lots of things.
    * Capacitors 0805 or can.
    * Resistors 0603.
    [ad9984.sch, power.sch, tofe.sch, vga.sch]
2016-10-01 Import and update netlist.
    [TOFE-VGA.kicad_pcb, tofe.sch]
2016-10-03 Updated PCB from Phyllis.
    [TOFE-VGA.kicad_pcb]
2016-10-03 Updating PCB from net list.
    [TOFE-VGA.kicad_pcb]
2021-11-10 Update README.md
    https://forum.kicad.info/t/warning-avoid-all-links-to-kicad-pcb-org-use-kicad-org/31521
