timvideos/HDMI2USB-TOFE-VGA/(notices)

Notices in the files:
board/power.sch:
License: CC BY SA 4.0 or TAPR
